pl-coder/LeLovophon/outputs/Lovophone_Corrected_Right_Compositing.md

# Corrected Lovophone - right-view compositing render

The full film covers exactly480 seconds at normal speed: one8-minute ideal mechanical phase cycle, input3 rpm. It is silent. Orthographic RIGHT camera along the native CAD+X axis, matching the supplied screenshot.1008 x900;12 unique motion samples per second. The alpha master stores12 fps and the MP4 stores24 fps with duplicate frames; both run480 seconds at normal speed.

## Choose a file

- Lovophone_Corrected_Right_8min_Alpha.mov: ProRes4444 with alpha,12 fps, approximately2.68 GB. Import directly over your background in a video editor. No colour key is needed. It may look black in players that do not display transparency.
- Lovophone_Corrected_Right_8min_Blue.mp4: H264 copy with pure blue background composited after rendering. Key blue if you need an MP4 workflow. The transparent master will preserve thin strings and edges more reliably than keying compressed colour.
- Lovophone_Corrected_Right_Transparent.blend: self-contained textured scene and corrected animation.
- Preview_10sec files: short samples only; not the full cycle.

No key-colour lighting or spill was added to the instrument: blue is composited afterwards. The rendered alpha is carried separately through mild RGB noise reduction. The full ProRes master was decoded at the midpoint and its alpha checked: range0..65535, fully transparent background corner.

## Timing and design scope

Pitch and cam ratios:1,9/8,5/4,3/2,5/3,2,9/4,5/2,3,10/3,4,9/2. All return after24 input revolutions. Frame1 is nominal time zero. This is the corrected Lab Frame ratio-review animation, retaining its cam/follower and swing-amplifier belt. The separate four-bar physical prototype is not installed in this model.

Motor, obsolete tray, foreground drive plate and selected colliding right-foot hardware are hidden to expose the mechanism. This is a presentation cutaway, not a production clearance or structural solution. Reference pulley envelopes are not approved supplier tooth profiles.

The older Lab Frame MIDI and the separate Unified picking-wheel MIDI do not match this corrected cam/pick animation.120 BPM does not make an old MIDI sequence align. Physical release angles, torque and manufacturing still require prototype tests.
