pl-coder/LeLovophon/outputs/Lovophone_Lab_Frame_Corrected_Readme.md

# Corrected Lab Frame video

The video runs for480 seconds at normal speed and covers one complete ideal mechanical phase cycle. Input speed3 rpm; pitch and cam rotation ratios1,9/8,5/4,3/2,5/3,2,9/4,5/2,3,10/3,4,9/2. All voice phases return after24 input revolutions. No timing correction is achieved by changing video playback speed.

This is the Lab Frame ratio-review model, retaining its cam/follower and swing belt. The separate Prototype A four-bar mechanism has not been fitted to the twelve-voice machine. Reference pulley envelopes were updated. Obsolete tray and colliding right-foot mounting parts are hidden to expose the mechanism; hiding them is not a production mounting solution. The video is an ideal kinematic visualization, not proof of a buildable or tested machine.

1008x720,24 fps encoded,12 unique motion samples per second, silent. Clean CAD studio shading, rather than the older photorealistic material render. Exact480-second endpoint was checked in the animation scene, with maximum matrix coefficient error2.88e-5 from float32 animation sampling.

Do not align this with the older Lab Frame MIDI or the Unified picking-wheel MIDI. A matching MIDI file has not yet been generated from this corrected cam/pick release motion.120 BPM alone cannot correct an old event sequence.
