pl-coder/LeLovophon/outputs/Lovophone_Right_View_Render_Notes.md

# Lovophone: right-view studio film

The camera matches the supplied FreeCAD RIGHT view. The motor, coupling, mounting bracket, controller, switch, power connector and clear motor covers are hidden for presentation. The musical mechanism and supporting frame remain visible.

The full film is eight minutes at normal speed, 24 frames per second, 1008 × 900 pixels. Align the start of the existing eight-minute pentatonic MIDI with video time 0:00; use 120 BPM. The film is silent.

The editable scene retains the actual exported CAD geometry and animation, with procedural wood and metal materials and five studio lights. The supplied still uses Cycles path tracing. The film uses EEVEE with 32 samples and spatial and temporal noise reduction to keep a long render practical. These are presentation materials, not a claim of manufactured finish or a physical performance simulation.

Outputs are created in this order: a 20-second preview, then the complete eight-minute MP4. The final film filename is Lovophone_Right_View_No_Motor_8min.mp4. Until that file appears, the full film has not finished rendering.
