pl-coder/LeLovophon/outputs/Lovophone_Prototype_A/Prototype_A_Drawings.pdf

# Build the mechanism before the instrument

Two independent manual test fixtures: one-string pluck and exact 9:2 drive. No motor purchase required yet.

LE LOVOPHONE | Prototype A | Rev A / 2026-11-05 | mm | QUOTATION & ENGINEERING REVIEW | 1 / 8

Purpose: test the two things the presentation model could not establish - clean mechanical plucking, and a practical high-ratio transmission.

The pluck fixture uses a fully pinned 4-bar: 4 mm crank, 80 mm connecting rod, 14 mm rocker and 80 mm fixed pivot spacing. It forces both directions without a follower spring or 4x swing belt.

The drive fixture uses (60/20) x (30/20) = 9/2 with two nominal 160 mm, 80-tooth, 2 mm pitch, 6 mm wide belts and 5 mm shafts. Supplier profile confirmation is still required.

Lowest voice: C3, 330 mm speaking string, 67.196938 mm arm. Highest voice: D5, 73.333333 mm speaking string, 14.932653 mm arm. Swap arm and string height; do not treat the two as simultaneously assembled voices.

Computed swing: +/-16.662 degrees. Link closure checked at 10,001 phases; minimum transmission angle 68.526 degrees. These are geometric results, not evidence of successful physical plucks.

Procurement gate: DHM lists the belt as GT2 today but S2M in an older catalogue. Its pulley pages also warn of batch dimensional variation. Verify a matched set and hub/flange dimensions before manufacture of spacers or pulley-adjacent parts.

No physical prototype has been built or tested. This packet is for engineering review and quotation; it is not certification that the full Lovophone works.

# R01 / Exact 9:2 drive fixture

2 identical cheeks: aluminium 6061-T6, 180 x 100 x 6. Bearing carriers allow +/-3 mm adjustment.

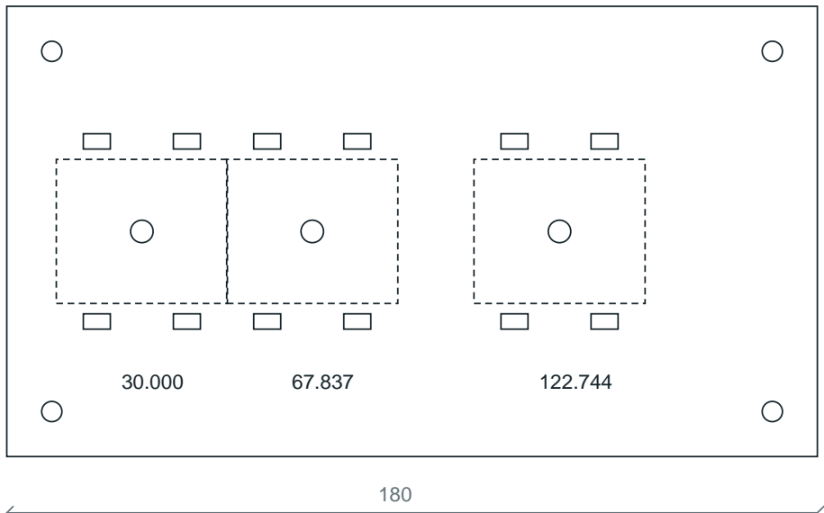
[picture p1: figure]

LE LOVOPHONE | Prototype A | Rev A / 2026-11-05 | mm | QUOTATION & ENGINEERING REVIEW | 2 / 8
37.837 | 54.908

Shafts: (X,Y) = (30,50), (67.836782,50), (122.744491,50). Positions are nominal untensioned pitch geometry.

4 x 4.5 through holes: (10,10), (170,10), (10,90), (170,90).

At each shaft: central relief slot 32 diameter with 6 mm horizontal centre travel (38 x32 overall). Neighbouring reliefs may merge.

Carrier mount slots: 3.4 wide, 6 mm centre travel (9.4 overall), centres at shaft X +/-10;
Y=30 and70. Use STEP for exact rounded slots.

Outside cheek Z=0..6 and56..62; four spacer tubes OD8/ID4.5 x50 between them. M4 threaded tie rods and washers/nuts for bench assembly.

Pulley belt midplanes Z=14 and38. 60/20 first stage, 30/20 second. Intermediate shaft carries 20T and30T clamped together.

Pulley body/hub/flange geometry in assembly CAD is a clearance reservation, not a supplier
drawing. Do not machine reference discs.

# R02 / R03 Bearing carriers and retainers

6 identical carriers; 6 identical retainer disks. Axial load is retained by shoulders and screws.

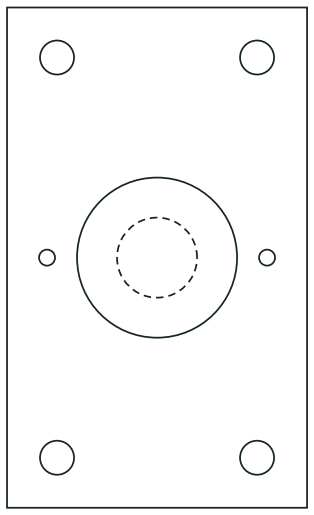
[picture p2: figure]

LE LOVOPHONE | Prototype A | Rev A / 2026-11-05 | mm | QUOTATION & ENGINEERING REVIEW | 3 / 8

R02 - view into bearing pocket

R03 - 1 mm stainless

R02: 30 x50 x6, 6061-T6. Local origin at lower-left. Bearing centre (15,25).

16 H7 pocket (+0/+0.018), depth5 from inner face. 8 through bore leaves a 1 mm outer shoulder. Do not substitute a laser-cut bearing seat.

4 x3.4 through at (5,5),(25,5),(5,45),(25,45).

2 x M2 tapped through, centres (4,25),(26,25). STEP shows 1.6 pilot holes; tap to drawing.

R03: 27 OD /8 ID x1 stainless. 2 x2.2 through at +/-11 along horizontal diameter.

625-ZZ bearings: 5 x16 x5. Retainer screws M2x5; check no screw end protrudes into another part. Front carrier is mirrored in assembly.

Fit 5 mm ground shafts, with separate shaft collars bearing only against inner races. Set axial play without preloading the bearings.

General machined dimensions +/-0.10 unless stated; pocket depths +/-0.03; deburr 0.2 max at bearing shoulder.

# P01 / One-string linkage cheeks

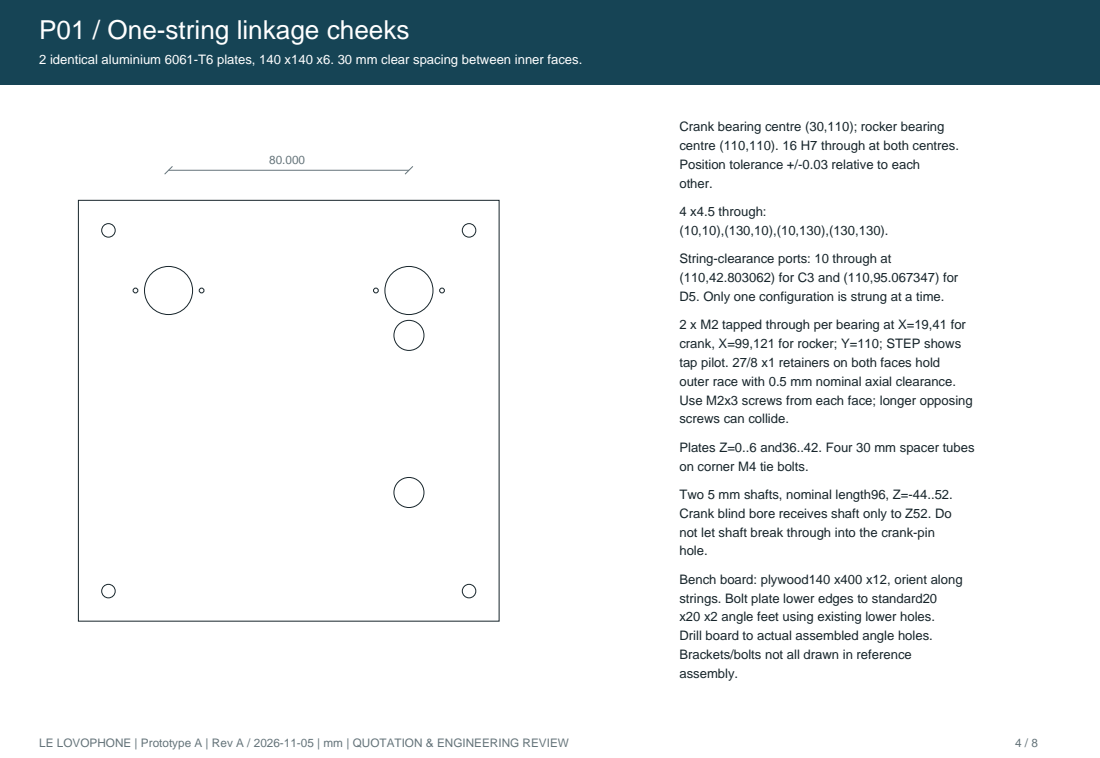
[picture p3: page 4]
LE LOVOPHONE | Prototype A | Rev A / 2026-11-05 | mm | QUOTATION & ENGINEERING REVIEW

2 identical aluminium 6061-T6 plates, 140 x140 x6. 30 mm clear spacing between inner faces.

Crank bearing centre (30,110); rocker bearing
centre (110,110). 16 H7 through at both centres.
Position tolerance +/-0.03 relative to each
other.
4 x4.5 through:
String-clearance ports: 10 through at
(110,42.803062) for C3 and (110,95.067347) for
D5. Only one configuration is strung at a time.
2 x M2 tapped through per bearing at X=19,41 for
crank, X=99,121 for rocker; Y=110; STEP shows
tap pilot. 27/8 x1 retainers on both faces hold
outer race with 0.5 mm nominal axial clearance.
Use M2x3 screws from each face; longer opposing
screws can collide.
Plates Z=0..6 and36..42. Four 30 mm spacer tubes
on corner M4 tie bolts.
Two 5 mm shafts, nominal length96, Z=-44..52.
Crank blind bore receives shaft only to Z52. Do
not let shaft break through into the crank-pin
hole.
Bench board: plywood140 x400 x12, orient along
strings. Bolt plate lower edges to standard20
x20 x2 angle feet using existing lower holes.
Drill board to actual assembled angle holes.
Brackets/bolts not all drawn in reference
assembly.

# P02 / P03 Positive-drive crank and rocker

Split hubs clamp to 5 mm shafts. Small pin hole and large shaft bore are separated axially in the crank.

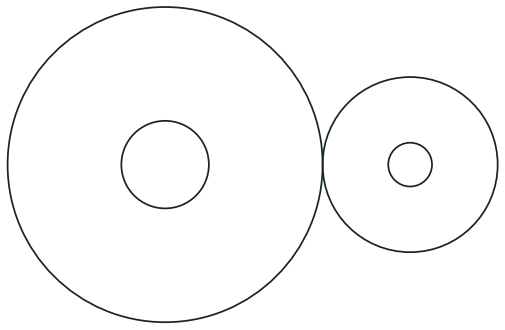
[picture p4: figure]

LE LOVOPHONE | Prototype A | Rev A / 2026-11-05 | mm | QUOTATION & ENGINEERING REVIEW | 5 / 8
P02: 20 OD x12; front view | P03: 14 pin-centre radius

P02: 20 OD x12, 6061-T6. Rear shaft bore5 H7 blind depth6. Front M3 thread blind depth4,
centre at (4,0). Preserve 2 mm web between bore floors.

P03: hub18 OD x12, pin boss10 OD x12, centres14 apart; 10 mm wide x6 connecting web. 5 H7 through hub; M3 blind depth4 from front at pin centre.

Both hubs: rear split0.8 wide from bore towards +Y, depth6. M3 clamping bolt transverse X at localY=6,Z=3. Left half3.4 clearance; right half M3 tapped (STEP pilot2.5). Use M3x16; machine seating flats if required for head and thread engagement.

P02/P03 sit at Z46..58. Both pin flanges sit on
front Z58 so rod journals align.

Do not use an ordinary through-drilled crank: 5
mm shaft and3 mm pin at4 mm spacing would touch. The blind, two-sided construction is deliberate.

Machinist to confirm M3 thread engagement, clamp seating and no split closes fully before
gripping shaft. No adhesive or friction roller substitutes for pin capture.

# P04 / P05 Coupler, arms and replaceable picks

One long arm installed; short arm is a swap part. The two configurations retain inverse musical lengths.

LE LOVOPHONE | Prototype A | Rev A / 2026-11-05 | mm | QUOTATION & ENGINEERING REVIEW | 6 / 8

80 +/-0.05

P04: POM-C, 4 thick, plain bearing link

C3 | D5

P04: POM-C, 4 thick, 10 wide, rounded5-radius ends. Pin centres80 +/-0.05. Two3.02..3.04 through holes for3 h6 journal pins. The rod is a cheap replaceable dry bearing component.

P05 aluminium arms: 18 OD x8 split-clamp hub with5 H7 bore; 6 wide x3 body. Pivot-to-string radius67.196938 (C3) or14.932653 (D5). Rigid tip stops1 mm short.

Pick mount3.4 through at radius R-5 on arm centreline. Hub clamp detail follows P03.

Pick trial strips: PET0.5 thick, 6 wide x7.3 long; 3.4 mounting hole5.3 back from tip. Shim/slot to find minimum reliable string intrusion. CAD shows0.3 mm nominal; this is a test setting, not a proven release geometry.

Arm plane Z=-35..-32; hub toZ=-27. Pick on front faceZ=-32..-31.5. Set arm vertical when rocker is at its measured mid-angle (94.8116 degrees nominal).

Rigid arm must never contact the string. Test both directions; the return stroke may double-pluck or drag. If it does, develop a one-way compliant pick before scaling to twelve voices.

# P07 / P08 Retained pins and string tensioning

Turned journal pins; guided M4 drawbar. Standard threaded fasteners shown as pilot / major cylinders in STEP.

LE LOVOPHONE | Prototype A | Rev A / 2026-11-05 | mm | QUOTATION & ENGINEERING REVIEW | 7 / 8

P07 - TWO IDENTICAL TURNED PINS, STEEL: from rear to front, M3 x4 male root, 5 OD x1 flange, 3 h6 x9 journal, M2 x3 threaded tip. Add standard thread reliefs without reducing the usable journal. Install root into M3 blind crank / rocker
hole; flange seats on front face. Retain with M2 nut and plain washer. Add 3.0 mm and 1.9 mm ID3.1 / OD5 spacers around the4 mm POM link; total stack8.9 leaves nominal0.1 mm axial play. Check free rotation after tightening, and use a locknut
or equivalent positive locking method. Pins are custom turned parts, not plain dowels.

P06 - TWO END POSTS: aluminium6061-T6, 40 x125 x4. Local origin lower-left. Guide holes4.5 through at X20, Y42.803062 and95.067347. At each height add M4-screw clearance4.5 atX30 and guide-rod4 H7 atX10. Bottom mounting holes4.5 at(5,8) and(35,8). Guide holes for nylon need rounded, polished eyelets: no string on a raw aluminium edge.

P08 - TWO GUIDED DRAWBARS: brass or aluminium32 x12 x10. Local origin at centre in XY, rear faceZ0. Through M4 thread at(X10,Y0), guide bore4.2 at(X-10,Y0), nylon cross-hole2.0 alongY at(X0,Z5). Round string hole edgesR0.5 minimum and polish. STEP shows3.3 tap pilot. Use a4 mm smooth guide parallel to the M4 screw to prevent rotation. Start with M4x40
screw at tuning end; capture screw axially with washers/collar or thrust arrangement so turning moves the drawbar rather
than the screw. The exact thrust stack must be checked in assembly before tensioning.

FIXTURE STRING SPAN: first guide atZ-70, second atZ272, total342. Place third bridge atZ260 for C3 (330 mm speaking from Z-70) orZ3.333333 for D5 (73.333333 speaking). Make a smooth removable bridge on a clamped wooden block with adjustable crown height matching the selected guide height. String outside the speaking span can be damped. A portable soundbox is not required for this force/release test.

ANCHORING: use an unwound nylon test string with smooth tie-block loops/knots at the drawbars. Do not trap nylon against a grub-screw point. Bring up tension gradually with eye protection and keep the bench clamped down. This is an adult workshop test fixture, not a classroom article.

# Assembly, measurements and release gates

Hand crank first. A motor cannot fix a mechanism that binds or fails to release the string.

LE LOVOPHONE | Prototype A | Rev A / 2026-11-05 | mm | QUOTATION & ENGINEERING REVIEW | 8 / 8
1. Assemble the two fixtures independently. Verify carrier and shaft alignment, positive bearing retention, free rotation and fastener access. Set belt planes with actual purchased parts; confirm GT2 tooth compatibility with supplier before tightening. Use the slots to tension only enough to prevent tooth jumping.
2. Turn the pluck crank manually through at least two full revolutions before stringing. Verify there is no toggle,
rubbing link, binding POM journal or shaft interference. Set the vertical arm at rocker mid-angle. Fit the long C3 arm and its low string configuration first.
3. Tune C3 with a tuner to130.8128 Hz. For the nominal0.8 mm nylon /1150 kg/m3 model, the ideal tension is about43.1 N (verify actual linear density; this is not a measured safe rating). Sweep pick intrusion from zero upwards in small steps. Record release angle, double-plucks, return drag, string damage and sound.
4. Measure crank torque with a spring scale at a known radius. At50 mm radius, torque[Nm] = force[N] x0.050. Record peak and running torque for string off/on and each pick thickness. Do not size a motor from stall torque. Repeat with the short
D5 arm and73.333 mm speaking length; target588.6575 Hz.
5. Mark the ratio fixture shafts. Two input turns must produce nine output turns in the same direction. Run at3 rpm input /13.5 rpm output. Record belt tracking, backlash, tooth jumping and peak input torque; include the connected pluck module through an aligned5-to5 coupling after standalone tests. The separate fixtures are not coupled in the reference CAD.
6. Endurance: run1000 plucks at the final intended setting as an initial screening test, inspect nylon and picks, retighten/check fasteners and record any missed/double plucks. This is a proposed acceptance screen, not a validated service-life specification. Stop for cracks, pin migration, slipping clamps or fraying string.
7. Only then choose the motor and closed-loop speed control from measured torque and starting margin; preserve mechanical pitch/rotation ratios. Twelve synchronous plucks can add their reflected torque. One voice does not establish twelve-voice peak load, soundbox strength or final portable layout.

FABRICATION GATES: machinist confirms threads/fit tolerances and pin/clamp details; supplier confirms matched belt tooth profile and pulley dimensions; assemble complete base brackets, guide eyelets and tensioner thrust capture; perform physical release/force tests. None of these physical checks is claimed passed. Exact bought-parts candidates and source links are in the BOM/README.
