pl-coder/LeLovophon/outputs/Lovophone_Lab_Frame_Procurement_Inventory.csv

object | label | quantity_in_model | route | supplier_candidate | status | bbox_x_mm | bbox_y_mm | bbox_z_mm
Baseplate_310x170x6 | 3 mm soundboard lid — removable from plywood rim | 1 | CNC-routed timber / plywood | Online wood CNC service to confirm | Material, grain, glue joints and acoustic response pending | 370.0 | 3.0 | 140.0
CommonInputShaft_D6 | Long common drive shaft — input pulleys turn together | 1 | Cut standard tube / rod / precision shaft | Stock supplier; cut service | Smooth bearing journals; rod tolerances and actual joint allowances to specify | 314.25 | 6.0 | 6.0
LowGearboxTray | Drive deck — plain 288 × 78 × 6 mm plywood rectangle | 1 | Custom or catalogue equivalent — review interface | Engineering review | No verified purchased replacement yet | 288.0 | 6.0 | 78.0
C_RaisedArmShaft | C3 — RaisedArmShaft | 1 | Cut standard tube / rod / precision shaft | Stock supplier; cut service | Smooth bearing journals; rod tolerances and actual joint allowances to specify | 27.5 | 6.0 | 6.0
C_ExtendedArm | C3 — ExtendedArm | 1 | Custom flat cut / drilled component | John Steel / Xometry | DXF plus thickness; bearing bores and precision holes need machining drawing | 3.0 | 70.366 | 27.418
C_ExtendedPick | C3 — nominal 0.1 mm string engagement | 1 | Replaceable wear component / printed prototype | Sculpteo PA12 / stock | Functional material and wear test needed; printing is not default for precision fits | 3.3 | 1.007 | 0.741
D_RaisedArmShaft | E3 — RaisedArmShaft | 1 | Cut standard tube / rod / precision shaft | Stock supplier; cut service | Smooth bearing journals; rod tolerances and actual joint allowances to specify | 27.5 | 6.0 | 6.0
D_ExtendedArm | E3 — ExtendedArm | 1 | Custom flat cut / drilled component | John Steel / Xometry | DXF plus thickness; bearing bores and precision holes need machining drawing | 3.0 | 57.943 | 21.791
D_ExtendedPick | E3 — nominal 0.1 mm string engagement | 1 | Replaceable wear component / printed prototype | Sculpteo PA12 / stock | Functional material and wear test needed; printing is not default for precision fits | 3.3 | 0.999 | 0.717
E_RaisedArmShaft | A3 — RaisedArmShaft | 1 | Cut standard tube / rod / precision shaft | Stock supplier; cut service | Smooth bearing journals; rod tolerances and actual joint allowances to specify | 27.5 | 6.0 | 6.0
E_ExtendedArm | A3 — ExtendedArm | 1 | Custom flat cut / drilled component | John Steel / Xometry | DXF plus thickness; bearing bores and precision holes need machining drawing | 3.0 | 45.551 | 14.959
E_ExtendedPick | A3 — nominal 0.1 mm string engagement | 1 | Replaceable wear component / printed prototype | Sculpteo PA12 / stock | Functional material and wear test needed; printing is not default for precision fits | 3.3 | 0.974 | 0.65
F_RaisedArmShaft | C4 — RaisedArmShaft | 1 | Cut standard tube / rod / precision shaft | Stock supplier; cut service | Smooth bearing journals; rod tolerances and actual joint allowances to specify | 27.5 | 6.0 | 6.0
F_ExtendedArm | C4 — ExtendedArm | 1 | Custom flat cut / drilled component | John Steel / Xometry | DXF plus thickness; bearing bores and precision holes need machining drawing | 3.0 | 39.06 | 12.516
F_ExtendedPick | C4 — nominal 0.1 mm string engagement | 1 | Replaceable wear component / printed prototype | Sculpteo PA12 / stock | Functional material and wear test needed; printing is not default for precision fits | 3.3 | 0.96 | 0.619
G_RaisedArmShaft | E4 — RaisedArmShaft | 1 | Cut standard tube / rod / precision shaft | Stock supplier; cut service | Smooth bearing journals; rod tolerances and actual joint allowances to specify | 27.5 | 6.0 | 6.0
G_ExtendedArm | E4 — ExtendedArm | 1 | Custom flat cut / drilled component | John Steel / Xometry | DXF plus thickness; bearing bores and precision holes need machining drawing | 3.0 | 32.454 | 12.0
G_ExtendedPick | E4 — nominal 0.1 mm string engagement | 1 | Replaceable wear component / printed prototype | Sculpteo PA12 / stock | Functional material and wear test needed; printing is not default for precision fits | 3.3 | 0.938 | 0.573
SoundboxShell | Shallow plywood soundbox — 6 mm sides, 4 mm bottom | 1 | CNC-routed timber / plywood | Online wood CNC service to confirm | Material, grain, glue joints and acoustic response pending | 370.0 | 45.0 | 140.0
SoundboxEndBlock0 | SoundboxEndBlock0 | 1 | CNC-routed timber / plywood | Online wood CNC service to confirm | Material, grain, glue joints and acoustic response pending | 14.0 | 41.0 | 128.0
SoundboxEndBlock1 | SoundboxEndBlock1 | 1 | CNC-routed timber / plywood | Online wood CNC service to confirm | Material, grain, glue joints and acoustic response pending | 14.0 | 41.0 | 128.0
SoundboxFoot1 | SoundboxFoot1 | 1 | CNC-routed timber / plywood | Online wood CNC service to confirm | Material, grain, glue joints and acoustic response pending | 20.0 | 6.0 | 20.0
SoundboxFoot3 | SoundboxFoot3 | 1 | CNC-routed timber / plywood | Online wood CNC service to confirm | Material, grain, glue joints and acoustic response pending | 20.0 | 6.0 | 20.0
A_RaisedArmShaft | A4 — RaisedArmShaft | 1 | Cut standard tube / rod / precision shaft | Stock supplier; cut service | Smooth bearing journals; rod tolerances and actual joint allowances to specify | 27.5 | 6.0 | 6.0
A_ExtendedArm | A4 — ExtendedArm | 1 | Custom flat cut / drilled component | John Steel / Xometry | DXF plus thickness; bearing bores and precision holes need machining drawing | 3.0 | 25.238 | 12.0
A_ExtendedPick | A4 — nominal 0.1 mm string engagement | 1 | Replaceable wear component / printed prototype | Sculpteo PA12 / stock | Functional material and wear test needed; printing is not default for precision fits | 3.3 | 1.425 | 0.573
CommonIntermediateAxle | Second long axle — fixed spindle, six independent pulley units | 1 | Cut standard tube / rod / precision shaft | Stock supplier; cut service | Smooth bearing journals; rod tolerances and actual joint allowances to specify | 307.85 | 6.0 | 6.0
C_RatioDrivePulley | C3 — 32 tooth pitch envelope (NOT manufacturing teeth) | 1 | Catalogue timing drive preferred; interface redesign needed | MISUMI / HPC / specialist | Reference envelope only; no approved SKU, width, tooth form, hub or belt length | 5.0 | 20.372 | 20.372
C_RatioDrivenPulley | C3 — 32 tooth pitch envelope (NOT manufacturing teeth)001 | 1 | Catalogue timing drive preferred; interface redesign needed | MISUMI / HPC / specialist | Reference envelope only; no approved SKU, width, tooth form, hub or belt length | 5.0 | 20.372 | 20.372
C_CompoundPulleyHub | C3 — CompoundPulleyHub | 1 | Custom machined fitting; consolidate repeated families | Xometry / Protolabs Network | STEP plus drawing; fits, threads, captive nuts, splits and clamp travel not detailed | 11.25 | 12.0 | 12.0
C_IndependentPulleyBearing | C3 — IndependentPulleyBearing | 1 | Catalogue bearing / bush — match drawing | 123Roulement | Confirm dimensions, clearance and retention; not every bearing has the same size | 10.5 | 10.0 | 10.0
C_RatioBelt | C3 — RatioBelt | 1 | Catalogue timing drive preferred; interface redesign needed | MISUMI / HPC / specialist | Reference envelope only; no approved SKU, width, tooth form, hub or belt length | 5.0 | 45.972 | 36.972
D_RatioDrivePulley | E3 — 40 tooth pitch envelope (NOT manufacturing teeth) | 1 | Catalogue timing drive preferred; interface redesign needed | MISUMI / HPC / specialist | Reference envelope only; no approved SKU, width, tooth form, hub or belt length | 5.0 | 25.465 | 25.465
D_RatioDrivenPulley | E3 — 32 tooth pitch envelope (NOT manufacturing teeth) | 1 | Catalogue timing drive preferred; interface redesign needed | MISUMI / HPC / specialist | Reference envelope only; no approved SKU, width, tooth form, hub or belt length | 5.0 | 20.372 | 20.372
D_CompoundPulleyHub | E3 — CompoundPulleyHub | 1 | Custom machined fitting; consolidate repeated families | Xometry / Protolabs Network | STEP plus drawing; fits, threads, captive nuts, splits and clamp travel not detailed | 11.25 | 12.0 | 12.0
D_IndependentPulleyBearing | E3 — IndependentPulleyBearing | 1 | Catalogue bearing / bush — match drawing | 123Roulement | Confirm dimensions, clearance and retention; not every bearing has the same size | 10.5 | 10.0 | 10.0
D_RatioBelt | E3 — RatioBelt | 1 | Catalogue timing drive preferred; interface redesign needed | MISUMI / HPC / specialist | Reference envelope only; no approved SKU, width, tooth form, hub or belt length | 5.0 | 48.518 | 39.518
E_RatioDrivePulley | A3 — 40 tooth pitch envelope (NOT manufacturing teeth) | 1 | Catalogue timing drive preferred; interface redesign needed | MISUMI / HPC / specialist | Reference envelope only; no approved SKU, width, tooth form, hub or belt length | 5.0 | 25.465 | 25.465
E_RatioDrivenPulley | A3 — 24 tooth pitch envelope (NOT manufacturing teeth) | 1 | Catalogue timing drive preferred; interface redesign needed | MISUMI / HPC / specialist | Reference envelope only; no approved SKU, width, tooth form, hub or belt length | 5.0 | 15.279 | 15.279
E_CompoundPulleyHub | A3 — CompoundPulleyHub | 1 | Custom machined fitting; consolidate repeated families | Xometry / Protolabs Network | STEP plus drawing; fits, threads, captive nuts, splits and clamp travel not detailed | 11.25 | 12.0 | 12.0
E_IndependentPulleyBearing | A3 — IndependentPulleyBearing | 1 | Catalogue bearing / bush — match drawing | 123Roulement | Confirm dimensions, clearance and retention; not every bearing has the same size | 10.5 | 10.0 | 10.0
E_RatioBelt | A3 — RatioBelt | 1 | Catalogue timing drive preferred; interface redesign needed | MISUMI / HPC / specialist | Reference envelope only; no approved SKU, width, tooth form, hub or belt length | 5.0 | 45.972 | 36.972
F_RatioDrivePulley | C4 — 48 tooth pitch envelope (NOT manufacturing teeth) | 1 | Catalogue timing drive preferred; interface redesign needed | MISUMI / HPC / specialist | Reference envelope only; no approved SKU, width, tooth form, hub or belt length | 5.0 | 30.558 | 30.558
F_RatioDrivenPulley | C4 — 24 tooth pitch envelope (NOT manufacturing teeth) | 1 | Catalogue timing drive preferred; interface redesign needed | MISUMI / HPC / specialist | Reference envelope only; no approved SKU, width, tooth form, hub or belt length | 5.0 | 15.279 | 15.279
F_CompoundPulleyHub | C4 — CompoundPulleyHub | 1 | Custom machined fitting; consolidate repeated families | Xometry / Protolabs Network | STEP plus drawing; fits, threads, captive nuts, splits and clamp travel not detailed | 11.25 | 12.0 | 12.0
F_IndependentPulleyBearing | C4 — IndependentPulleyBearing | 1 | Catalogue bearing / bush — match drawing | 123Roulement | Confirm dimensions, clearance and retention; not every bearing has the same size | 10.5 | 10.0 | 10.0
F_RatioBelt | C4 — RatioBelt | 1 | Catalogue timing drive preferred; interface redesign needed | MISUMI / HPC / specialist | Reference envelope only; no approved SKU, width, tooth form, hub or belt length | 5.0 | 48.518 | 39.518
G_RatioDrivePulley | E4 — 60 tooth pitch envelope (NOT manufacturing teeth) | 1 | Catalogue timing drive preferred; interface redesign needed | MISUMI / HPC / specialist | Reference envelope only; no approved SKU, width, tooth form, hub or belt length | 5.0 | 38.197 | 38.197
G_RatioDrivenPulley | E4 — 24 tooth pitch envelope (NOT manufacturing teeth) | 1 | Catalogue timing drive preferred; interface redesign needed | MISUMI / HPC / specialist | Reference envelope only; no approved SKU, width, tooth form, hub or belt length | 5.0 | 15.279 | 15.279
G_CompoundPulleyHub | E4 — CompoundPulleyHub | 1 | Custom machined fitting; consolidate repeated families | Xometry / Protolabs Network | STEP plus drawing; fits, threads, captive nuts, splits and clamp travel not detailed | 11.25 | 12.0 | 12.0
G_IndependentPulleyBearing | E4 — IndependentPulleyBearing | 1 | Catalogue bearing / bush — match drawing | 123Roulement | Confirm dimensions, clearance and retention; not every bearing has the same size | 10.5 | 10.0 | 10.0
G_RatioBelt | E4 — RatioBelt | 1 | Catalogue timing drive preferred; interface redesign needed | MISUMI / HPC / specialist | Reference envelope only; no approved SKU, width, tooth form, hub or belt length | 5.0 | 52.338 | 43.338
A_RatioDrivePulley | A4 — 60 tooth pitch envelope (NOT manufacturing teeth) | 1 | Catalogue timing drive preferred; interface redesign needed | MISUMI / HPC / specialist | Reference envelope only; no approved SKU, width, tooth form, hub or belt length | 5.0 | 38.197 | 38.197
A_RatioDrivenPulley | A4 — 18 tooth pitch envelope (NOT manufacturing teeth) | 1 | Catalogue timing drive preferred; interface redesign needed | MISUMI / HPC / specialist | Reference envelope only; no approved SKU, width, tooth form, hub or belt length | 5.0 | 11.459 | 11.459
A_CompoundPulleyHub | A4 — CompoundPulleyHub | 1 | Custom machined fitting; consolidate repeated families | Xometry / Protolabs Network | STEP plus drawing; fits, threads, captive nuts, splits and clamp travel not detailed | 11.25 | 12.0 | 12.0
A_IndependentPulleyBearing | A4 — IndependentPulleyBearing | 1 | Catalogue bearing / bush — match drawing | 123Roulement | Confirm dimensions, clearance and retention; not every bearing has the same size | 10.5 | 10.0 | 10.0
A_RatioBelt | A4 — RatioBelt | 1 | Catalogue timing drive preferred; interface redesign needed | MISUMI / HPC / specialist | Reference envelope only; no approved SKU, width, tooth form, hub or belt length | 5.0 | 50.428 | 41.428
KotoAnchorBlock | KotoAnchorBlock | 1 | Custom or catalogue equivalent — review interface | Engineering review | No verified purchased replacement yet | 16.0 | 16.4 | 136.0
KotoAnchorSaddleRail | KotoAnchorSaddleRail | 1 | Custom or catalogue equivalent — review interface | Engineering review | No verified purchased replacement yet | 4.0 | 1.2 | 130.0
KotoTunerBlock | KotoTunerBlock | 1 | Custom or catalogue equivalent — review interface | Engineering review | No verified purchased replacement yet | 16.0 | 16.4 | 136.0
KotoTunerSaddleRail | KotoTunerSaddleRail | 1 | Custom or catalogue equivalent — review interface | Engineering review | No verified purchased replacement yet | 4.0 | 1.2 | 130.0
C_KotoSpeakingString | C3 — KotoSpeakingString | 1 | Catalogue unwound nylon string | Music string supplier | Nominal 0.8 mm only; physical tuning, creep and total tension to verify | 330.0 | 0.8 | 0.8
C_KotoBackString | C3 — KotoBackString | 1 | Catalogue unwound nylon string | Music string supplier | Nominal 0.8 mm only; physical tuning, creep and total tension to verify | 12.0 | 0.8 | 0.8
C_KotoThirdBridge | C3 — KotoThirdBridge | 1 | Custom or catalogue equivalent — review interface | Engineering review | No verified purchased replacement yet | 12.0 | 17.4 | 6.0
C_PendulumBearing0 | C3 — PendulumBearing0 | 1 | Catalogue bearing / bush — match drawing | 123Roulement | Confirm dimensions, clearance and retention; not every bearing has the same size | 4.0 | 12.0 | 12.0
C_PendulumBearing1 | C3 — PendulumBearing1 | 1 | Catalogue bearing / bush — match drawing | 123Roulement | Confirm dimensions, clearance and retention; not every bearing has the same size | 4.0 | 12.0 | 12.0
D_KotoSpeakingString | E3 — KotoSpeakingString | 1 | Catalogue unwound nylon string | Music string supplier | Nominal 0.8 mm only; physical tuning, creep and total tension to verify | 264.0 | 0.8 | 0.8
D_KotoBackString | E3 — KotoBackString | 1 | Catalogue unwound nylon string | Music string supplier | Nominal 0.8 mm only; physical tuning, creep and total tension to verify | 78.0 | 0.8 | 0.8
D_KotoThirdBridge | E3 — KotoThirdBridge | 1 | Custom or catalogue equivalent — review interface | Engineering review | No verified purchased replacement yet | 12.0 | 17.4 | 6.0
D_PendulumBearing0 | E3 — PendulumBearing0 | 1 | Catalogue bearing / bush — match drawing | 123Roulement | Confirm dimensions, clearance and retention; not every bearing has the same size | 4.0 | 12.0 | 12.0
D_PendulumBearing1 | E3 — PendulumBearing1 | 1 | Catalogue bearing / bush — match drawing | 123Roulement | Confirm dimensions, clearance and retention; not every bearing has the same size | 4.0 | 12.0 | 12.0
E_KotoSpeakingString | A3 — KotoSpeakingString | 1 | Catalogue unwound nylon string | Music string supplier | Nominal 0.8 mm only; physical tuning, creep and total tension to verify | 198.0 | 0.8 | 0.8
E_KotoBackString | A3 — KotoBackString | 1 | Catalogue unwound nylon string | Music string supplier | Nominal 0.8 mm only; physical tuning, creep and total tension to verify | 144.0 | 0.8 | 0.8
E_KotoThirdBridge | A3 — KotoThirdBridge | 1 | Custom or catalogue equivalent — review interface | Engineering review | No verified purchased replacement yet | 12.0 | 17.4 | 6.0
E_PendulumBearing0 | A3 — PendulumBearing0 | 1 | Catalogue bearing / bush — match drawing | 123Roulement | Confirm dimensions, clearance and retention; not every bearing has the same size | 4.0 | 12.0 | 12.0
E_PendulumBearing1 | A3 — PendulumBearing1 | 1 | Catalogue bearing / bush — match drawing | 123Roulement | Confirm dimensions, clearance and retention; not every bearing has the same size | 4.0 | 12.0 | 12.0
F_KotoSpeakingString | C4 — KotoSpeakingString | 1 | Catalogue unwound nylon string | Music string supplier | Nominal 0.8 mm only; physical tuning, creep and total tension to verify | 165.0 | 0.8 | 0.8
F_KotoBackString | C4 — KotoBackString | 1 | Catalogue unwound nylon string | Music string supplier | Nominal 0.8 mm only; physical tuning, creep and total tension to verify | 177.0 | 0.8 | 0.8
F_KotoThirdBridge | C4 — KotoThirdBridge | 1 | Custom or catalogue equivalent — review interface | Engineering review | No verified purchased replacement yet | 12.0 | 17.4 | 6.0
F_PendulumBearing0 | C4 — PendulumBearing0 | 1 | Catalogue bearing / bush — match drawing | 123Roulement | Confirm dimensions, clearance and retention; not every bearing has the same size | 4.0 | 12.0 | 12.0
F_PendulumBearing1 | C4 — PendulumBearing1 | 1 | Catalogue bearing / bush — match drawing | 123Roulement | Confirm dimensions, clearance and retention; not every bearing has the same size | 4.0 | 12.0 | 12.0
G_KotoSpeakingString | E4 — KotoSpeakingString | 1 | Catalogue unwound nylon string | Music string supplier | Nominal 0.8 mm only; physical tuning, creep and total tension to verify | 132.0 | 0.8 | 0.8
G_KotoBackString | E4 — KotoBackString | 1 | Catalogue unwound nylon string | Music string supplier | Nominal 0.8 mm only; physical tuning, creep and total tension to verify | 210.0 | 0.8 | 0.8
G_KotoThirdBridge | E4 — KotoThirdBridge | 1 | Custom or catalogue equivalent — review interface | Engineering review | No verified purchased replacement yet | 12.0 | 17.4 | 6.0
G_PendulumBearing0 | E4 — PendulumBearing0 | 1 | Catalogue bearing / bush — match drawing | 123Roulement | Confirm dimensions, clearance and retention; not every bearing has the same size | 4.0 | 12.0 | 12.0
G_PendulumBearing1 | E4 — PendulumBearing1 | 1 | Catalogue bearing / bush — match drawing | 123Roulement | Confirm dimensions, clearance and retention; not every bearing has the same size | 4.0 | 12.0 | 12.0
A_KotoSpeakingString | A4 — KotoSpeakingString | 1 | Catalogue unwound nylon string | Music string supplier | Nominal 0.8 mm only; physical tuning, creep and total tension to verify | 99.0 | 0.8 | 0.8
A_KotoBackString | A4 — KotoBackString | 1 | Catalogue unwound nylon string | Music string supplier | Nominal 0.8 mm only; physical tuning, creep and total tension to verify | 243.0 | 0.8 | 0.8
A_KotoThirdBridge | A4 — KotoThirdBridge | 1 | Custom or catalogue equivalent — review interface | Engineering review | No verified purchased replacement yet | 12.0 | 17.4 | 6.0
A_PendulumBearing0 | A4 — PendulumBearing0 | 1 | Catalogue bearing / bush — match drawing | 123Roulement | Confirm dimensions, clearance and retention; not every bearing has the same size | 4.0 | 12.0 | 12.0
A_PendulumBearing1 | A4 — PendulumBearing1 | 1 | Catalogue bearing / bush — match drawing | 123Roulement | Confirm dimensions, clearance and retention; not every bearing has the same size | 4.0 | 12.0 | 12.0
C_EccentricCam | C3 — EccentricCam | 1 | Custom or catalogue equivalent — review interface | Engineering review | No verified purchased replacement yet | 3.0 | 24.0 | 24.0
C_FollowerLever | C3 — FollowerLever | 1 | Custom flat cut / drilled component | John Steel / Xometry | DXF plus thickness; bearing bores and precision holes need machining drawing | 2.5 | 60.826 | 26.811
C_FollowerRoller | C3 — FollowerRoller | 1 | Custom or catalogue equivalent — review interface | Engineering review | No verified purchased replacement yet | 3.0 | 6.0 | 6.0
C_RollerPin | C3 — RollerPin | 1 | Custom or catalogue equivalent — review interface | Engineering review | No verified purchased replacement yet | 6.0 | 2.0 | 2.0
C_ReturnSpringEnvelope | C3 — ReturnSpringEnvelope | 1 | Catalogue spring to size | Spring supplier | Return torque, preload and fatigue not sized | 1.0 | 10.0 | 10.0
D_EccentricCam | E3 — EccentricCam | 1 | Custom or catalogue equivalent — review interface | Engineering review | No verified purchased replacement yet | 3.0 | 24.0 | 24.0
D_FollowerLever | E3 — FollowerLever | 1 | Custom flat cut / drilled component | John Steel / Xometry | DXF plus thickness; bearing bores and precision holes need machining drawing | 2.5 | 48.936 | 45.373
D_FollowerRoller | E3 — FollowerRoller | 1 | Custom or catalogue equivalent — review interface | Engineering review | No verified purchased replacement yet | 3.0 | 6.0 | 6.0
D_RollerPin | E3 — RollerPin | 1 | Custom or catalogue equivalent — review interface | Engineering review | No verified purchased replacement yet | 6.0 | 2.0 | 2.0
D_ReturnSpringEnvelope | E3 — ReturnSpringEnvelope | 1 | Catalogue spring to size | Spring supplier | Return torque, preload and fatigue not sized | 1.0 | 10.0 | 10.0
E_EccentricCam | A3 — EccentricCam | 1 | Custom or catalogue equivalent — review interface | Engineering review | No verified purchased replacement yet | 3.0 | 24.0 | 24.0
E_FollowerLever | A3 — FollowerLever | 1 | Custom flat cut / drilled component | John Steel / Xometry | DXF plus thickness; bearing bores and precision holes need machining drawing | 2.5 | 39.648 | 63.082
E_FollowerRoller | A3 — FollowerRoller | 1 | Custom or catalogue equivalent — review interface | Engineering review | No verified purchased replacement yet | 3.0 | 6.0 | 6.0
E_RollerPin | A3 — RollerPin | 1 | Custom or catalogue equivalent — review interface | Engineering review | No verified purchased replacement yet | 6.0 | 2.0 | 2.0
E_ReturnSpringEnvelope | A3 — ReturnSpringEnvelope | 1 | Catalogue spring to size | Spring supplier | Return torque, preload and fatigue not sized | 1.0 | 10.0 | 10.0
F_EccentricCam | C4 — EccentricCam | 1 | Custom or catalogue equivalent — review interface | Engineering review | No verified purchased replacement yet | 3.0 | 24.0 | 24.0
F_FollowerLever | C4 — FollowerLever | 1 | Custom flat cut / drilled component | John Steel / Xometry | DXF plus thickness; bearing bores and precision holes need machining drawing | 2.5 | 35.117 | 71.886
F_FollowerRoller | C4 — FollowerRoller | 1 | Custom or catalogue equivalent — review interface | Engineering review | No verified purchased replacement yet | 3.0 | 6.0 | 6.0
F_RollerPin | C4 — RollerPin | 1 | Custom or catalogue equivalent — review interface | Engineering review | No verified purchased replacement yet | 6.0 | 2.0 | 2.0
F_ReturnSpringEnvelope | C4 — ReturnSpringEnvelope | 1 | Catalogue spring to size | Spring supplier | Return torque, preload and fatigue not sized | 1.0 | 10.0 | 10.0
G_EccentricCam | E4 — EccentricCam | 1 | Custom or catalogue equivalent — review interface | Engineering review | No verified purchased replacement yet | 3.0 | 24.0 | 24.0
G_FollowerLever | E4 — FollowerLever | 1 | Custom flat cut / drilled component | John Steel / Xometry | DXF plus thickness; bearing bores and precision holes need machining drawing | 2.5 | 28.098 | 89.981
G_FollowerRoller | E4 — FollowerRoller | 1 | Custom or catalogue equivalent — review interface | Engineering review | No verified purchased replacement yet | 3.0 | 6.0 | 6.0
G_RollerPin | E4 — RollerPin | 1 | Custom or catalogue equivalent — review interface | Engineering review | No verified purchased replacement yet | 6.0 | 2.0 | 2.0
G_ReturnSpringEnvelope | E4 — ReturnSpringEnvelope | 1 | Catalogue spring to size | Spring supplier | Return torque, preload and fatigue not sized | 1.0 | 10.0 | 10.0
A_EccentricCam | A4 — EccentricCam | 1 | Custom or catalogue equivalent — review interface | Engineering review | No verified purchased replacement yet | 3.0 | 24.0 | 24.0
A_FollowerLever | A4 — FollowerLever | 1 | Custom flat cut / drilled component | John Steel / Xometry | DXF plus thickness; bearing bores and precision holes need machining drawing | 2.5 | 22.899 | 108.703
A_FollowerRoller | A4 — FollowerRoller | 1 | Custom or catalogue equivalent — review interface | Engineering review | No verified purchased replacement yet | 3.0 | 6.0 | 6.0
A_RollerPin | A4 — RollerPin | 1 | Custom or catalogue equivalent — review interface | Engineering review | No verified purchased replacement yet | 6.0 | 2.0 | 2.0
A_ReturnSpringEnvelope | A4 — ReturnSpringEnvelope | 1 | Catalogue spring to size | Spring supplier | Return torque, preload and fatigue not sized | 1.0 | 10.0 | 10.0
C_FollowerSwingShaft | C3 — FollowerSwingShaft | 1 | Cut standard tube / rod / precision shaft | Stock supplier; cut service | Smooth bearing journals; rod tolerances and actual joint allowances to specify | 17.75 | 6.0 | 6.0
C_SwingDrivePulley | C3 — SwingDrivePulley | 1 | Catalogue timing drive preferred; interface redesign needed | MISUMI / HPC / specialist | Reference envelope only; no approved SKU, width, tooth form, hub or belt length | 3.0 | 40.744 | 40.744
C_SwingDrivenPulley | C3 — SwingDrivenPulley | 1 | Catalogue timing drive preferred; interface redesign needed | MISUMI / HPC / specialist | Reference envelope only; no approved SKU, width, tooth form, hub or belt length | 3.0 | 10.186 | 10.186
C_SwingStepUpBelt | C3 — SwingStepUpBelt | 1 | Catalogue timing drive preferred; interface redesign needed | MISUMI / HPC / specialist | Reference envelope only; no approved SKU, width, tooth form, hub or belt length | 3.0 | 45.065 | 57.065
C_FollowerPivotBearing0 | C3 — FollowerPivotBearing0 | 1 | Catalogue bearing / bush — match drawing | 123Roulement | Confirm dimensions, clearance and retention; not every bearing has the same size | 4.0 | 12.0 | 12.0
C_FollowerPivotBearing1 | C3 — FollowerPivotBearing1 | 1 | Catalogue bearing / bush — match drawing | 123Roulement | Confirm dimensions, clearance and retention; not every bearing has the same size | 4.0 | 12.0 | 12.0
D_FollowerSwingShaft | E3 — FollowerSwingShaft | 1 | Cut standard tube / rod / precision shaft | Stock supplier; cut service | Smooth bearing journals; rod tolerances and actual joint allowances to specify | 17.75 | 6.0 | 6.0
D_SwingDrivePulley | E3 — SwingDrivePulley | 1 | Catalogue timing drive preferred; interface redesign needed | MISUMI / HPC / specialist | Reference envelope only; no approved SKU, width, tooth form, hub or belt length | 3.0 | 40.744 | 40.744
D_SwingDrivenPulley | E3 — SwingDrivenPulley | 1 | Catalogue timing drive preferred; interface redesign needed | MISUMI / HPC / specialist | Reference envelope only; no approved SKU, width, tooth form, hub or belt length | 3.0 | 10.186 | 10.186
D_SwingStepUpBelt | E3 — SwingStepUpBelt | 1 | Catalogue timing drive preferred; interface redesign needed | MISUMI / HPC / specialist | Reference envelope only; no approved SKU, width, tooth form, hub or belt length | 3.0 | 51.038 | 57.065
D_FollowerPivotBearing0 | E3 — FollowerPivotBearing0 | 1 | Catalogue bearing / bush — match drawing | 123Roulement | Confirm dimensions, clearance and retention; not every bearing has the same size | 4.0 | 12.0 | 12.0
D_FollowerPivotBearing1 | E3 — FollowerPivotBearing1 | 1 | Catalogue bearing / bush — match drawing | 123Roulement | Confirm dimensions, clearance and retention; not every bearing has the same size | 4.0 | 12.0 | 12.0
E_FollowerSwingShaft | A3 — FollowerSwingShaft | 1 | Cut standard tube / rod / precision shaft | Stock supplier; cut service | Smooth bearing journals; rod tolerances and actual joint allowances to specify | 17.75 | 6.0 | 6.0
E_SwingDrivePulley | A3 — SwingDrivePulley | 1 | Catalogue timing drive preferred; interface redesign needed | MISUMI / HPC / specialist | Reference envelope only; no approved SKU, width, tooth form, hub or belt length | 3.0 | 40.744 | 40.744
E_SwingDrivenPulley | A3 — SwingDrivenPulley | 1 | Catalogue timing drive preferred; interface redesign needed | MISUMI / HPC / specialist | Reference envelope only; no approved SKU, width, tooth form, hub or belt length | 3.0 | 10.186 | 10.186
E_SwingStepUpBelt | A3 — SwingStepUpBelt | 1 | Catalogue timing drive preferred; interface redesign needed | MISUMI / HPC / specialist | Reference envelope only; no approved SKU, width, tooth form, hub or belt length | 3.0 | 58.504 | 57.065
E_FollowerPivotBearing0 | A3 — FollowerPivotBearing0 | 1 | Catalogue bearing / bush — match drawing | 123Roulement | Confirm dimensions, clearance and retention; not every bearing has the same size | 4.0 | 12.0 | 12.0
E_FollowerPivotBearing1 | A3 — FollowerPivotBearing1 | 1 | Catalogue bearing / bush — match drawing | 123Roulement | Confirm dimensions, clearance and retention; not every bearing has the same size | 4.0 | 12.0 | 12.0
F_FollowerSwingShaft | C4 — FollowerSwingShaft | 1 | Cut standard tube / rod / precision shaft | Stock supplier; cut service | Smooth bearing journals; rod tolerances and actual joint allowances to specify | 17.75 | 6.0 | 6.0
F_SwingDrivePulley | C4 — SwingDrivePulley | 1 | Catalogue timing drive preferred; interface redesign needed | MISUMI / HPC / specialist | Reference envelope only; no approved SKU, width, tooth form, hub or belt length | 3.0 | 40.744 | 40.744
F_SwingDrivenPulley | C4 — SwingDrivenPulley | 1 | Catalogue timing drive preferred; interface redesign needed | MISUMI / HPC / specialist | Reference envelope only; no approved SKU, width, tooth form, hub or belt length | 3.0 | 10.186 | 10.186
F_SwingStepUpBelt | C4 — SwingStepUpBelt | 1 | Catalogue timing drive preferred; interface redesign needed | MISUMI / HPC / specialist | Reference envelope only; no approved SKU, width, tooth form, hub or belt length | 3.0 | 61.864 | 57.065
F_FollowerPivotBearing0 | C4 — FollowerPivotBearing0 | 1 | Catalogue bearing / bush — match drawing | 123Roulement | Confirm dimensions, clearance and retention; not every bearing has the same size | 4.0 | 12.0 | 12.0
F_FollowerPivotBearing1 | C4 — FollowerPivotBearing1 | 1 | Catalogue bearing / bush — match drawing | 123Roulement | Confirm dimensions, clearance and retention; not every bearing has the same size | 4.0 | 12.0 | 12.0
G_FollowerSwingShaft | E4 — FollowerSwingShaft | 1 | Cut standard tube / rod / precision shaft | Stock supplier; cut service | Smooth bearing journals; rod tolerances and actual joint allowances to specify | 17.75 | 6.0 | 6.0
G_SwingDrivePulley | E4 — SwingDrivePulley | 1 | Catalogue timing drive preferred; interface redesign needed | MISUMI / HPC / specialist | Reference envelope only; no approved SKU, width, tooth form, hub or belt length | 3.0 | 40.744 | 40.744
G_SwingDrivenPulley | E4 — SwingDrivenPulley | 1 | Catalogue timing drive preferred; interface redesign needed | MISUMI / HPC / specialist | Reference envelope only; no approved SKU, width, tooth form, hub or belt length | 3.0 | 10.186 | 10.186
G_SwingStepUpBelt | E4 — SwingStepUpBelt | 1 | Catalogue timing drive preferred; interface redesign needed | MISUMI / HPC / specialist | Reference envelope only; no approved SKU, width, tooth form, hub or belt length | 3.0 | 62.984 | 57.065
G_FollowerPivotBearing0 | E4 — FollowerPivotBearing0 | 1 | Catalogue bearing / bush — match drawing | 123Roulement | Confirm dimensions, clearance and retention; not every bearing has the same size | 4.0 | 12.0 | 12.0
G_FollowerPivotBearing1 | E4 — FollowerPivotBearing1 | 1 | Catalogue bearing / bush — match drawing | 123Roulement | Confirm dimensions, clearance and retention; not every bearing has the same size | 4.0 | 12.0 | 12.0
A_FollowerSwingShaft | A4 — FollowerSwingShaft | 1 | Cut standard tube / rod / precision shaft | Stock supplier; cut service | Smooth bearing journals; rod tolerances and actual joint allowances to specify | 17.75 | 6.0 | 6.0
A_SwingDrivePulley | A4 — SwingDrivePulley | 1 | Catalogue timing drive preferred; interface redesign needed | MISUMI / HPC / specialist | Reference envelope only; no approved SKU, width, tooth form, hub or belt length | 3.0 | 40.744 | 40.744
A_SwingDrivenPulley | A4 — SwingDrivenPulley | 1 | Catalogue timing drive preferred; interface redesign needed | MISUMI / HPC / specialist | Reference envelope only; no approved SKU, width, tooth form, hub or belt length | 3.0 | 10.186 | 10.186
A_SwingStepUpBelt | A4 — SwingStepUpBelt | 1 | Catalogue timing drive preferred; interface redesign needed | MISUMI / HPC / specialist | Reference envelope only; no approved SKU, width, tooth form, hub or belt length | 3.0 | 65.224 | 57.065
A_FollowerPivotBearing0 | A4 — FollowerPivotBearing0 | 1 | Catalogue bearing / bush — match drawing | 123Roulement | Confirm dimensions, clearance and retention; not every bearing has the same size | 4.0 | 12.0 | 12.0
A_FollowerPivotBearing1 | A4 — FollowerPivotBearing1 | 1 | Catalogue bearing / bush — match drawing | 123Roulement | Confirm dimensions, clearance and retention; not every bearing has the same size | 4.0 | 12.0 | 12.0
SoundboxMountRib0 | Plywood mounting rib — lightened frame | 1 | CNC-routed timber / plywood | Online wood CNC service to confirm | Material, grain, glue joints and acoustic response pending | 6.0 | 41.0 | 128.0
SoundboxMountRib1 | Plywood mounting rib — lightened frame001 | 1 | CNC-routed timber / plywood | Online wood CNC service to confirm | Material, grain, glue joints and acoustic response pending | 6.0 | 41.0 | 128.0
C_NylonBridgeCrown | C3 — NylonBridgeCrown | 1 | Replaceable wear component / printed prototype | Sculpteo PA12 / stock | Functional material and wear test needed; printing is not default for precision fits | 1.3 | 1.3 | 6.0
C_LeftNylonGuide | C3 — nominal 6 mm path radius | 1 | Replaceable wear component / printed prototype | Sculpteo PA12 / stock | Functional material and wear test needed; printing is not default for precision fits | 11.2 | 11.2 | 7.0
C_LeftNylonOverEdge | C3 — LeftNylonOverEdge | 1 | Catalogue unwound nylon string | Music string supplier | Nominal 0.8 mm only; physical tuning, creep and total tension to verify | 14.927 | 38.927 | 0.8
C_RightNylonGuide | C3 — nominal 6 mm path radius001 | 1 | Replaceable wear component / printed prototype | Sculpteo PA12 / stock | Functional material and wear test needed; printing is not default for precision fits | 11.2 | 11.2 | 7.0
C_RightNylonOverEdge | C3 — RightNylonOverEdge | 1 | Catalogue unwound nylon string | Music string supplier | Nominal 0.8 mm only; physical tuning, creep and total tension to verify | 26.927 | 38.927 | 0.8
C_NylonTieShuttle | C3 — coarse hand pull, 20 mm screw adjustment | 1 | Custom or catalogue equivalent — review interface | Engineering review | No verified purchased replacement yet | 12.0 | 6.0 | 6.0
C_NylonTensionScrew | C3 — thread envelope | 1 | Catalogue fastener | Metric fastener supplier | Confirm thread, length, strength and tool access; target M3 / 2.5 mm Allen | 8.4 | 35.0 | 8.4
C_NylonTieKnotEnvelope | C3 — illustrative | 1 | Custom or catalogue equivalent — review interface | Engineering review | No verified purchased replacement yet | 2.2 | 2.4 | 2.4
D_NylonBridgeCrown | E3 — NylonBridgeCrown | 1 | Replaceable wear component / printed prototype | Sculpteo PA12 / stock | Functional material and wear test needed; printing is not default for precision fits | 1.3 | 1.3 | 6.0
D_LeftNylonGuide | E3 — nominal 6 mm path radius | 1 | Replaceable wear component / printed prototype | Sculpteo PA12 / stock | Functional material and wear test needed; printing is not default for precision fits | 11.2 | 11.2 | 7.0
D_LeftNylonOverEdge | E3 — LeftNylonOverEdge | 1 | Catalogue unwound nylon string | Music string supplier | Nominal 0.8 mm only; physical tuning, creep and total tension to verify | 14.927 | 38.927 | 0.8
D_RightNylonGuide | E3 — nominal 6 mm path radius001 | 1 | Replaceable wear component / printed prototype | Sculpteo PA12 / stock | Functional material and wear test needed; printing is not default for precision fits | 11.2 | 11.2 | 7.0
D_RightNylonOverEdge | E3 — RightNylonOverEdge | 1 | Catalogue unwound nylon string | Music string supplier | Nominal 0.8 mm only; physical tuning, creep and total tension to verify | 26.927 | 38.927 | 0.8
D_NylonTieShuttle | E3 — coarse hand pull, 20 mm screw adjustment | 1 | Custom or catalogue equivalent — review interface | Engineering review | No verified purchased replacement yet | 12.0 | 6.0 | 6.0
D_NylonTensionScrew | E3 — thread envelope | 1 | Catalogue fastener | Metric fastener supplier | Confirm thread, length, strength and tool access; target M3 / 2.5 mm Allen | 8.4 | 35.0 | 8.4
D_NylonTieKnotEnvelope | E3 — illustrative | 1 | Custom or catalogue equivalent — review interface | Engineering review | No verified purchased replacement yet | 2.2 | 2.4 | 2.4
E_NylonBridgeCrown | A3 — NylonBridgeCrown | 1 | Replaceable wear component / printed prototype | Sculpteo PA12 / stock | Functional material and wear test needed; printing is not default for precision fits | 1.3 | 1.3 | 6.0
E_LeftNylonGuide | A3 — nominal 6 mm path radius | 1 | Replaceable wear component / printed prototype | Sculpteo PA12 / stock | Functional material and wear test needed; printing is not default for precision fits | 11.2 | 11.2 | 7.0
E_LeftNylonOverEdge | A3 — LeftNylonOverEdge | 1 | Catalogue unwound nylon string | Music string supplier | Nominal 0.8 mm only; physical tuning, creep and total tension to verify | 14.927 | 38.927 | 0.8
E_RightNylonGuide | A3 — nominal 6 mm path radius001 | 1 | Replaceable wear component / printed prototype | Sculpteo PA12 / stock | Functional material and wear test needed; printing is not default for precision fits | 11.2 | 11.2 | 7.0
E_RightNylonOverEdge | A3 — RightNylonOverEdge | 1 | Catalogue unwound nylon string | Music string supplier | Nominal 0.8 mm only; physical tuning, creep and total tension to verify | 26.927 | 38.927 | 0.8
E_NylonTieShuttle | A3 — coarse hand pull, 20 mm screw adjustment | 1 | Custom or catalogue equivalent — review interface | Engineering review | No verified purchased replacement yet | 12.0 | 6.0 | 6.0
E_NylonTensionScrew | A3 — thread envelope | 1 | Catalogue fastener | Metric fastener supplier | Confirm thread, length, strength and tool access; target M3 / 2.5 mm Allen | 8.4 | 35.0 | 8.4
E_NylonTieKnotEnvelope | A3 — illustrative | 1 | Custom or catalogue equivalent — review interface | Engineering review | No verified purchased replacement yet | 2.2 | 2.4 | 2.4
F_NylonBridgeCrown | C4 — NylonBridgeCrown | 1 | Replaceable wear component / printed prototype | Sculpteo PA12 / stock | Functional material and wear test needed; printing is not default for precision fits | 1.3 | 1.3 | 6.0
F_LeftNylonGuide | C4 — nominal 6 mm path radius | 1 | Replaceable wear component / printed prototype | Sculpteo PA12 / stock | Functional material and wear test needed; printing is not default for precision fits | 11.2 | 11.2 | 7.0
F_LeftNylonOverEdge | C4 — LeftNylonOverEdge | 1 | Catalogue unwound nylon string | Music string supplier | Nominal 0.8 mm only; physical tuning, creep and total tension to verify | 14.927 | 38.927 | 0.8
F_RightNylonGuide | C4 — nominal 6 mm path radius001 | 1 | Replaceable wear component / printed prototype | Sculpteo PA12 / stock | Functional material and wear test needed; printing is not default for precision fits | 11.2 | 11.2 | 7.0
F_RightNylonOverEdge | C4 — RightNylonOverEdge | 1 | Catalogue unwound nylon string | Music string supplier | Nominal 0.8 mm only; physical tuning, creep and total tension to verify | 26.927 | 38.927 | 0.8
F_NylonTieShuttle | C4 — coarse hand pull, 20 mm screw adjustment | 1 | Custom or catalogue equivalent — review interface | Engineering review | No verified purchased replacement yet | 12.0 | 6.0 | 6.0
F_NylonTensionScrew | C4 — thread envelope | 1 | Catalogue fastener | Metric fastener supplier | Confirm thread, length, strength and tool access; target M3 / 2.5 mm Allen | 8.4 | 35.0 | 8.4
F_NylonTieKnotEnvelope | C4 — illustrative | 1 | Custom or catalogue equivalent — review interface | Engineering review | No verified purchased replacement yet | 2.2 | 2.4 | 2.4
G_NylonBridgeCrown | E4 — NylonBridgeCrown | 1 | Replaceable wear component / printed prototype | Sculpteo PA12 / stock | Functional material and wear test needed; printing is not default for precision fits | 1.3 | 1.3 | 6.0
G_LeftNylonGuide | E4 — nominal 6 mm path radius | 1 | Replaceable wear component / printed prototype | Sculpteo PA12 / stock | Functional material and wear test needed; printing is not default for precision fits | 11.2 | 11.2 | 7.0
G_LeftNylonOverEdge | E4 — LeftNylonOverEdge | 1 | Catalogue unwound nylon string | Music string supplier | Nominal 0.8 mm only; physical tuning, creep and total tension to verify | 14.927 | 38.927 | 0.8
G_RightNylonGuide | E4 — nominal 6 mm path radius001 | 1 | Replaceable wear component / printed prototype | Sculpteo PA12 / stock | Functional material and wear test needed; printing is not default for precision fits | 11.2 | 11.2 | 7.0
G_RightNylonOverEdge | E4 — RightNylonOverEdge | 1 | Catalogue unwound nylon string | Music string supplier | Nominal 0.8 mm only; physical tuning, creep and total tension to verify | 26.927 | 38.927 | 0.8
G_NylonTieShuttle | E4 — coarse hand pull, 20 mm screw adjustment | 1 | Custom or catalogue equivalent — review interface | Engineering review | No verified purchased replacement yet | 12.0 | 6.0 | 6.0
G_NylonTensionScrew | E4 — thread envelope | 1 | Catalogue fastener | Metric fastener supplier | Confirm thread, length, strength and tool access; target M3 / 2.5 mm Allen | 8.4 | 35.0 | 8.4
G_NylonTieKnotEnvelope | E4 — illustrative | 1 | Custom or catalogue equivalent — review interface | Engineering review | No verified purchased replacement yet | 2.2 | 2.4 | 2.4
A_NylonBridgeCrown | A4 — NylonBridgeCrown | 1 | Replaceable wear component / printed prototype | Sculpteo PA12 / stock | Functional material and wear test needed; printing is not default for precision fits | 1.3 | 1.3 | 6.0
A_LeftNylonGuide | A4 — nominal 6 mm path radius | 1 | Replaceable wear component / printed prototype | Sculpteo PA12 / stock | Functional material and wear test needed; printing is not default for precision fits | 11.2 | 11.2 | 7.0
A_LeftNylonOverEdge | A4 — LeftNylonOverEdge | 1 | Catalogue unwound nylon string | Music string supplier | Nominal 0.8 mm only; physical tuning, creep and total tension to verify | 14.927 | 38.927 | 0.8
A_RightNylonGuide | A4 — nominal 6 mm path radius001 | 1 | Replaceable wear component / printed prototype | Sculpteo PA12 / stock | Functional material and wear test needed; printing is not default for precision fits | 11.2 | 11.2 | 7.0
A_RightNylonOverEdge | A4 — RightNylonOverEdge | 1 | Catalogue unwound nylon string | Music string supplier | Nominal 0.8 mm only; physical tuning, creep and total tension to verify | 26.927 | 38.927 | 0.8
A_NylonTieShuttle | A4 — coarse hand pull, 20 mm screw adjustment | 1 | Custom or catalogue equivalent — review interface | Engineering review | No verified purchased replacement yet | 12.0 | 6.0 | 6.0
A_NylonTensionScrew | A4 — thread envelope | 1 | Catalogue fastener | Metric fastener supplier | Confirm thread, length, strength and tool access; target M3 / 2.5 mm Allen | 8.4 | 35.0 | 8.4
A_NylonTieKnotEnvelope | A4 — illustrative | 1 | Custom or catalogue equivalent — review interface | Engineering review | No verified purchased replacement yet | 2.2 | 2.4 | 2.4
C_AnchorNylonSaddle | C3 — AnchorNylonSaddle | 1 | Custom or catalogue equivalent — review interface | Engineering review | No verified purchased replacement yet | 0.8 | 0.8 | 6.0
D_AnchorNylonSaddle | E3 — AnchorNylonSaddle | 1 | Custom or catalogue equivalent — review interface | Engineering review | No verified purchased replacement yet | 0.8 | 0.8 | 6.0
E_AnchorNylonSaddle | A3 — AnchorNylonSaddle | 1 | Custom or catalogue equivalent — review interface | Engineering review | No verified purchased replacement yet | 0.8 | 0.8 | 6.0
F_AnchorNylonSaddle | C4 — AnchorNylonSaddle | 1 | Custom or catalogue equivalent — review interface | Engineering review | No verified purchased replacement yet | 0.8 | 0.8 | 6.0
G_AnchorNylonSaddle | E4 — AnchorNylonSaddle | 1 | Custom or catalogue equivalent — review interface | Engineering review | No verified purchased replacement yet | 0.8 | 0.8 | 6.0
A_AnchorNylonSaddle | A4 — AnchorNylonSaddle | 1 | Custom or catalogue equivalent — review interface | Engineering review | No verified purchased replacement yet | 0.8 | 0.8 | 6.0
C_TunerNylonSaddle | C3 — TunerNylonSaddle | 1 | Custom or catalogue equivalent — review interface | Engineering review | No verified purchased replacement yet | 0.8 | 0.8 | 6.0
D_TunerNylonSaddle | E3 — TunerNylonSaddle | 1 | Custom or catalogue equivalent — review interface | Engineering review | No verified purchased replacement yet | 0.8 | 0.8 | 6.0
E_TunerNylonSaddle | A3 — TunerNylonSaddle | 1 | Custom or catalogue equivalent — review interface | Engineering review | No verified purchased replacement yet | 0.8 | 0.8 | 6.0
F_TunerNylonSaddle | C4 — TunerNylonSaddle | 1 | Custom or catalogue equivalent — review interface | Engineering review | No verified purchased replacement yet | 0.8 | 0.8 | 6.0
G_TunerNylonSaddle | E4 — TunerNylonSaddle | 1 | Custom or catalogue equivalent — review interface | Engineering review | No verified purchased replacement yet | 0.8 | 0.8 | 6.0
A_TunerNylonSaddle | A4 — TunerNylonSaddle | 1 | Custom or catalogue equivalent — review interface | Engineering review | No verified purchased replacement yet | 0.8 | 0.8 | 6.0
NylonTensionerEndPlate | Removable aluminium end plate and screw thrust shelf | 1 | Custom flat cut / drilled component | John Steel / Xometry | DXF plus thickness; bearing bores and precision holes need machining drawing | 16.0 | 41.0 | 132.0
NylonAnchorEndPlate | Removable tied-string anchor plate | 1 | Custom flat cut / drilled component | John Steel / Xometry | DXF plus thickness; bearing bores and precision holes need machining drawing | 8.0 | 31.0 | 132.0
NylonRightGuidePedestal | NylonRightGuidePedestal | 1 | Replaceable wear component / printed prototype | Sculpteo PA12 / stock | Functional material and wear test needed; printing is not default for precision fits | 10.0 | 12.0 | 130.0
NylonLeftGuidePedestal | NylonLeftGuidePedestal | 1 | Replaceable wear component / printed prototype | Sculpteo PA12 / stock | Functional material and wear test needed; printing is not default for precision fits | 8.0 | 12.0 | 130.0
Cs_RatioDrivePulley | D3 — 36 tooth pitch envelope (NOT manufacturing teeth) | 1 | Catalogue timing drive preferred; interface redesign needed | MISUMI / HPC / specialist | Reference envelope only; no approved SKU, width, tooth form, hub or belt length | 5.0 | 22.918 | 22.918
Cs_RatioDrivenPulley | D3 — 32 tooth pitch envelope (NOT manufacturing teeth) | 1 | Catalogue timing drive preferred; interface redesign needed | MISUMI / HPC / specialist | Reference envelope only; no approved SKU, width, tooth form, hub or belt length | 5.0 | 20.372 | 20.372
Cs_CompoundPulleyHub | D3 — CompoundPulleyHub | 1 | Custom machined fitting; consolidate repeated families | Xometry / Protolabs Network | STEP plus drawing; fits, threads, captive nuts, splits and clamp travel not detailed | 11.25 | 12.0 | 12.0
Cs_IndependentPulleyBearing | D3 — IndependentPulleyBearing | 1 | Catalogue bearing / bush — match drawing | 123Roulement | Confirm dimensions, clearance and retention; not every bearing has the same size | 10.5 | 10.0 | 10.0
Cs_EccentricCam | D3 — EccentricCam | 1 | Custom or catalogue equivalent — review interface | Engineering review | No verified purchased replacement yet | 3.0 | 24.0 | 24.0
Cs_RaisedArmShaft | D3 — RaisedArmShaft | 1 | Cut standard tube / rod / precision shaft | Stock supplier; cut service | Smooth bearing journals; rod tolerances and actual joint allowances to specify | 27.5 | 6.0 | 6.0
Cs_ExtendedArm | D3 — ExtendedArm | 1 | Custom flat cut / drilled component | John Steel / Xometry | DXF plus thickness; bearing bores and precision holes need machining drawing | 3.0 | 63.282 | 25.031
Cs_ExtendedPick | D3 — ExtendedPick | 1 | Replaceable wear component / printed prototype | Sculpteo PA12 / stock | Functional material and wear test needed; printing is not default for precision fits | 3.3 | 1.006 | 0.739
Cs_SwingDrivenPulley | D3 — SwingDrivenPulley | 1 | Catalogue timing drive preferred; interface redesign needed | MISUMI / HPC / specialist | Reference envelope only; no approved SKU, width, tooth form, hub or belt length | 3.0 | 10.186 | 10.186
Cs_FollowerLever | D3 — FollowerLever | 1 | Custom flat cut / drilled component | John Steel / Xometry | DXF plus thickness; bearing bores and precision holes need machining drawing | 2.5 | 54.351 | 36.262
Cs_FollowerRoller | D3 — FollowerRoller | 1 | Custom or catalogue equivalent — review interface | Engineering review | No verified purchased replacement yet | 3.0 | 6.0 | 6.0
Cs_RollerPin | D3 — RollerPin | 1 | Custom or catalogue equivalent — review interface | Engineering review | No verified purchased replacement yet | 6.0 | 2.0 | 2.0
Cs_ReturnSpringEnvelope | D3 — ReturnSpringEnvelope | 1 | Catalogue spring to size | Spring supplier | Return torque, preload and fatigue not sized | 1.0 | 10.0 | 10.0
Cs_FollowerSwingShaft | D3 — FollowerSwingShaft | 1 | Cut standard tube / rod / precision shaft | Stock supplier; cut service | Smooth bearing journals; rod tolerances and actual joint allowances to specify | 17.75 | 6.0 | 6.0
Cs_SwingDrivePulley | D3 — SwingDrivePulley | 1 | Catalogue timing drive preferred; interface redesign needed | MISUMI / HPC / specialist | Reference envelope only; no approved SKU, width, tooth form, hub or belt length | 3.0 | 40.744 | 40.744
Cs_KotoSpeakingString | D3 — KotoSpeakingString | 1 | Catalogue unwound nylon string | Music string supplier | Nominal 0.8 mm only; physical tuning, creep and total tension to verify | 293.333 | 0.8 | 0.8
Cs_KotoBackString | D3 — KotoBackString | 1 | Catalogue unwound nylon string | Music string supplier | Nominal 0.8 mm only; physical tuning, creep and total tension to verify | 48.667 | 0.8 | 0.8
Cs_KotoThirdBridge | D3 — KotoThirdBridge | 1 | Custom or catalogue equivalent — review interface | Engineering review | No verified purchased replacement yet | 12.0 | 17.4 | 6.0
Cs_NylonBridgeCrown | D3 — NylonBridgeCrown | 1 | Replaceable wear component / printed prototype | Sculpteo PA12 / stock | Functional material and wear test needed; printing is not default for precision fits | 1.3 | 1.3 | 6.0
Cs_PendulumBearing0 | D3 — PendulumBearing0 | 1 | Catalogue bearing / bush — match drawing | 123Roulement | Confirm dimensions, clearance and retention; not every bearing has the same size | 4.0 | 12.0 | 12.0
Cs_PendulumBearing1 | D3 — PendulumBearing1 | 1 | Catalogue bearing / bush — match drawing | 123Roulement | Confirm dimensions, clearance and retention; not every bearing has the same size | 4.0 | 12.0 | 12.0
Cs_FollowerPivotBearing0 | D3 — FollowerPivotBearing0 | 1 | Catalogue bearing / bush — match drawing | 123Roulement | Confirm dimensions, clearance and retention; not every bearing has the same size | 4.0 | 12.0 | 12.0
Cs_FollowerPivotBearing1 | D3 — FollowerPivotBearing1 | 1 | Catalogue bearing / bush — match drawing | 123Roulement | Confirm dimensions, clearance and retention; not every bearing has the same size | 4.0 | 12.0 | 12.0
Cs_LeftNylonGuide | D3 — LeftNylonGuide | 1 | Replaceable wear component / printed prototype | Sculpteo PA12 / stock | Functional material and wear test needed; printing is not default for precision fits | 11.2 | 11.2 | 7.0
Cs_LeftNylonOverEdge | D3 — LeftNylonOverEdge | 1 | Catalogue unwound nylon string | Music string supplier | Nominal 0.8 mm only; physical tuning, creep and total tension to verify | 14.927 | 38.927 | 0.8
Cs_RightNylonGuide | D3 — RightNylonGuide | 1 | Replaceable wear component / printed prototype | Sculpteo PA12 / stock | Functional material and wear test needed; printing is not default for precision fits | 11.2 | 11.2 | 7.0
Cs_RightNylonOverEdge | D3 — RightNylonOverEdge | 1 | Catalogue unwound nylon string | Music string supplier | Nominal 0.8 mm only; physical tuning, creep and total tension to verify | 26.927 | 38.927 | 0.8
Cs_NylonTieShuttle | D3 — NylonTieShuttle | 1 | Custom or catalogue equivalent — review interface | Engineering review | No verified purchased replacement yet | 12.0 | 6.0 | 6.0
Cs_NylonTensionScrew | D3 — NylonTensionScrew | 1 | Catalogue fastener | Metric fastener supplier | Confirm thread, length, strength and tool access; target M3 / 2.5 mm Allen | 8.4 | 35.0 | 8.4
Cs_NylonTieKnotEnvelope | D3 — NylonTieKnotEnvelope | 1 | Custom or catalogue equivalent — review interface | Engineering review | No verified purchased replacement yet | 2.2 | 2.4 | 2.4
Cs_AnchorNylonSaddle | D3 — AnchorNylonSaddle | 1 | Custom or catalogue equivalent — review interface | Engineering review | No verified purchased replacement yet | 0.8 | 0.8 | 6.0
Cs_TunerNylonSaddle | D3 — TunerNylonSaddle | 1 | Custom or catalogue equivalent — review interface | Engineering review | No verified purchased replacement yet | 0.8 | 0.8 | 6.0
Eb_RatioDrivePulley | G3 — 48 tooth pitch envelope (NOT manufacturing teeth) | 1 | Catalogue timing drive preferred; interface redesign needed | MISUMI / HPC / specialist | Reference envelope only; no approved SKU, width, tooth form, hub or belt length | 5.0 | 30.558 | 30.558
Eb_RatioDrivenPulley | G3 — 32 tooth pitch envelope (NOT manufacturing teeth) | 1 | Catalogue timing drive preferred; interface redesign needed | MISUMI / HPC / specialist | Reference envelope only; no approved SKU, width, tooth form, hub or belt length | 5.0 | 20.372 | 20.372
Eb_CompoundPulleyHub | G3 — CompoundPulleyHub | 1 | Custom machined fitting; consolidate repeated families | Xometry / Protolabs Network | STEP plus drawing; fits, threads, captive nuts, splits and clamp travel not detailed | 11.25 | 12.0 | 12.0
Eb_IndependentPulleyBearing | G3 — IndependentPulleyBearing | 1 | Catalogue bearing / bush — match drawing | 123Roulement | Confirm dimensions, clearance and retention; not every bearing has the same size | 10.5 | 10.0 | 10.0
Eb_EccentricCam | G3 — EccentricCam | 1 | Custom or catalogue equivalent — review interface | Engineering review | No verified purchased replacement yet | 3.0 | 24.0 | 24.0
Eb_RaisedArmShaft | G3 — RaisedArmShaft | 1 | Cut standard tube / rod / precision shaft | Stock supplier; cut service | Smooth bearing journals; rod tolerances and actual joint allowances to specify | 27.5 | 6.0 | 6.0
Eb_ExtendedArm | G3 — ExtendedArm | 1 | Custom flat cut / drilled component | John Steel / Xometry | DXF plus thickness; bearing bores and precision holes need machining drawing | 3.0 | 49.659 | 17.663
Eb_ExtendedPick | G3 — ExtendedPick | 1 | Replaceable wear component / printed prototype | Sculpteo PA12 / stock | Functional material and wear test needed; printing is not default for precision fits | 3.3 | 0.988 | 0.685
Eb_SwingDrivenPulley | G3 — SwingDrivenPulley | 1 | Catalogue timing drive preferred; interface redesign needed | MISUMI / HPC / specialist | Reference envelope only; no approved SKU, width, tooth form, hub or belt length | 3.0 | 10.186 | 10.186
Eb_FollowerLever | G3 — FollowerLever | 1 | Custom flat cut / drilled component | John Steel / Xometry | DXF plus thickness; bearing bores and precision holes need machining drawing | 2.5 | 43.264 | 54.196
Eb_FollowerRoller | G3 — FollowerRoller | 1 | Custom or catalogue equivalent — review interface | Engineering review | No verified purchased replacement yet | 3.0 | 6.0 | 6.0
Eb_RollerPin | G3 — RollerPin | 1 | Custom or catalogue equivalent — review interface | Engineering review | No verified purchased replacement yet | 6.0 | 2.0 | 2.0
Eb_ReturnSpringEnvelope | G3 — ReturnSpringEnvelope | 1 | Catalogue spring to size | Spring supplier | Return torque, preload and fatigue not sized | 1.0 | 10.0 | 10.0
Eb_FollowerSwingShaft | G3 — FollowerSwingShaft | 1 | Cut standard tube / rod / precision shaft | Stock supplier; cut service | Smooth bearing journals; rod tolerances and actual joint allowances to specify | 17.75 | 6.0 | 6.0
Eb_SwingDrivePulley | G3 — SwingDrivePulley | 1 | Catalogue timing drive preferred; interface redesign needed | MISUMI / HPC / specialist | Reference envelope only; no approved SKU, width, tooth form, hub or belt length | 3.0 | 40.744 | 40.744
Eb_KotoSpeakingString | G3 — KotoSpeakingString | 1 | Catalogue unwound nylon string | Music string supplier | Nominal 0.8 mm only; physical tuning, creep and total tension to verify | 220.0 | 0.8 | 0.8
Eb_KotoBackString | G3 — KotoBackString | 1 | Catalogue unwound nylon string | Music string supplier | Nominal 0.8 mm only; physical tuning, creep and total tension to verify | 122.0 | 0.8 | 0.8
Eb_KotoThirdBridge | G3 — KotoThirdBridge | 1 | Custom or catalogue equivalent — review interface | Engineering review | No verified purchased replacement yet | 12.0 | 17.4 | 6.0
Eb_NylonBridgeCrown | G3 — NylonBridgeCrown | 1 | Replaceable wear component / printed prototype | Sculpteo PA12 / stock | Functional material and wear test needed; printing is not default for precision fits | 1.3 | 1.3 | 6.0
Eb_PendulumBearing0 | G3 — PendulumBearing0 | 1 | Catalogue bearing / bush — match drawing | 123Roulement | Confirm dimensions, clearance and retention; not every bearing has the same size | 4.0 | 12.0 | 12.0
Eb_PendulumBearing1 | G3 — PendulumBearing1 | 1 | Catalogue bearing / bush — match drawing | 123Roulement | Confirm dimensions, clearance and retention; not every bearing has the same size | 4.0 | 12.0 | 12.0
Eb_FollowerPivotBearing0 | G3 — FollowerPivotBearing0 | 1 | Catalogue bearing / bush — match drawing | 123Roulement | Confirm dimensions, clearance and retention; not every bearing has the same size | 4.0 | 12.0 | 12.0
Eb_FollowerPivotBearing1 | G3 — FollowerPivotBearing1 | 1 | Catalogue bearing / bush — match drawing | 123Roulement | Confirm dimensions, clearance and retention; not every bearing has the same size | 4.0 | 12.0 | 12.0
Eb_LeftNylonGuide | G3 — LeftNylonGuide | 1 | Replaceable wear component / printed prototype | Sculpteo PA12 / stock | Functional material and wear test needed; printing is not default for precision fits | 11.2 | 11.2 | 7.0
Eb_LeftNylonOverEdge | G3 — LeftNylonOverEdge | 1 | Catalogue unwound nylon string | Music string supplier | Nominal 0.8 mm only; physical tuning, creep and total tension to verify | 14.927 | 38.927 | 0.8
Eb_RightNylonGuide | G3 — RightNylonGuide | 1 | Replaceable wear component / printed prototype | Sculpteo PA12 / stock | Functional material and wear test needed; printing is not default for precision fits | 11.2 | 11.2 | 7.0
Eb_RightNylonOverEdge | G3 — RightNylonOverEdge | 1 | Catalogue unwound nylon string | Music string supplier | Nominal 0.8 mm only; physical tuning, creep and total tension to verify | 26.927 | 38.927 | 0.8
Eb_NylonTieShuttle | G3 — NylonTieShuttle | 1 | Custom or catalogue equivalent — review interface | Engineering review | No verified purchased replacement yet | 12.0 | 6.0 | 6.0
Eb_NylonTensionScrew | G3 — NylonTensionScrew | 1 | Catalogue fastener | Metric fastener supplier | Confirm thread, length, strength and tool access; target M3 / 2.5 mm Allen | 8.4 | 35.0 | 8.4
Eb_NylonTieKnotEnvelope | G3 — NylonTieKnotEnvelope | 1 | Custom or catalogue equivalent — review interface | Engineering review | No verified purchased replacement yet | 2.2 | 2.4 | 2.4
Eb_AnchorNylonSaddle | G3 — AnchorNylonSaddle | 1 | Custom or catalogue equivalent — review interface | Engineering review | No verified purchased replacement yet | 0.8 | 0.8 | 6.0
Eb_TunerNylonSaddle | G3 — TunerNylonSaddle | 1 | Custom or catalogue equivalent — review interface | Engineering review | No verified purchased replacement yet | 0.8 | 0.8 | 6.0
Fs_RatioDrivePulley | D4 — 54 tooth pitch envelope (NOT manufacturing teeth) | 1 | Catalogue timing drive preferred; interface redesign needed | MISUMI / HPC / specialist | Reference envelope only; no approved SKU, width, tooth form, hub or belt length | 5.0 | 34.377 | 34.377
Fs_RatioDrivenPulley | D4 — 24 tooth pitch envelope (NOT manufacturing teeth) | 1 | Catalogue timing drive preferred; interface redesign needed | MISUMI / HPC / specialist | Reference envelope only; no approved SKU, width, tooth form, hub or belt length | 5.0 | 15.279 | 15.279
Fs_CompoundPulleyHub | D4 — CompoundPulleyHub | 1 | Custom machined fitting; consolidate repeated families | Xometry / Protolabs Network | STEP plus drawing; fits, threads, captive nuts, splits and clamp travel not detailed | 11.25 | 12.0 | 12.0
Fs_IndependentPulleyBearing | D4 — IndependentPulleyBearing | 1 | Catalogue bearing / bush — match drawing | 123Roulement | Confirm dimensions, clearance and retention; not every bearing has the same size | 10.5 | 10.0 | 10.0
Fs_EccentricCam | D4 — EccentricCam | 1 | Custom or catalogue equivalent — review interface | Engineering review | No verified purchased replacement yet | 3.0 | 24.0 | 24.0
Fs_RaisedArmShaft | D4 — RaisedArmShaft | 1 | Cut standard tube / rod / precision shaft | Stock supplier; cut service | Smooth bearing journals; rod tolerances and actual joint allowances to specify | 27.5 | 6.0 | 6.0
Fs_ExtendedArm | D4 — ExtendedArm | 1 | Custom flat cut / drilled component | John Steel / Xometry | DXF plus thickness; bearing bores and precision holes need machining drawing | 3.0 | 35.411 | 12.0
Fs_ExtendedPick | D4 — ExtendedPick | 1 | Replaceable wear component / printed prototype | Sculpteo PA12 / stock | Functional material and wear test needed; printing is not default for precision fits | 3.3 | 0.948 | 0.593
Fs_SwingDrivenPulley | D4 — SwingDrivenPulley | 1 | Catalogue timing drive preferred; interface redesign needed | MISUMI / HPC / specialist | Reference envelope only; no approved SKU, width, tooth form, hub or belt length | 3.0 | 10.186 | 10.186
Fs_FollowerLever | D4 — FollowerLever | 1 | Custom flat cut / drilled component | John Steel / Xometry | DXF plus thickness; bearing bores and precision holes need machining drawing | 2.5 | 31.707 | 80.896
Fs_FollowerRoller | D4 — FollowerRoller | 1 | Custom or catalogue equivalent — review interface | Engineering review | No verified purchased replacement yet | 3.0 | 6.0 | 6.0
Fs_RollerPin | D4 — RollerPin | 1 | Custom or catalogue equivalent — review interface | Engineering review | No verified purchased replacement yet | 6.0 | 2.0 | 2.0
Fs_ReturnSpringEnvelope | D4 — ReturnSpringEnvelope | 1 | Catalogue spring to size | Spring supplier | Return torque, preload and fatigue not sized | 1.0 | 10.0 | 10.0
Fs_FollowerSwingShaft | D4 — FollowerSwingShaft | 1 | Cut standard tube / rod / precision shaft | Stock supplier; cut service | Smooth bearing journals; rod tolerances and actual joint allowances to specify | 17.75 | 6.0 | 6.0
Fs_SwingDrivePulley | D4 — SwingDrivePulley | 1 | Catalogue timing drive preferred; interface redesign needed | MISUMI / HPC / specialist | Reference envelope only; no approved SKU, width, tooth form, hub or belt length | 3.0 | 40.744 | 40.744
Fs_KotoSpeakingString | D4 — KotoSpeakingString | 1 | Catalogue unwound nylon string | Music string supplier | Nominal 0.8 mm only; physical tuning, creep and total tension to verify | 146.667 | 0.8 | 0.8
Fs_KotoBackString | D4 — KotoBackString | 1 | Catalogue unwound nylon string | Music string supplier | Nominal 0.8 mm only; physical tuning, creep and total tension to verify | 195.333 | 0.8 | 0.8
Fs_KotoThirdBridge | D4 — KotoThirdBridge | 1 | Custom or catalogue equivalent — review interface | Engineering review | No verified purchased replacement yet | 12.0 | 17.4 | 6.0
Fs_NylonBridgeCrown | D4 — NylonBridgeCrown | 1 | Replaceable wear component / printed prototype | Sculpteo PA12 / stock | Functional material and wear test needed; printing is not default for precision fits | 1.3 | 1.3 | 6.0
Fs_PendulumBearing0 | D4 — PendulumBearing0 | 1 | Catalogue bearing / bush — match drawing | 123Roulement | Confirm dimensions, clearance and retention; not every bearing has the same size | 4.0 | 12.0 | 12.0
Fs_PendulumBearing1 | D4 — PendulumBearing1 | 1 | Catalogue bearing / bush — match drawing | 123Roulement | Confirm dimensions, clearance and retention; not every bearing has the same size | 4.0 | 12.0 | 12.0
Fs_FollowerPivotBearing0 | D4 — FollowerPivotBearing0 | 1 | Catalogue bearing / bush — match drawing | 123Roulement | Confirm dimensions, clearance and retention; not every bearing has the same size | 4.0 | 12.0 | 12.0
Fs_FollowerPivotBearing1 | D4 — FollowerPivotBearing1 | 1 | Catalogue bearing / bush — match drawing | 123Roulement | Confirm dimensions, clearance and retention; not every bearing has the same size | 4.0 | 12.0 | 12.0
Fs_LeftNylonGuide | D4 — LeftNylonGuide | 1 | Replaceable wear component / printed prototype | Sculpteo PA12 / stock | Functional material and wear test needed; printing is not default for precision fits | 11.2 | 11.2 | 7.0
Fs_LeftNylonOverEdge | D4 — LeftNylonOverEdge | 1 | Catalogue unwound nylon string | Music string supplier | Nominal 0.8 mm only; physical tuning, creep and total tension to verify | 14.927 | 38.927 | 0.8
Fs_RightNylonGuide | D4 — RightNylonGuide | 1 | Replaceable wear component / printed prototype | Sculpteo PA12 / stock | Functional material and wear test needed; printing is not default for precision fits | 11.2 | 11.2 | 7.0
Fs_RightNylonOverEdge | D4 — RightNylonOverEdge | 1 | Catalogue unwound nylon string | Music string supplier | Nominal 0.8 mm only; physical tuning, creep and total tension to verify | 26.927 | 38.927 | 0.8
Fs_NylonTieShuttle | D4 — NylonTieShuttle | 1 | Custom or catalogue equivalent — review interface | Engineering review | No verified purchased replacement yet | 12.0 | 6.0 | 6.0
Fs_NylonTensionScrew | D4 — NylonTensionScrew | 1 | Catalogue fastener | Metric fastener supplier | Confirm thread, length, strength and tool access; target M3 / 2.5 mm Allen | 8.4 | 35.0 | 8.4
Fs_NylonTieKnotEnvelope | D4 — NylonTieKnotEnvelope | 1 | Custom or catalogue equivalent — review interface | Engineering review | No verified purchased replacement yet | 2.2 | 2.4 | 2.4
Fs_AnchorNylonSaddle | D4 — AnchorNylonSaddle | 1 | Custom or catalogue equivalent — review interface | Engineering review | No verified purchased replacement yet | 0.8 | 0.8 | 6.0
Fs_TunerNylonSaddle | D4 — TunerNylonSaddle | 1 | Custom or catalogue equivalent — review interface | Engineering review | No verified purchased replacement yet | 0.8 | 0.8 | 6.0
Ab_RatioDrivePulley | G4 — 60 tooth pitch envelope (NOT manufacturing teeth) | 1 | Catalogue timing drive preferred; interface redesign needed | MISUMI / HPC / specialist | Reference envelope only; no approved SKU, width, tooth form, hub or belt length | 5.0 | 38.197 | 38.197
Ab_RatioDrivenPulley | G4 — 20 tooth pitch envelope (NOT manufacturing teeth) | 1 | Catalogue timing drive preferred; interface redesign needed | MISUMI / HPC / specialist | Reference envelope only; no approved SKU, width, tooth form, hub or belt length | 5.0 | 12.732 | 12.732
Ab_CompoundPulleyHub | G4 — CompoundPulleyHub | 1 | Custom machined fitting; consolidate repeated families | Xometry / Protolabs Network | STEP plus drawing; fits, threads, captive nuts, splits and clamp travel not detailed | 11.25 | 12.0 | 12.0
Ab_IndependentPulleyBearing | G4 — IndependentPulleyBearing | 1 | Catalogue bearing / bush — match drawing | 123Roulement | Confirm dimensions, clearance and retention; not every bearing has the same size | 10.5 | 10.0 | 10.0
Ab_EccentricCam | G4 — EccentricCam | 1 | Custom or catalogue equivalent — review interface | Engineering review | No verified purchased replacement yet | 3.0 | 24.0 | 24.0
Ab_RaisedArmShaft | G4 — RaisedArmShaft | 1 | Cut standard tube / rod / precision shaft | Stock supplier; cut service | Smooth bearing journals; rod tolerances and actual joint allowances to specify | 27.5 | 6.0 | 6.0
Ab_ExtendedArm | G4 — ExtendedArm | 1 | Custom flat cut / drilled component | John Steel / Xometry | DXF plus thickness; bearing bores and precision holes need machining drawing | 3.0 | 27.983 | 12.0
Ab_ExtendedPick | G4 — ExtendedPick | 1 | Replaceable wear component / printed prototype | Sculpteo PA12 / stock | Functional material and wear test needed; printing is not default for precision fits | 3.3 | 0.931 | 0.557
Ab_SwingDrivenPulley | G4 — SwingDrivenPulley | 1 | Catalogue timing drive preferred; interface redesign needed | MISUMI / HPC / specialist | Reference envelope only; no approved SKU, width, tooth form, hub or belt length | 3.0 | 10.186 | 10.186
Ab_FollowerLever | G4 — FollowerLever | 1 | Custom flat cut / drilled component | John Steel / Xometry | DXF plus thickness; bearing bores and precision holes need machining drawing | 2.5 | 24.848 | 99.216
Ab_FollowerRoller | G4 — FollowerRoller | 1 | Custom or catalogue equivalent — review interface | Engineering review | No verified purchased replacement yet | 3.0 | 6.0 | 6.0
Ab_RollerPin | G4 — RollerPin | 1 | Custom or catalogue equivalent — review interface | Engineering review | No verified purchased replacement yet | 6.0 | 2.0 | 2.0
Ab_ReturnSpringEnvelope | G4 — ReturnSpringEnvelope | 1 | Catalogue spring to size | Spring supplier | Return torque, preload and fatigue not sized | 1.0 | 10.0 | 10.0
Ab_FollowerSwingShaft | G4 — FollowerSwingShaft | 1 | Cut standard tube / rod / precision shaft | Stock supplier; cut service | Smooth bearing journals; rod tolerances and actual joint allowances to specify | 17.75 | 6.0 | 6.0
Ab_SwingDrivePulley | G4 — SwingDrivePulley | 1 | Catalogue timing drive preferred; interface redesign needed | MISUMI / HPC / specialist | Reference envelope only; no approved SKU, width, tooth form, hub or belt length | 3.0 | 40.744 | 40.744
Ab_KotoSpeakingString | G4 — KotoSpeakingString | 1 | Catalogue unwound nylon string | Music string supplier | Nominal 0.8 mm only; physical tuning, creep and total tension to verify | 110.0 | 0.8 | 0.8
Ab_KotoBackString | G4 — KotoBackString | 1 | Catalogue unwound nylon string | Music string supplier | Nominal 0.8 mm only; physical tuning, creep and total tension to verify | 232.0 | 0.8 | 0.8
Ab_KotoThirdBridge | G4 — KotoThirdBridge | 1 | Custom or catalogue equivalent — review interface | Engineering review | No verified purchased replacement yet | 12.0 | 17.4 | 6.0
Ab_NylonBridgeCrown | G4 — NylonBridgeCrown | 1 | Replaceable wear component / printed prototype | Sculpteo PA12 / stock | Functional material and wear test needed; printing is not default for precision fits | 1.3 | 1.3 | 6.0
Ab_PendulumBearing0 | G4 — PendulumBearing0 | 1 | Catalogue bearing / bush — match drawing | 123Roulement | Confirm dimensions, clearance and retention; not every bearing has the same size | 4.0 | 12.0 | 12.0
Ab_PendulumBearing1 | G4 — PendulumBearing1 | 1 | Catalogue bearing / bush — match drawing | 123Roulement | Confirm dimensions, clearance and retention; not every bearing has the same size | 4.0 | 12.0 | 12.0
Ab_FollowerPivotBearing0 | G4 — FollowerPivotBearing0 | 1 | Catalogue bearing / bush — match drawing | 123Roulement | Confirm dimensions, clearance and retention; not every bearing has the same size | 4.0 | 12.0 | 12.0
Ab_FollowerPivotBearing1 | G4 — FollowerPivotBearing1 | 1 | Catalogue bearing / bush — match drawing | 123Roulement | Confirm dimensions, clearance and retention; not every bearing has the same size | 4.0 | 12.0 | 12.0
Ab_LeftNylonGuide | G4 — LeftNylonGuide | 1 | Replaceable wear component / printed prototype | Sculpteo PA12 / stock | Functional material and wear test needed; printing is not default for precision fits | 11.2 | 11.2 | 7.0
Ab_LeftNylonOverEdge | G4 — LeftNylonOverEdge | 1 | Catalogue unwound nylon string | Music string supplier | Nominal 0.8 mm only; physical tuning, creep and total tension to verify | 14.927 | 38.927 | 0.8
Ab_RightNylonGuide | G4 — RightNylonGuide | 1 | Replaceable wear component / printed prototype | Sculpteo PA12 / stock | Functional material and wear test needed; printing is not default for precision fits | 11.2 | 11.2 | 7.0
Ab_RightNylonOverEdge | G4 — RightNylonOverEdge | 1 | Catalogue unwound nylon string | Music string supplier | Nominal 0.8 mm only; physical tuning, creep and total tension to verify | 26.927 | 38.927 | 0.8
Ab_NylonTieShuttle | G4 — NylonTieShuttle | 1 | Custom or catalogue equivalent — review interface | Engineering review | No verified purchased replacement yet | 12.0 | 6.0 | 6.0
Ab_NylonTensionScrew | G4 — NylonTensionScrew | 1 | Catalogue fastener | Metric fastener supplier | Confirm thread, length, strength and tool access; target M3 / 2.5 mm Allen | 8.4 | 35.0 | 8.4
Ab_NylonTieKnotEnvelope | G4 — NylonTieKnotEnvelope | 1 | Custom or catalogue equivalent — review interface | Engineering review | No verified purchased replacement yet | 2.2 | 2.4 | 2.4
Ab_AnchorNylonSaddle | G4 — AnchorNylonSaddle | 1 | Custom or catalogue equivalent — review interface | Engineering review | No verified purchased replacement yet | 0.8 | 0.8 | 6.0
Ab_TunerNylonSaddle | G4 — TunerNylonSaddle | 1 | Custom or catalogue equivalent — review interface | Engineering review | No verified purchased replacement yet | 0.8 | 0.8 | 6.0
Bb_RatioDrivePulley | C5 — 64 tooth pitch envelope (NOT manufacturing teeth) | 1 | Catalogue timing drive preferred; interface redesign needed | MISUMI / HPC / specialist | Reference envelope only; no approved SKU, width, tooth form, hub or belt length | 5.0 | 40.744 | 40.744
Bb_RatioDrivenPulley | C5 — 16 tooth pitch envelope (NOT manufacturing teeth) | 1 | Catalogue timing drive preferred; interface redesign needed | MISUMI / HPC / specialist | Reference envelope only; no approved SKU, width, tooth form, hub or belt length | 5.0 | 10.186 | 10.186
Bb_CompoundPulleyHub | C5 — CompoundPulleyHub | 1 | Custom machined fitting; consolidate repeated families | Xometry / Protolabs Network | STEP plus drawing; fits, threads, captive nuts, splits and clamp travel not detailed | 11.25 | 12.0 | 12.0
Bb_IndependentPulleyBearing | C5 — IndependentPulleyBearing | 1 | Catalogue bearing / bush — match drawing | 123Roulement | Confirm dimensions, clearance and retention; not every bearing has the same size | 10.5 | 10.0 | 10.0
Bb_EccentricCam | C5 — EccentricCam | 1 | Custom or catalogue equivalent — review interface | Engineering review | No verified purchased replacement yet | 3.0 | 24.0 | 24.0
Bb_RaisedArmShaft | C5 — RaisedArmShaft | 1 | Cut standard tube / rod / precision shaft | Stock supplier; cut service | Smooth bearing journals; rod tolerances and actual joint allowances to specify | 27.5 | 6.0 | 6.0
Bb_ExtendedArm | C5 — ExtendedArm | 1 | Custom flat cut / drilled component | John Steel / Xometry | DXF plus thickness; bearing bores and precision holes need machining drawing | 3.0 | 21.869 | 12.0
Bb_ExtendedPick | C5 — ExtendedPick | 1 | Replaceable wear component / printed prototype | Sculpteo PA12 / stock | Functional material and wear test needed; printing is not default for precision fits | 3.3 | 1.42 | 0.559
Bb_SwingDrivenPulley | C5 — SwingDrivenPulley | 1 | Catalogue timing drive preferred; interface redesign needed | MISUMI / HPC / specialist | Reference envelope only; no approved SKU, width, tooth form, hub or belt length | 3.0 | 10.186 | 10.186
Bb_FollowerLever | C5 — FollowerLever | 1 | Custom flat cut / drilled component | John Steel / Xometry | DXF plus thickness; bearing bores and precision holes need machining drawing | 2.5 | 19.632 | 118.109
Bb_FollowerRoller | C5 — FollowerRoller | 1 | Custom or catalogue equivalent — review interface | Engineering review | No verified purchased replacement yet | 3.0 | 6.0 | 6.0
Bb_RollerPin | C5 — RollerPin | 1 | Custom or catalogue equivalent — review interface | Engineering review | No verified purchased replacement yet | 6.0 | 2.0 | 2.0
Bb_ReturnSpringEnvelope | C5 — ReturnSpringEnvelope | 1 | Catalogue spring to size | Spring supplier | Return torque, preload and fatigue not sized | 1.0 | 10.0 | 10.0
Bb_FollowerSwingShaft | C5 — FollowerSwingShaft | 1 | Cut standard tube / rod / precision shaft | Stock supplier; cut service | Smooth bearing journals; rod tolerances and actual joint allowances to specify | 17.75 | 6.0 | 6.0
Bb_SwingDrivePulley | C5 — SwingDrivePulley | 1 | Catalogue timing drive preferred; interface redesign needed | MISUMI / HPC / specialist | Reference envelope only; no approved SKU, width, tooth form, hub or belt length | 3.0 | 40.744 | 40.744
Bb_KotoSpeakingString | C5 — KotoSpeakingString | 1 | Catalogue unwound nylon string | Music string supplier | Nominal 0.8 mm only; physical tuning, creep and total tension to verify | 82.5 | 0.8 | 0.8
Bb_KotoBackString | C5 — KotoBackString | 1 | Catalogue unwound nylon string | Music string supplier | Nominal 0.8 mm only; physical tuning, creep and total tension to verify | 259.5 | 0.8 | 0.8
Bb_KotoThirdBridge | C5 — KotoThirdBridge | 1 | Custom or catalogue equivalent — review interface | Engineering review | No verified purchased replacement yet | 12.0 | 17.4 | 6.0
Bb_NylonBridgeCrown | C5 — NylonBridgeCrown | 1 | Replaceable wear component / printed prototype | Sculpteo PA12 / stock | Functional material and wear test needed; printing is not default for precision fits | 1.3 | 1.3 | 6.0
Bb_PendulumBearing0 | C5 — PendulumBearing0 | 1 | Catalogue bearing / bush — match drawing | 123Roulement | Confirm dimensions, clearance and retention; not every bearing has the same size | 4.0 | 12.0 | 12.0
Bb_PendulumBearing1 | C5 — PendulumBearing1 | 1 | Catalogue bearing / bush — match drawing | 123Roulement | Confirm dimensions, clearance and retention; not every bearing has the same size | 4.0 | 12.0 | 12.0
Bb_FollowerPivotBearing0 | C5 — FollowerPivotBearing0 | 1 | Catalogue bearing / bush — match drawing | 123Roulement | Confirm dimensions, clearance and retention; not every bearing has the same size | 4.0 | 12.0 | 12.0
Bb_FollowerPivotBearing1 | C5 — FollowerPivotBearing1 | 1 | Catalogue bearing / bush — match drawing | 123Roulement | Confirm dimensions, clearance and retention; not every bearing has the same size | 4.0 | 12.0 | 12.0
Bb_LeftNylonGuide | C5 — LeftNylonGuide | 1 | Replaceable wear component / printed prototype | Sculpteo PA12 / stock | Functional material and wear test needed; printing is not default for precision fits | 11.2 | 11.2 | 7.0
Bb_LeftNylonOverEdge | C5 — LeftNylonOverEdge | 1 | Catalogue unwound nylon string | Music string supplier | Nominal 0.8 mm only; physical tuning, creep and total tension to verify | 14.927 | 38.927 | 0.8
Bb_RightNylonGuide | C5 — RightNylonGuide | 1 | Replaceable wear component / printed prototype | Sculpteo PA12 / stock | Functional material and wear test needed; printing is not default for precision fits | 11.2 | 11.2 | 7.0
Bb_RightNylonOverEdge | C5 — RightNylonOverEdge | 1 | Catalogue unwound nylon string | Music string supplier | Nominal 0.8 mm only; physical tuning, creep and total tension to verify | 26.927 | 38.927 | 0.8
Bb_NylonTieShuttle | C5 — NylonTieShuttle | 1 | Custom or catalogue equivalent — review interface | Engineering review | No verified purchased replacement yet | 12.0 | 6.0 | 6.0
Bb_NylonTensionScrew | C5 — NylonTensionScrew | 1 | Catalogue fastener | Metric fastener supplier | Confirm thread, length, strength and tool access; target M3 / 2.5 mm Allen | 8.4 | 35.0 | 8.4
Bb_NylonTieKnotEnvelope | C5 — NylonTieKnotEnvelope | 1 | Custom or catalogue equivalent — review interface | Engineering review | No verified purchased replacement yet | 2.2 | 2.4 | 2.4
Bb_AnchorNylonSaddle | C5 — AnchorNylonSaddle | 1 | Custom or catalogue equivalent — review interface | Engineering review | No verified purchased replacement yet | 0.8 | 0.8 | 6.0
Bb_TunerNylonSaddle | C5 — TunerNylonSaddle | 1 | Custom or catalogue equivalent — review interface | Engineering review | No verified purchased replacement yet | 0.8 | 0.8 | 6.0
B_RatioDrivePulley | D5 — 72 tooth pitch envelope (NOT manufacturing teeth) | 1 | Catalogue timing drive preferred; interface redesign needed | MISUMI / HPC / specialist | Reference envelope only; no approved SKU, width, tooth form, hub or belt length | 5.0 | 45.837 | 45.837
B_RatioDrivenPulley | D5 — 16 tooth pitch envelope (NOT manufacturing teeth) | 1 | Catalogue timing drive preferred; interface redesign needed | MISUMI / HPC / specialist | Reference envelope only; no approved SKU, width, tooth form, hub or belt length | 5.0 | 10.186 | 10.186
B_CompoundPulleyHub | D5 — CompoundPulleyHub | 1 | Custom machined fitting; consolidate repeated families | Xometry / Protolabs Network | STEP plus drawing; fits, threads, captive nuts, splits and clamp travel not detailed | 11.25 | 12.0 | 12.0
B_IndependentPulleyBearing | D5 — IndependentPulleyBearing | 1 | Catalogue bearing / bush — match drawing | 123Roulement | Confirm dimensions, clearance and retention; not every bearing has the same size | 10.5 | 10.0 | 10.0
B_EccentricCam | D5 — EccentricCam | 1 | Custom or catalogue equivalent — review interface | Engineering review | No verified purchased replacement yet | 3.0 | 24.0 | 24.0
B_RaisedArmShaft | D5 — RaisedArmShaft | 1 | Cut standard tube / rod / precision shaft | Stock supplier; cut service | Smooth bearing journals; rod tolerances and actual joint allowances to specify | 27.5 | 6.0 | 6.0
B_ExtendedArm | D5 — ExtendedArm | 1 | Custom flat cut / drilled component | John Steel / Xometry | DXF plus thickness; bearing bores and precision holes need machining drawing | 3.0 | 19.995 | 12.0
B_ExtendedPick | D5 — ExtendedPick | 1 | Replaceable wear component / printed prototype | Sculpteo PA12 / stock | Functional material and wear test needed; printing is not default for precision fits | 3.3 | 1.417 | 0.549
B_SwingDrivenPulley | D5 — SwingDrivenPulley | 1 | Catalogue timing drive preferred; interface redesign needed | MISUMI / HPC / specialist | Reference envelope only; no approved SKU, width, tooth form, hub or belt length | 3.0 | 10.186 | 10.186
B_FollowerLever | D5 — FollowerLever | 1 | Custom flat cut / drilled component | John Steel / Xometry | DXF plus thickness; bearing bores and precision holes need machining drawing | 2.5 | 17.991 | 127.767
B_FollowerRoller | D5 — FollowerRoller | 1 | Custom or catalogue equivalent — review interface | Engineering review | No verified purchased replacement yet | 3.0 | 6.0 | 6.0
B_RollerPin | D5 — RollerPin | 1 | Custom or catalogue equivalent — review interface | Engineering review | No verified purchased replacement yet | 6.0 | 2.0 | 2.0
B_ReturnSpringEnvelope | D5 — ReturnSpringEnvelope | 1 | Catalogue spring to size | Spring supplier | Return torque, preload and fatigue not sized | 1.0 | 10.0 | 10.0
B_FollowerSwingShaft | D5 — FollowerSwingShaft | 1 | Cut standard tube / rod / precision shaft | Stock supplier; cut service | Smooth bearing journals; rod tolerances and actual joint allowances to specify | 17.75 | 6.0 | 6.0
B_SwingDrivePulley | D5 — SwingDrivePulley | 1 | Catalogue timing drive preferred; interface redesign needed | MISUMI / HPC / specialist | Reference envelope only; no approved SKU, width, tooth form, hub or belt length | 3.0 | 40.744 | 40.744
B_KotoSpeakingString | D5 — KotoSpeakingString | 1 | Catalogue unwound nylon string | Music string supplier | Nominal 0.8 mm only; physical tuning, creep and total tension to verify | 73.333 | 0.8 | 0.8
B_KotoBackString | D5 — KotoBackString | 1 | Catalogue unwound nylon string | Music string supplier | Nominal 0.8 mm only; physical tuning, creep and total tension to verify | 268.667 | 0.8 | 0.8
B_KotoThirdBridge | D5 — KotoThirdBridge | 1 | Custom or catalogue equivalent — review interface | Engineering review | No verified purchased replacement yet | 12.0 | 17.4 | 6.0
B_NylonBridgeCrown | D5 — NylonBridgeCrown | 1 | Replaceable wear component / printed prototype | Sculpteo PA12 / stock | Functional material and wear test needed; printing is not default for precision fits | 1.3 | 1.3 | 6.0
B_PendulumBearing0 | D5 — PendulumBearing0 | 1 | Catalogue bearing / bush — match drawing | 123Roulement | Confirm dimensions, clearance and retention; not every bearing has the same size | 4.0 | 12.0 | 12.0
B_PendulumBearing1 | D5 — PendulumBearing1 | 1 | Catalogue bearing / bush — match drawing | 123Roulement | Confirm dimensions, clearance and retention; not every bearing has the same size | 4.0 | 12.0 | 12.0
B_FollowerPivotBearing0 | D5 — FollowerPivotBearing0 | 1 | Catalogue bearing / bush — match drawing | 123Roulement | Confirm dimensions, clearance and retention; not every bearing has the same size | 4.0 | 12.0 | 12.0
B_FollowerPivotBearing1 | D5 — FollowerPivotBearing1 | 1 | Catalogue bearing / bush — match drawing | 123Roulement | Confirm dimensions, clearance and retention; not every bearing has the same size | 4.0 | 12.0 | 12.0
B_LeftNylonGuide | D5 — LeftNylonGuide | 1 | Replaceable wear component / printed prototype | Sculpteo PA12 / stock | Functional material and wear test needed; printing is not default for precision fits | 11.2 | 11.2 | 7.0
B_LeftNylonOverEdge | D5 — LeftNylonOverEdge | 1 | Catalogue unwound nylon string | Music string supplier | Nominal 0.8 mm only; physical tuning, creep and total tension to verify | 14.927 | 38.927 | 0.8
B_RightNylonGuide | D5 — RightNylonGuide | 1 | Replaceable wear component / printed prototype | Sculpteo PA12 / stock | Functional material and wear test needed; printing is not default for precision fits | 11.2 | 11.2 | 7.0
B_RightNylonOverEdge | D5 — RightNylonOverEdge | 1 | Catalogue unwound nylon string | Music string supplier | Nominal 0.8 mm only; physical tuning, creep and total tension to verify | 26.927 | 38.927 | 0.8
B_NylonTieShuttle | D5 — NylonTieShuttle | 1 | Custom or catalogue equivalent — review interface | Engineering review | No verified purchased replacement yet | 12.0 | 6.0 | 6.0
B_NylonTensionScrew | D5 — NylonTensionScrew | 1 | Catalogue fastener | Metric fastener supplier | Confirm thread, length, strength and tool access; target M3 / 2.5 mm Allen | 8.4 | 35.0 | 8.4
B_NylonTieKnotEnvelope | D5 — NylonTieKnotEnvelope | 1 | Custom or catalogue equivalent — review interface | Engineering review | No verified purchased replacement yet | 2.2 | 2.4 | 2.4
B_AnchorNylonSaddle | D5 — AnchorNylonSaddle | 1 | Custom or catalogue equivalent — review interface | Engineering review | No verified purchased replacement yet | 0.8 | 0.8 | 6.0
B_TunerNylonSaddle | D5 — TunerNylonSaddle | 1 | Custom or catalogue equivalent — review interface | Engineering review | No verified purchased replacement yet | 0.8 | 0.8 | 6.0
Cs_RatioBelt | D3 — RatioBelt | 1 | Catalogue timing drive preferred; interface redesign needed | MISUMI / HPC / specialist | Reference envelope only; no approved SKU, width, tooth form, hub or belt length | 5.0 | 47.245 | 38.245
Cs_SwingStepUpBelt | D3 — SwingStepUpBelt | 1 | Catalogue timing drive preferred; interface redesign needed | MISUMI / HPC / specialist | Reference envelope only; no approved SKU, width, tooth form, hub or belt length | 3.0 | 48.331 | 57.065
Eb_RatioBelt | G3 — RatioBelt | 1 | Catalogue timing drive preferred; interface redesign needed | MISUMI / HPC / specialist | Reference envelope only; no approved SKU, width, tooth form, hub or belt length | 5.0 | 51.065 | 42.065
Eb_SwingStepUpBelt | G3 — SwingStepUpBelt | 1 | Catalogue timing drive preferred; interface redesign needed | MISUMI / HPC / specialist | Reference envelope only; no approved SKU, width, tooth form, hub or belt length | 3.0 | 56.264 | 57.065
Fs_RatioBelt | D4 — RatioBelt | 1 | Catalogue timing drive preferred; interface redesign needed | MISUMI / HPC / specialist | Reference envelope only; no approved SKU, width, tooth form, hub or belt length | 5.0 | 50.428 | 41.428
Fs_SwingStepUpBelt | D4 — SwingStepUpBelt | 1 | Catalogue timing drive preferred; interface redesign needed | MISUMI / HPC / specialist | Reference envelope only; no approved SKU, width, tooth form, hub or belt length | 3.0 | 62.984 | 57.065
Ab_RatioBelt | G4 — RatioBelt | 1 | Catalogue timing drive preferred; interface redesign needed | MISUMI / HPC / specialist | Reference envelope only; no approved SKU, width, tooth form, hub or belt length | 5.0 | 51.065 | 42.065
Ab_SwingStepUpBelt | G4 — SwingStepUpBelt | 1 | Catalogue timing drive preferred; interface redesign needed | MISUMI / HPC / specialist | Reference envelope only; no approved SKU, width, tooth form, hub or belt length | 3.0 | 64.664 | 57.065
Bb_RatioBelt | C5 — RatioBelt | 1 | Catalogue timing drive preferred; interface redesign needed | MISUMI / HPC / specialist | Reference envelope only; no approved SKU, width, tooth form, hub or belt length | 5.0 | 51.065 | 42.344
Bb_SwingStepUpBelt | C5 — SwingStepUpBelt | 1 | Catalogue timing drive preferred; interface redesign needed | MISUMI / HPC / specialist | Reference envelope only; no approved SKU, width, tooth form, hub or belt length | 3.0 | 65.597 | 57.065
B_RatioBelt | D5 — RatioBelt | 1 | Catalogue timing drive preferred; interface redesign needed | MISUMI / HPC / specialist | Reference envelope only; no approved SKU, width, tooth form, hub or belt length | 5.0 | 53.611 | 47.437
B_SwingStepUpBelt | D5 — SwingStepUpBelt | 1 | Catalogue timing drive preferred; interface redesign needed | MISUMI / HPC / specialist | Reference envelope only; no approved SKU, width, tooth form, hub or belt length | 3.0 | 65.971 | 57.065
N20MotorCan | N20-size 6 V motor can — dimensional envelope | 1 | Catalogue electrical component / mount reservation | Select after one-voice torque test | No production motor or control selected; 3 rpm input under load required | 16.6 | 10.0 | 12.0
N20Gearbox | Low-speed metal gearbox — 10–15 rpm class | 1 | Catalogue electrical component / mount reservation | Select after one-voice torque test | No production motor or control selected; 3 rpm input under load required | 12.5 | 10.0 | 12.0
N20OutputShaft | 3 mm D-shaft envelope | 1 | Cut standard tube / rod / precision shaft | Stock supplier; cut service | Smooth bearing journals; rod tolerances and actual joint allowances to specify | 10.0 | 3.0 | 3.0
ElectricShaftCoupling | Removable stepped coupling, 6 mm harp axle / 3 mm motor shaft | 1 | Cut standard tube / rod / precision shaft | Stock supplier; cut service | Smooth bearing journals; rod tolerances and actual joint allowances to specify | 17.2 | 10.0 | 10.0
ElectricMotorBracket | Removable motor bracket — supplier hole pattern and alignment pending | 1 | Custom machined fitting; consolidate repeated families | Xometry / Protolabs Network | STEP plus drawing; fits, threads, captive nuts, splits and clamp travel not detailed | 18.0 | 34.0 | 26.0
PWMSpeedBoard | PWM controller space reservation — 5–6 V compatible board to select | 1 | Catalogue electrical component / mount reservation | Select after one-voice torque test | No production motor or control selected; 3 rpm input under load required | 28.0 | 1.6 | 18.0
SpeedPotBody | Speed potentiometer envelope | 1 | Catalogue electrical component / mount reservation | Select after one-voice torque test | No production motor or control selected; 3 rpm input under load required | 9.0 | 9.0 | 7.0
SpeedPotShaft | Speed-control spindle | 1 | Cut standard tube / rod / precision shaft | Stock supplier; cut service | Smooth bearing journals; rod tolerances and actual joint allowances to specify | 4.0 | 4.0 | 8.0
SpeedControlKnob | Turn to adjust tempo | 1 | Catalogue electrical component / mount reservation | Select after one-voice torque test | No production motor or control selected; 3 rpm input under load required | 12.0 | 12.0 | 6.0
ElectricRunSwitch | Run / stop switch — electrical rating pending | 1 | Catalogue electrical component / mount reservation | Select after one-voice torque test | No production motor or control selected; 3 rpm input under load required | 7.0 | 4.0 | 8.0
ElectricSupplyConnector | Low-voltage external supply connector envelope | 1 | Catalogue electrical component / mount reservation | Select after one-voice torque test | No production motor or control selected; 3 rpm input under load required | 7.0 | 5.0 | 8.0
ElectricClearTop | Clear motor / coupling cover | 1 | Catalogue electrical component / mount reservation | Select after one-voice torque test | No production motor or control selected; 3 rpm input under load required | 30.4 | 2.0 | 40.0
ElectricClearRear | Clear motor / coupling cover001 | 1 | Catalogue electrical component / mount reservation | Select after one-voice torque test | No production motor or control selected; 3 rpm input under load required | 30.4 | 35.0 | 2.0
ElectricClearFront | Clear motor / coupling cover002 | 1 | Catalogue electrical component / mount reservation | Select after one-voice torque test | No production motor or control selected; 3 rpm input under load required | 30.4 | 35.0 | 2.0
GantryFrontRail | Shared 10 × 1 mm aluminium tube — arm rail | 1 | Cut standard tube / rod / precision shaft | Stock supplier; cut service | Smooth bearing journals; rod tolerances and actual joint allowances to specify | 316.976 | 47.119 | 139.657
GantryRearRail | Shared 10 × 1 mm aluminium tube — follower rail | 1 | Cut standard tube / rod / precision shaft | Stock supplier; cut service | Smooth bearing journals; rod tolerances and actual joint allowances to specify | 316.976 | 47.119 | 139.657
C_ArmClampBoltL | C3 — thread envelope001 | 1 | Catalogue fastener | Metric fastener supplier | Confirm thread, length, strength and tool access; target M3 / 2.5 mm Allen | 5.0 | 18.0 | 5.0
C_ArmClampBoltR | C3 — thread envelope002 | 1 | Catalogue fastener | Metric fastener supplier | Confirm thread, length, strength and tool access; target M3 / 2.5 mm Allen | 5.0 | 18.0 | 5.0
C_ArmHangingFork | C3 — paired bearing cheeks | 1 | Custom machined fitting; consolidate repeated families | Xometry / Protolabs Network | STEP plus drawing; fits, threads, captive nuts, splits and clamp travel not detailed | 19.953 | 57.702 | 22.0
C_ArmClampCap | C3 — ArmClampCap | 1 | Custom machined fitting; consolidate repeated families | Xometry / Protolabs Network | STEP plus drawing; fits, threads, captive nuts, splits and clamp travel not detailed | 19.972 | 9.665 | 22.0
C_FollowerClampBoltL | C3 — thread envelope003 | 1 | Catalogue fastener | Metric fastener supplier | Confirm thread, length, strength and tool access; target M3 / 2.5 mm Allen | 5.0 | 18.0 | 5.0
C_FollowerClampBoltR | C3 — thread envelope004 | 1 | Catalogue fastener | Metric fastener supplier | Confirm thread, length, strength and tool access; target M3 / 2.5 mm Allen | 5.0 | 18.0 | 5.0
C_FollowerHangingFork | C3 — paired bearing cheeks001 | 1 | Custom machined fitting; consolidate repeated families | Xometry / Protolabs Network | STEP plus drawing; fits, threads, captive nuts, splits and clamp travel not detailed | 19.953 | 39.702 | 22.0
C_FollowerClampCap | C3 — FollowerClampCap | 1 | Custom machined fitting; consolidate repeated families | Xometry / Protolabs Network | STEP plus drawing; fits, threads, captive nuts, splits and clamp travel not detailed | 19.972 | 9.665 | 22.0
Cs_ArmClampBoltL | D3 — thread envelope | 1 | Catalogue fastener | Metric fastener supplier | Confirm thread, length, strength and tool access; target M3 / 2.5 mm Allen | 5.0 | 18.0 | 5.0
Cs_ArmClampBoltR | D3 — thread envelope001 | 1 | Catalogue fastener | Metric fastener supplier | Confirm thread, length, strength and tool access; target M3 / 2.5 mm Allen | 5.0 | 18.0 | 5.0
Cs_ArmHangingFork | D3 — paired bearing cheeks | 1 | Custom machined fitting; consolidate repeated families | Xometry / Protolabs Network | STEP plus drawing; fits, threads, captive nuts, splits and clamp travel not detailed | 19.953 | 62.318 | 22.0
Cs_ArmClampCap | D3 — ArmClampCap | 1 | Custom machined fitting; consolidate repeated families | Xometry / Protolabs Network | STEP plus drawing; fits, threads, captive nuts, splits and clamp travel not detailed | 19.972 | 9.665 | 22.0
Cs_FollowerClampBoltL | D3 — thread envelope002 | 1 | Catalogue fastener | Metric fastener supplier | Confirm thread, length, strength and tool access; target M3 / 2.5 mm Allen | 5.0 | 18.0 | 5.0
Cs_FollowerClampBoltR | D3 — thread envelope003 | 1 | Catalogue fastener | Metric fastener supplier | Confirm thread, length, strength and tool access; target M3 / 2.5 mm Allen | 5.0 | 18.0 | 5.0
Cs_FollowerHangingFork | D3 — paired bearing cheeks001 | 1 | Custom machined fitting; consolidate repeated families | Xometry / Protolabs Network | STEP plus drawing; fits, threads, captive nuts, splits and clamp travel not detailed | 19.953 | 41.051 | 22.0
Cs_FollowerClampCap | D3 — FollowerClampCap | 1 | Custom machined fitting; consolidate repeated families | Xometry / Protolabs Network | STEP plus drawing; fits, threads, captive nuts, splits and clamp travel not detailed | 19.972 | 9.665 | 22.0
D_ArmClampBoltL | E3 — thread envelope001 | 1 | Catalogue fastener | Metric fastener supplier | Confirm thread, length, strength and tool access; target M3 / 2.5 mm Allen | 5.0 | 18.0 | 5.0
D_ArmClampBoltR | E3 — thread envelope002 | 1 | Catalogue fastener | Metric fastener supplier | Confirm thread, length, strength and tool access; target M3 / 2.5 mm Allen | 5.0 | 18.0 | 5.0
D_ArmHangingFork | E3 — paired bearing cheeks | 1 | Custom machined fitting; consolidate repeated families | Xometry / Protolabs Network | STEP plus drawing; fits, threads, captive nuts, splits and clamp travel not detailed | 19.953 | 65.44 | 22.0
D_ArmClampCap | E3 — ArmClampCap | 1 | Custom machined fitting; consolidate repeated families | Xometry / Protolabs Network | STEP plus drawing; fits, threads, captive nuts, splits and clamp travel not detailed | 19.972 | 9.665 | 22.0
D_FollowerClampBoltL | E3 — thread envelope003 | 1 | Catalogue fastener | Metric fastener supplier | Confirm thread, length, strength and tool access; target M3 / 2.5 mm Allen | 5.0 | 18.0 | 5.0
D_FollowerClampBoltR | E3 — thread envelope004 | 1 | Catalogue fastener | Metric fastener supplier | Confirm thread, length, strength and tool access; target M3 / 2.5 mm Allen | 5.0 | 18.0 | 5.0
D_FollowerHangingFork | E3 — paired bearing cheeks001 | 1 | Custom machined fitting; consolidate repeated families | Xometry / Protolabs Network | STEP plus drawing; fits, threads, captive nuts, splits and clamp travel not detailed | 19.953 | 41.467 | 22.0
D_FollowerClampCap | E3 — FollowerClampCap | 1 | Custom machined fitting; consolidate repeated families | Xometry / Protolabs Network | STEP plus drawing; fits, threads, captive nuts, splits and clamp travel not detailed | 19.972 | 9.665 | 22.0
Eb_ArmClampBoltL | G3 — thread envelope | 1 | Catalogue fastener | Metric fastener supplier | Confirm thread, length, strength and tool access; target M3 / 2.5 mm Allen | 5.0 | 18.0 | 5.0
Eb_ArmClampBoltR | G3 — thread envelope001 | 1 | Catalogue fastener | Metric fastener supplier | Confirm thread, length, strength and tool access; target M3 / 2.5 mm Allen | 5.0 | 18.0 | 5.0
Eb_ArmHangingFork | G3 — paired bearing cheeks | 1 | Custom machined fitting; consolidate repeated families | Xometry / Protolabs Network | STEP plus drawing; fits, threads, captive nuts, splits and clamp travel not detailed | 19.953 | 71.549 | 22.0
Eb_ArmClampCap | G3 — ArmClampCap | 1 | Custom machined fitting; consolidate repeated families | Xometry / Protolabs Network | STEP plus drawing; fits, threads, captive nuts, splits and clamp travel not detailed | 19.972 | 9.665 | 22.0
Eb_FollowerClampBoltL | G3 — thread envelope002 | 1 | Catalogue fastener | Metric fastener supplier | Confirm thread, length, strength and tool access; target M3 / 2.5 mm Allen | 5.0 | 18.0 | 5.0
Eb_FollowerClampBoltR | G3 — thread envelope003 | 1 | Catalogue fastener | Metric fastener supplier | Confirm thread, length, strength and tool access; target M3 / 2.5 mm Allen | 5.0 | 18.0 | 5.0
Eb_FollowerHangingFork | G3 — paired bearing cheeks001 | 1 | Custom machined fitting; consolidate repeated families | Xometry / Protolabs Network | STEP plus drawing; fits, threads, captive nuts, splits and clamp travel not detailed | 19.953 | 42.349 | 22.0
Eb_FollowerClampCap | G3 — FollowerClampCap | 1 | Custom machined fitting; consolidate repeated families | Xometry / Protolabs Network | STEP plus drawing; fits, threads, captive nuts, splits and clamp travel not detailed | 19.972 | 9.665 | 22.0
E_ArmClampBoltL | A3 — thread envelope001 | 1 | Catalogue fastener | Metric fastener supplier | Confirm thread, length, strength and tool access; target M3 / 2.5 mm Allen | 5.0 | 18.0 | 5.0
E_ArmClampBoltR | A3 — thread envelope002 | 1 | Catalogue fastener | Metric fastener supplier | Confirm thread, length, strength and tool access; target M3 / 2.5 mm Allen | 5.0 | 18.0 | 5.0
E_ArmHangingFork | A3 — paired bearing cheeks | 1 | Custom machined fitting; consolidate repeated families | Xometry / Protolabs Network | STEP plus drawing; fits, threads, captive nuts, splits and clamp travel not detailed | 19.953 | 73.178 | 22.0
E_ArmClampCap | A3 — ArmClampCap | 1 | Custom machined fitting; consolidate repeated families | Xometry / Protolabs Network | STEP plus drawing; fits, threads, captive nuts, splits and clamp travel not detailed | 19.972 | 9.665 | 22.0
E_FollowerClampBoltL | A3 — thread envelope003 | 1 | Catalogue fastener | Metric fastener supplier | Confirm thread, length, strength and tool access; target M3 / 2.5 mm Allen | 5.0 | 18.0 | 5.0
E_FollowerClampBoltR | A3 — thread envelope004 | 1 | Catalogue fastener | Metric fastener supplier | Confirm thread, length, strength and tool access; target M3 / 2.5 mm Allen | 5.0 | 18.0 | 5.0
E_FollowerHangingFork | A3 — paired bearing cheeks001 | 1 | Custom machined fitting; consolidate repeated families | Xometry / Protolabs Network | STEP plus drawing; fits, threads, captive nuts, splits and clamp travel not detailed | 19.953 | 41.739 | 22.0
E_FollowerClampCap | A3 — FollowerClampCap | 1 | Custom machined fitting; consolidate repeated families | Xometry / Protolabs Network | STEP plus drawing; fits, threads, captive nuts, splits and clamp travel not detailed | 19.972 | 9.665 | 22.0
F_ArmClampBoltL | C4 — thread envelope001 | 1 | Catalogue fastener | Metric fastener supplier | Confirm thread, length, strength and tool access; target M3 / 2.5 mm Allen | 5.0 | 18.0 | 5.0
F_ArmClampBoltR | C4 — thread envelope002 | 1 | Catalogue fastener | Metric fastener supplier | Confirm thread, length, strength and tool access; target M3 / 2.5 mm Allen | 5.0 | 18.0 | 5.0
F_ArmHangingFork | C4 — paired bearing cheeks | 1 | Custom machined fitting; consolidate repeated families | Xometry / Protolabs Network | STEP plus drawing; fits, threads, captive nuts, splits and clamp travel not detailed | 19.953 | 77.047 | 22.0
F_ArmClampCap | C4 — ArmClampCap | 1 | Custom machined fitting; consolidate repeated families | Xometry / Protolabs Network | STEP plus drawing; fits, threads, captive nuts, splits and clamp travel not detailed | 19.972 | 9.665 | 22.0
F_FollowerClampBoltL | C4 — thread envelope003 | 1 | Catalogue fastener | Metric fastener supplier | Confirm thread, length, strength and tool access; target M3 / 2.5 mm Allen | 5.0 | 18.0 | 5.0
F_FollowerClampBoltR | C4 — thread envelope004 | 1 | Catalogue fastener | Metric fastener supplier | Confirm thread, length, strength and tool access; target M3 / 2.5 mm Allen | 5.0 | 18.0 | 5.0
F_FollowerHangingFork | C4 — paired bearing cheeks001 | 1 | Custom machined fitting; consolidate repeated families | Xometry / Protolabs Network | STEP plus drawing; fits, threads, captive nuts, splits and clamp travel not detailed | 19.953 | 42.248 | 22.0
F_FollowerClampCap | C4 — FollowerClampCap | 1 | Custom machined fitting; consolidate repeated families | Xometry / Protolabs Network | STEP plus drawing; fits, threads, captive nuts, splits and clamp travel not detailed | 19.972 | 9.665 | 22.0
Fs_ArmClampBoltL | D4 — thread envelope | 1 | Catalogue fastener | Metric fastener supplier | Confirm thread, length, strength and tool access; target M3 / 2.5 mm Allen | 5.0 | 18.0 | 5.0
Fs_ArmClampBoltR | D4 — thread envelope001 | 1 | Catalogue fastener | Metric fastener supplier | Confirm thread, length, strength and tool access; target M3 / 2.5 mm Allen | 5.0 | 18.0 | 5.0
Fs_ArmHangingFork | D4 — paired bearing cheeks | 1 | Custom machined fitting; consolidate repeated families | Xometry / Protolabs Network | STEP plus drawing; fits, threads, captive nuts, splits and clamp travel not detailed | 19.953 | 77.929 | 22.0
Fs_ArmClampCap | D4 — ArmClampCap | 1 | Custom machined fitting; consolidate repeated families | Xometry / Protolabs Network | STEP plus drawing; fits, threads, captive nuts, splits and clamp travel not detailed | 19.972 | 9.665 | 22.0
Fs_FollowerClampBoltL | D4 — thread envelope002 | 1 | Catalogue fastener | Metric fastener supplier | Confirm thread, length, strength and tool access; target M3 / 2.5 mm Allen | 5.0 | 18.0 | 5.0
Fs_FollowerClampBoltR | D4 — thread envelope003 | 1 | Catalogue fastener | Metric fastener supplier | Confirm thread, length, strength and tool access; target M3 / 2.5 mm Allen | 5.0 | 18.0 | 5.0
Fs_FollowerHangingFork | D4 — paired bearing cheeks001 | 1 | Custom machined fitting; consolidate repeated families | Xometry / Protolabs Network | STEP plus drawing; fits, threads, captive nuts, splits and clamp travel not detailed | 19.953 | 42.01 | 22.0
Fs_FollowerClampCap | D4 — FollowerClampCap | 1 | Custom machined fitting; consolidate repeated families | Xometry / Protolabs Network | STEP plus drawing; fits, threads, captive nuts, splits and clamp travel not detailed | 19.972 | 9.665 | 22.0
G_ArmClampBoltL | E4 — thread envelope001 | 1 | Catalogue fastener | Metric fastener supplier | Confirm thread, length, strength and tool access; target M3 / 2.5 mm Allen | 5.0 | 18.0 | 5.0
G_ArmClampBoltR | E4 — thread envelope002 | 1 | Catalogue fastener | Metric fastener supplier | Confirm thread, length, strength and tool access; target M3 / 2.5 mm Allen | 5.0 | 18.0 | 5.0
G_ArmHangingFork | E4 — paired bearing cheeks | 1 | Custom machined fitting; consolidate repeated families | Xometry / Protolabs Network | STEP plus drawing; fits, threads, captive nuts, splits and clamp travel not detailed | 19.953 | 78.065 | 22.0
G_ArmClampCap | E4 — ArmClampCap | 1 | Custom machined fitting; consolidate repeated families | Xometry / Protolabs Network | STEP plus drawing; fits, threads, captive nuts, splits and clamp travel not detailed | 19.972 | 9.665 | 22.0
G_FollowerClampBoltL | E4 — thread envelope003 | 1 | Catalogue fastener | Metric fastener supplier | Confirm thread, length, strength and tool access; target M3 / 2.5 mm Allen | 5.0 | 18.0 | 5.0
G_FollowerClampBoltR | E4 — thread envelope004 | 1 | Catalogue fastener | Metric fastener supplier | Confirm thread, length, strength and tool access; target M3 / 2.5 mm Allen | 5.0 | 18.0 | 5.0
G_FollowerHangingFork | E4 — paired bearing cheeks001 | 1 | Custom machined fitting; consolidate repeated families | Xometry / Protolabs Network | STEP plus drawing; fits, threads, captive nuts, splits and clamp travel not detailed | 19.953 | 42.146 | 22.0
G_FollowerClampCap | E4 — FollowerClampCap | 1 | Custom machined fitting; consolidate repeated families | Xometry / Protolabs Network | STEP plus drawing; fits, threads, captive nuts, splits and clamp travel not detailed | 19.972 | 9.665 | 22.0
Ab_ArmClampBoltL | G4 — thread envelope | 1 | Catalogue fastener | Metric fastener supplier | Confirm thread, length, strength and tool access; target M3 / 2.5 mm Allen | 5.0 | 18.0 | 5.0
Ab_ArmClampBoltR | G4 — thread envelope001 | 1 | Catalogue fastener | Metric fastener supplier | Confirm thread, length, strength and tool access; target M3 / 2.5 mm Allen | 5.0 | 18.0 | 5.0
Ab_ArmHangingFork | G4 — paired bearing cheeks | 1 | Custom machined fitting; consolidate repeated families | Xometry / Protolabs Network | STEP plus drawing; fits, threads, captive nuts, splits and clamp travel not detailed | 19.953 | 79.694 | 22.0
Ab_ArmClampCap | G4 — ArmClampCap | 1 | Custom machined fitting; consolidate repeated families | Xometry / Protolabs Network | STEP plus drawing; fits, threads, captive nuts, splits and clamp travel not detailed | 19.972 | 9.665 | 22.0
Ab_FollowerClampBoltL | G4 — thread envelope002 | 1 | Catalogue fastener | Metric fastener supplier | Confirm thread, length, strength and tool access; target M3 / 2.5 mm Allen | 5.0 | 18.0 | 5.0
Ab_FollowerClampBoltR | G4 — thread envelope003 | 1 | Catalogue fastener | Metric fastener supplier | Confirm thread, length, strength and tool access; target M3 / 2.5 mm Allen | 5.0 | 18.0 | 5.0
Ab_FollowerHangingFork | G4 — paired bearing cheeks001 | 1 | Custom machined fitting; consolidate repeated families | Xometry / Protolabs Network | STEP plus drawing; fits, threads, captive nuts, splits and clamp travel not detailed | 19.953 | 42.095 | 22.0
Ab_FollowerClampCap | G4 — FollowerClampCap | 1 | Custom machined fitting; consolidate repeated families | Xometry / Protolabs Network | STEP plus drawing; fits, threads, captive nuts, splits and clamp travel not detailed | 19.972 | 9.665 | 22.0
A_ArmClampBoltL | A4 — thread envelope001 | 1 | Catalogue fastener | Metric fastener supplier | Confirm thread, length, strength and tool access; target M3 / 2.5 mm Allen | 5.0 | 18.0 | 5.0
A_ArmClampBoltR | A4 — thread envelope002 | 1 | Catalogue fastener | Metric fastener supplier | Confirm thread, length, strength and tool access; target M3 / 2.5 mm Allen | 5.0 | 18.0 | 5.0
A_ArmHangingFork | A4 — paired bearing cheeks | 1 | Custom machined fitting; consolidate repeated families | Xometry / Protolabs Network | STEP plus drawing; fits, threads, captive nuts, splits and clamp travel not detailed | 19.953 | 79.083 | 22.0
A_ArmClampCap | A4 — ArmClampCap | 1 | Custom machined fitting; consolidate repeated families | Xometry / Protolabs Network | STEP plus drawing; fits, threads, captive nuts, splits and clamp travel not detailed | 19.972 | 9.665 | 22.0
A_FollowerClampBoltL | A4 — thread envelope003 | 1 | Catalogue fastener | Metric fastener supplier | Confirm thread, length, strength and tool access; target M3 / 2.5 mm Allen | 5.0 | 18.0 | 5.0
A_FollowerClampBoltR | A4 — thread envelope004 | 1 | Catalogue fastener | Metric fastener supplier | Confirm thread, length, strength and tool access; target M3 / 2.5 mm Allen | 5.0 | 18.0 | 5.0
A_FollowerHangingFork | A4 — paired bearing cheeks001 | 1 | Custom machined fitting; consolidate repeated families | Xometry / Protolabs Network | STEP plus drawing; fits, threads, captive nuts, splits and clamp travel not detailed | 19.953 | 40.924 | 22.0
A_FollowerClampCap | A4 — FollowerClampCap | 1 | Custom machined fitting; consolidate repeated families | Xometry / Protolabs Network | STEP plus drawing; fits, threads, captive nuts, splits and clamp travel not detailed | 19.972 | 9.665 | 22.0
Bb_ArmClampBoltL | C5 — thread envelope | 1 | Catalogue fastener | Metric fastener supplier | Confirm thread, length, strength and tool access; target M3 / 2.5 mm Allen | 5.0 | 18.0 | 5.0
Bb_ArmClampBoltR | C5 — thread envelope001 | 1 | Catalogue fastener | Metric fastener supplier | Confirm thread, length, strength and tool access; target M3 / 2.5 mm Allen | 5.0 | 18.0 | 5.0
Bb_ArmHangingFork | C5 — paired bearing cheeks | 1 | Custom machined fitting; consolidate repeated families | Xometry / Protolabs Network | STEP plus drawing; fits, threads, captive nuts, splits and clamp travel not detailed | 19.953 | 79.592 | 22.0
Bb_ArmClampCap | C5 — ArmClampCap | 1 | Custom machined fitting; consolidate repeated families | Xometry / Protolabs Network | STEP plus drawing; fits, threads, captive nuts, splits and clamp travel not detailed | 19.972 | 9.665 | 22.0
Bb_FollowerClampBoltL | C5 — thread envelope002 | 1 | Catalogue fastener | Metric fastener supplier | Confirm thread, length, strength and tool access; target M3 / 2.5 mm Allen | 5.0 | 18.0 | 5.0
Bb_FollowerClampBoltR | C5 — thread envelope003 | 1 | Catalogue fastener | Metric fastener supplier | Confirm thread, length, strength and tool access; target M3 / 2.5 mm Allen | 5.0 | 18.0 | 5.0
Bb_FollowerHangingFork | C5 — paired bearing cheeks001 | 1 | Custom machined fitting; consolidate repeated families | Xometry / Protolabs Network | STEP plus drawing; fits, threads, captive nuts, splits and clamp travel not detailed | 19.953 | 41.06 | 22.0
Bb_FollowerClampCap | C5 — FollowerClampCap | 1 | Custom machined fitting; consolidate repeated families | Xometry / Protolabs Network | STEP plus drawing; fits, threads, captive nuts, splits and clamp travel not detailed | 19.972 | 9.665 | 22.0
B_ArmClampBoltL | D5 — thread envelope | 1 | Catalogue fastener | Metric fastener supplier | Confirm thread, length, strength and tool access; target M3 / 2.5 mm Allen | 5.0 | 18.0 | 5.0
B_ArmClampBoltR | D5 — thread envelope001 | 1 | Catalogue fastener | Metric fastener supplier | Confirm thread, length, strength and tool access; target M3 / 2.5 mm Allen | 5.0 | 18.0 | 5.0
B_ArmHangingFork | D5 — paired bearing cheeks | 1 | Custom machined fitting; consolidate repeated families | Xometry / Protolabs Network | STEP plus drawing; fits, threads, captive nuts, splits and clamp travel not detailed | 19.953 | 78.608 | 22.0
B_ArmClampCap | D5 — ArmClampCap | 1 | Custom machined fitting; consolidate repeated families | Xometry / Protolabs Network | STEP plus drawing; fits, threads, captive nuts, splits and clamp travel not detailed | 19.972 | 9.665 | 22.0
B_FollowerClampBoltL | D5 — thread envelope002 | 1 | Catalogue fastener | Metric fastener supplier | Confirm thread, length, strength and tool access; target M3 / 2.5 mm Allen | 5.0 | 18.0 | 5.0
B_FollowerClampBoltR | D5 — thread envelope003 | 1 | Catalogue fastener | Metric fastener supplier | Confirm thread, length, strength and tool access; target M3 / 2.5 mm Allen | 5.0 | 18.0 | 5.0
B_FollowerHangingFork | D5 — paired bearing cheeks001 | 1 | Custom machined fitting; consolidate repeated families | Xometry / Protolabs Network | STEP plus drawing; fits, threads, captive nuts, splits and clamp travel not detailed | 19.953 | 39.702 | 22.0
B_FollowerClampCap | D5 — FollowerClampCap | 1 | Custom machined fitting; consolidate repeated families | Xometry / Protolabs Network | STEP plus drawing; fits, threads, captive nuts, splits and clamp travel not detailed | 19.972 | 9.665 | 22.0
ElectricCouplingShield | Clear sleeve around the removable shaft coupling | 1 | Catalogue electrical component / mount reservation | Select after one-voice torque test | No production motor or control selected; 3 rpm input under load required | 14.1 | 14.0 | 14.0
DriveFrameLeftInputBearing | Left input bearing — MR126-2RS, 6 × 12 × 4 mm | 1 | Catalogue bearing / bush — match drawing | 123Roulement | Confirm dimensions, clearance and retention; not every bearing has the same size | 4.0 | 12.0 | 12.0
DriveFrameLeftInputRetainer0FrontWasher | DriveFrameLeftInputRetainer0FrontWasher | 1 | Catalogue fastener | Metric fastener supplier | Confirm thread, length, strength and tool access; target M3 / 2.5 mm Allen | 0.5 | 7.0 | 7.0
DriveFrameLeftInputRetainer0RearWasher | DriveFrameLeftInputRetainer0RearWasher | 1 | Catalogue fastener | Metric fastener supplier | Confirm thread, length, strength and tool access; target M3 / 2.5 mm Allen | 0.5 | 7.0 | 7.0
DriveFrameLeftInputRetainer0Bolt | M3 × 10 bolt — bearing retaining washers | 1 | Catalogue fastener | Metric fastener supplier | Confirm thread, length, strength and tool access; target M3 / 2.5 mm Allen | 12.0 | 6.35 | 5.499
DriveFrameLeftInputRetainer0Nut | M3 nut — bearing retainer | 1 | Catalogue fastener | Metric fastener supplier | Confirm thread, length, strength and tool access; target M3 / 2.5 mm Allen | 2.4 | 6.35 | 5.499
DriveFrameLeftInputRetainer1FrontWasher | DriveFrameLeftInputRetainer1FrontWasher | 1 | Catalogue fastener | Metric fastener supplier | Confirm thread, length, strength and tool access; target M3 / 2.5 mm Allen | 0.5 | 7.0 | 7.0
DriveFrameLeftInputRetainer1RearWasher | DriveFrameLeftInputRetainer1RearWasher | 1 | Catalogue fastener | Metric fastener supplier | Confirm thread, length, strength and tool access; target M3 / 2.5 mm Allen | 0.5 | 7.0 | 7.0
DriveFrameLeftInputRetainer1Bolt | M3 × 10 bolt — bearing retaining washers001 | 1 | Catalogue fastener | Metric fastener supplier | Confirm thread, length, strength and tool access; target M3 / 2.5 mm Allen | 12.0 | 6.35 | 5.499
DriveFrameLeftInputRetainer1Nut | M3 nut — bearing retainer001 | 1 | Catalogue fastener | Metric fastener supplier | Confirm thread, length, strength and tool access; target M3 / 2.5 mm Allen | 2.4 | 6.35 | 5.499
DriveFrameLeftAngle0 | Left standard angle foot 1 — 20 × 20 × 2, cut 15 mm | 1 | Custom or catalogue equivalent — review interface | Engineering review | No verified purchased replacement yet | 20.0 | 20.0 | 15.0
DriveFrameLeftCheekBolt0 | M4 × 12 bolt — end plate to angle | 1 | Catalogue fastener | Metric fastener supplier | Confirm thread, length, strength and tool access; target M3 / 2.5 mm Allen | 14.8 | 8.08 | 6.997
DriveFrameLeftCheekWasherA0 | DriveFrameLeftCheekWasherA0 | 1 | Catalogue fastener | Metric fastener supplier | Confirm thread, length, strength and tool access; target M3 / 2.5 mm Allen | 0.8 | 9.0 | 9.0
DriveFrameLeftCheekWasherB0 | DriveFrameLeftCheekWasherB0 | 1 | Catalogue fastener | Metric fastener supplier | Confirm thread, length, strength and tool access; target M3 / 2.5 mm Allen | 0.8 | 9.0 | 9.0
DriveFrameLeftCheekNut0 | M4 nut — end plate to angle | 1 | Catalogue fastener | Metric fastener supplier | Confirm thread, length, strength and tool access; target M3 / 2.5 mm Allen | 3.2 | 8.08 | 6.997
DriveFrameLeftDeckBolt0 | M4 × 20 bolt — removable drive deck | 1 | Catalogue fastener | Metric fastener supplier | Confirm thread, length, strength and tool access; target M3 / 2.5 mm Allen | 8.08 | 22.8 | 6.997
DriveFrameLeftDeckWasher0 | DriveFrameLeftDeckWasher0 | 1 | Catalogue fastener | Metric fastener supplier | Confirm thread, length, strength and tool access; target M3 / 2.5 mm Allen | 9.0 | 0.8 | 9.0
DriveFrameLeftDeckRearWasher0 | DriveFrameLeftDeckRearWasher0 | 1 | Catalogue fastener | Metric fastener supplier | Confirm thread, length, strength and tool access; target M3 / 2.5 mm Allen | 9.0 | 0.8 | 9.0
DriveFrameLeftDeckNut0 | M4 nut — accessible inside soundbox | 1 | Catalogue fastener | Metric fastener supplier | Confirm thread, length, strength and tool access; target M3 / 2.5 mm Allen | 8.08 | 3.2 | 6.997
DriveFrameLeftAngle1 | Left standard angle foot 2 — 20 × 20 × 2, cut 15 mm | 1 | Custom or catalogue equivalent — review interface | Engineering review | No verified purchased replacement yet | 20.0 | 20.0 | 15.0
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
