pl-coder/LeLovophon/outputs/LeLovophon_Direct_Gear_Prototype/Axle_Clearance_Revision/Assembly_REFERENCE_NOT_FOR_MACHINING.step

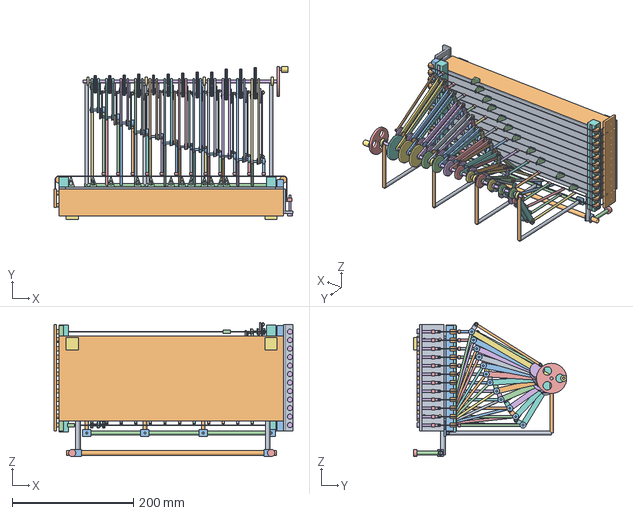
[picture p5: CAD file, 2026-11-09]
outputs/LeLovophon_Direct_Gear_Prototype/Axle_Clearance_Revision/Assembly_REFERENCE_NOT_FOR_MACHINING.step
394.0 x 253.0 x 221.3 mm
