pl-coder/LeLovophon/outputs/Lovophone_Prototype_A/Prototype_A_Assembly_REFERENCE.step

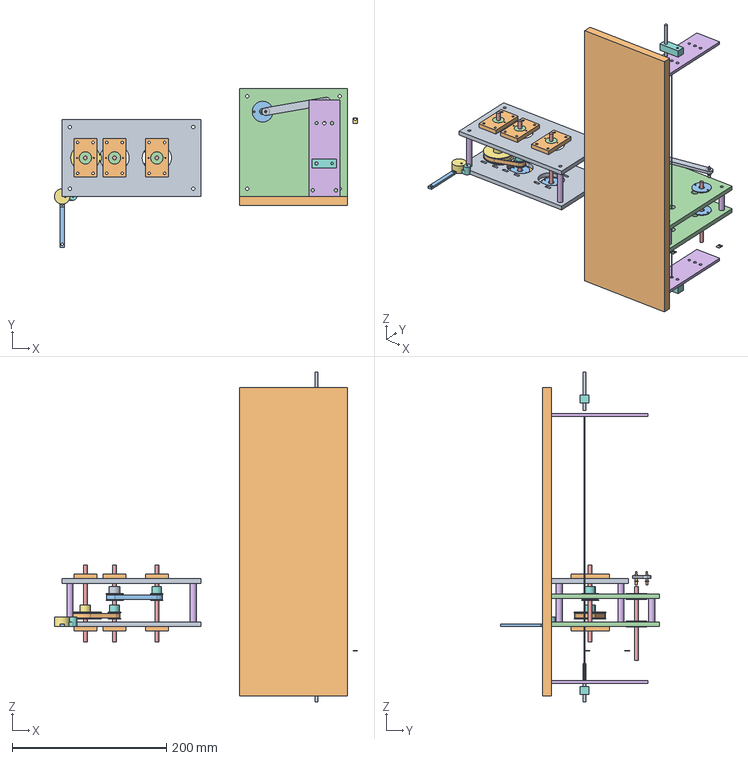
[picture p6: CAD file, 2026-11-06]
outputs/Lovophone_Prototype_A/Prototype_A_Assembly_REFERENCE.step
393.0 x 206.2 x 428.0 mm
