pl-coder/LeLovophon/outputs/Harpe_d_Amour_Clockwork.step

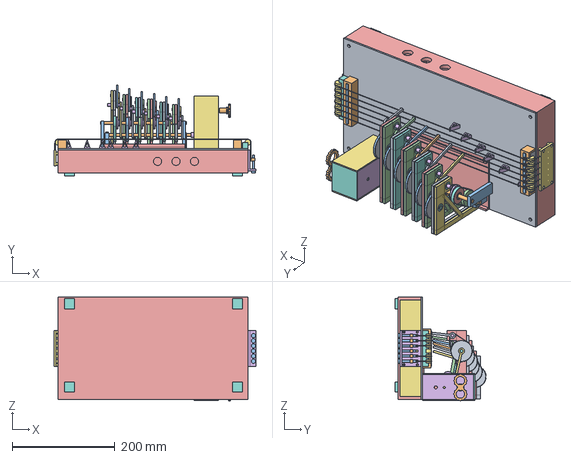
[picture p7: CAD file, 2026-11-06]
outputs/Harpe_d_Amour_Clockwork.step
394.0 x 178.4 x 202.2 mm
