pl-coder/LeLovophon/outputs/LeLovophon_Slender_Bank/LeLovophon_Slender_Bank.step

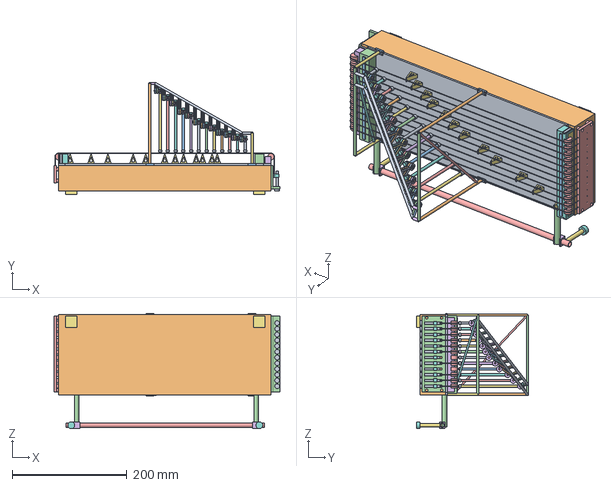
[picture p8: CAD file, 2026-11-06]
outputs/LeLovophon_Slender_Bank/LeLovophon_Slender_Bank.step
394.0 x 195.6 x 201.0 mm
