pl-coder/LeLovophon/outputs/Lovophone_Prototype_A/P04_POMCoupler.step

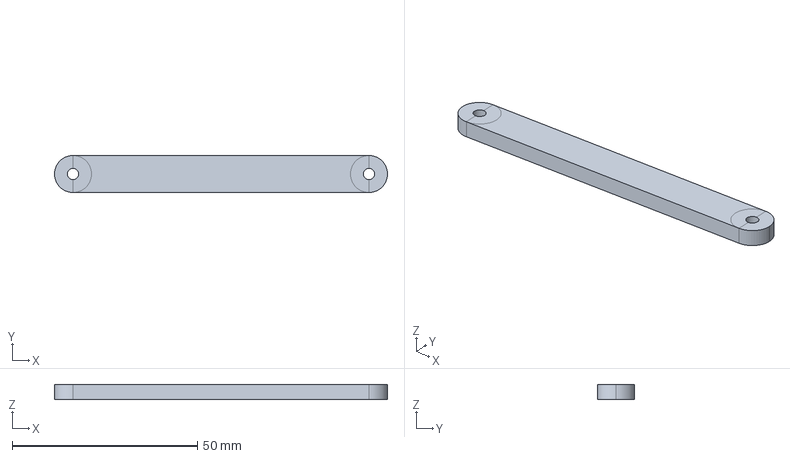
[picture p9: CAD file, 2026-11-06]
outputs/Lovophone_Prototype_A/P04_POMCoupler.step
90.0 x 10.0 x 4.00 mm
