pl-coder/LeLovophon/work/Harpe_d_Amour_Shared_Gantry.FCStd

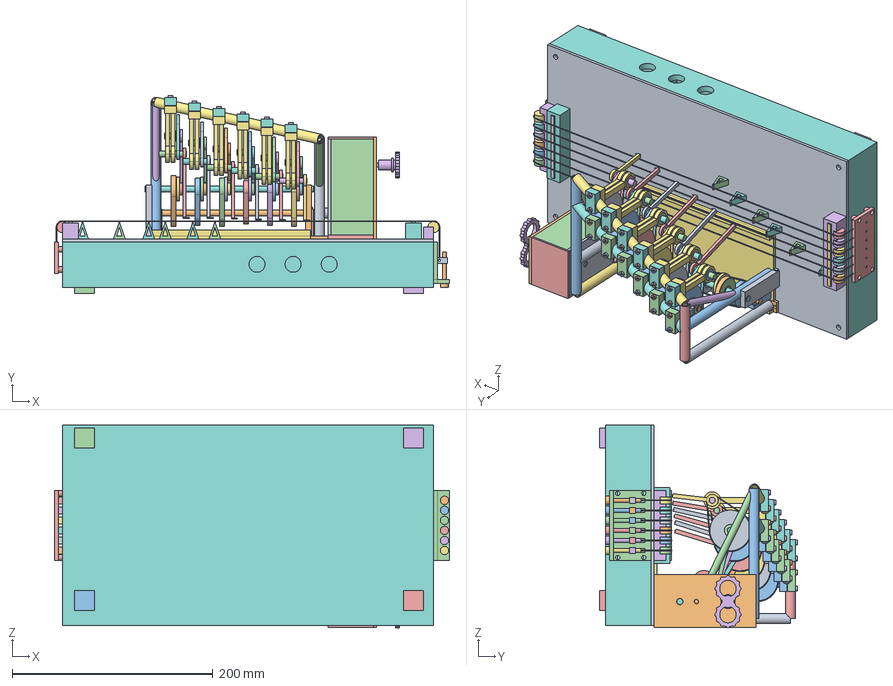
[picture p10: CAD file, 2026-11-06]
work/Harpe_d_Amour_Shared_Gantry.FCStd
394.0 x 197.2 x 202.2 mm
3 mm soundboard lid — removable from plywood rim
Long common drive shaft — input pulleys turn together
LowInputStand0
LowInputBearing0
LowInputStand1
LowInputBearing1
Low belt drive bed
Second long axle — fixed spindle, six independent pulley units
IntermediateAxleStand0
IntermediateAxleStand1
C_PendulumBearing0
C_PendulumBearing1
D_PendulumBearing0
D_PendulumBearing1
E_PendulumBearing0
E_PendulumBearing1
F_PendulumBearing0
F_PendulumBearing1
G_PendulumBearing0
G_PendulumBearing1
A_PendulumBearing0
A_PendulumBearing1
C_FollowerPivotBearing0
C_FollowerPivotBearing1
D_FollowerPivotBearing0
D_FollowerPivotBearing1
E_FollowerPivotBearing0
E_FollowerPivotBearing1
F_FollowerPivotBearing0
F_FollowerPivotBearing1
G_FollowerPivotBearing0
G_FollowerPivotBearing1
A_FollowerPivotBearing0
A_FollowerPivotBearing1
C 2 mm pitch reference pulley — 40 teeth
C 2 mm pitch reference pulley — 40 teeth001
C_CompoundPulleyHub
C_IndependentPulleyBearing
C_EccentricCam
D 2 mm pitch reference pulley — 36 teeth
D 2 mm pitch reference pulley — 32 teeth
D_CompoundPulleyHub
D_IndependentPulleyBearing
D_EccentricCam
E 2 mm pitch reference pulley — 40 teeth
E 2 mm pitch reference pulley — 32 teeth
E_CompoundPulleyHub
E_IndependentPulleyBearing
E_EccentricCam
F 2 mm pitch reference pulley — 32 teeth
F 2 mm pitch reference pulley — 24 teeth
F_CompoundPulleyHub
F_IndependentPulleyBearing
F_EccentricCam
G 2 mm pitch reference pulley — 36 teeth
G 2 mm pitch reference pulley — 24 teeth
G_CompoundPulleyHub
G_IndependentPulleyBearing
G_EccentricCam
C_RaisedArmShaft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
