pl-coder/LeLovophon/outputs/Harpe_d_Amour_Koto_Pendulums.FCStd

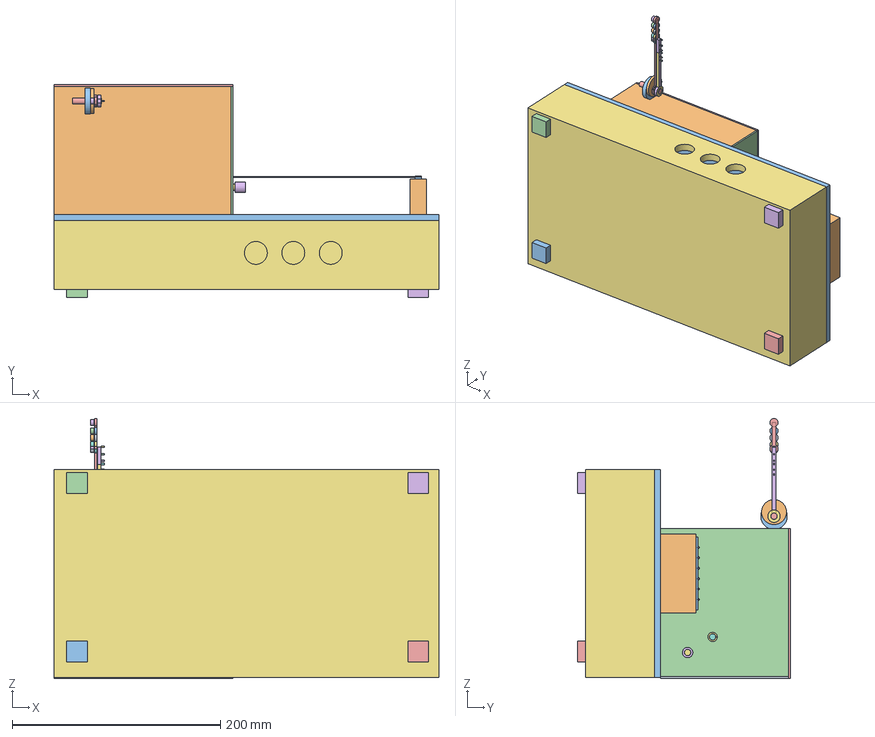
[picture p11: CAD file, 2026-11-06]
outputs/Harpe_d_Amour_Koto_Pendulums.FCStd
370.0 x 205.0 x 249.9 mm
A_CompoundPulleyHub
A_EccentricCam
A_ExtendedArm
A_ExtendedPick
A_FollowerLever
A_FollowerRoller
A_IndependentPulleyBearing
A_KotoAnchorPin
A_KotoAnchorSaddle
A_KotoAnchorTail
A_KotoBackString
A_KotoSpeakingString
A_KotoThirdBridge
A_KotoTunerPin
A_KotoTunerSaddle
A_KotoTunerTail
A_PendulumBearing0
A_PendulumBearing1
A_PendulumBracket0
A_PendulumBracket1
A_RaisedArmShaft
A_RatioBelt
A 2 mm pitch reference pulley — 40 teeth
A 2 mm pitch reference pulley — 24 teeth
A_ReturnSpringEnvelope
A_RollerPin
Soundbox top — 370 x 200 x 6 mm
C_CompoundPulleyHub
C_EccentricCam
C_ExtendedArm
C_ExtendedPick
C_FollowerLever
C_FollowerRoller
C_IndependentPulleyBearing
C_KotoAnchorPin
C_KotoAnchorSaddle
C_KotoAnchorTail
C_KotoBackString
C_KotoSpeakingString
C_KotoThirdBridge
C_KotoTunerPin
C_KotoTunerSaddle
C_KotoTunerTail
C_PendulumBearing0
C_PendulumBearing1
C_PendulumBracket0
C_PendulumBracket1
C_RaisedArmShaft
C_RatioBelt
C 2 mm pitch reference pulley — 40 teeth
C 2 mm pitch reference pulley — 40 teeth001
C_ReturnSpringEnvelope
C_RollerPin
ClockworkInputCoupling
Long common drive shaft — input pulleys turn together
Second long axle — fixed spindle, six independent pulley units
D_CompoundPulleyHub
D_EccentricCam
D_ExtendedArm
D_ExtendedPick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
