pl-coder/LeLovophon/outputs/Harpe_Koto_Geometry_Rescue.step

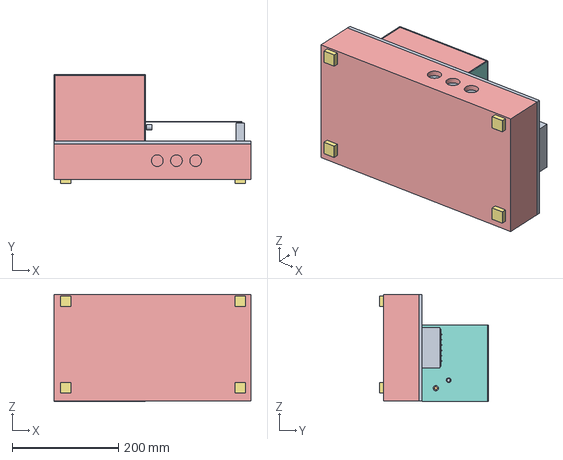
[picture p13: CAD file, 2026-11-06]
outputs/Harpe_Koto_Geometry_Rescue.step
370.0 x 205.0 x 201.0 mm
