pl-coder/LeLovophon/outputs/Lovophone_Prototype_A/P05_Arm_0.step

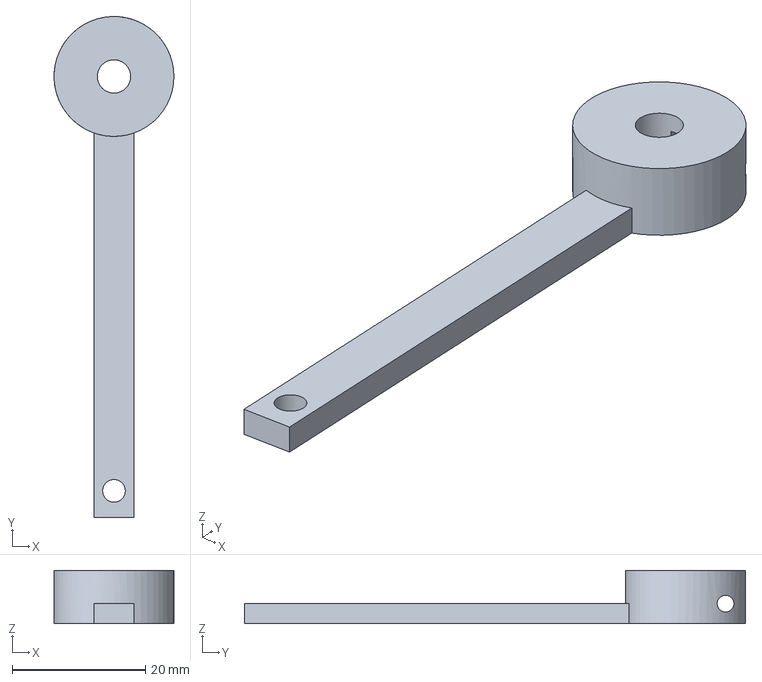
[picture p14: CAD file, 2026-11-06]
outputs/Lovophone_Prototype_A/P05_Arm_0.step
18.0 x 75.2 x 8.00 mm
