pl-coder/LeLovophon/work/Lovophone_Unified_Base.FCStd

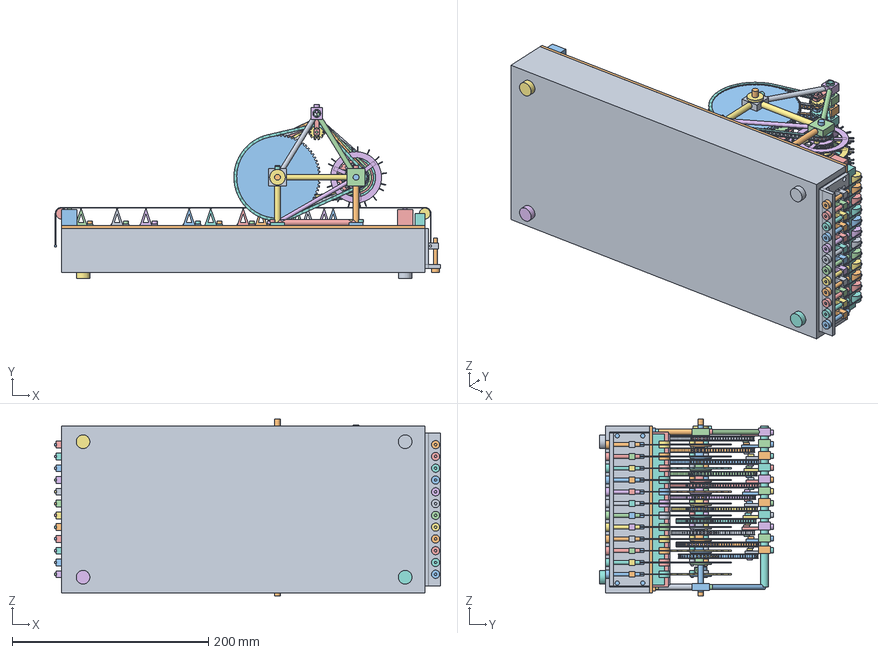
[picture p15: CAD file, 2026-11-06]
work/Lovophone_Unified_Base.FCStd
393.1 x 177.0 x 180.0 mm
170 mm soundbox centred beneath string bank
Common string-load end block
Common string-load end block001
Soundboard mounting rib
Soundboard mounting rib001
Replaceable rubber foot
Replaceable rubber foot001
Replaceable rubber foot002
Replaceable rubber foot003
Spruce soundboard — short bridge-adjustment slots
Common load-bearing anchor block
Rounded common saddle support
Common load-bearing tuner block
Rounded common saddle support001
Common over-edge guide pedestal
Common over-edge guide pedestal001
Common tuner end plate
C3 — KotoSpeakingString
C3 — KotoBackString
C3 — KotoThirdBridge
C3 — NylonBridgeCrown
C3 — LeftNylonGuide
C3 — LeftNylonOverEdge
C3 — RightNylonGuide
C3 — RightNylonOverEdge
C3 — NylonTieShuttle
C3 — M4 pull screw with 2.5 mm hex socket
C3 — NylonTieKnotEnvelope
C3 — AnchorNylonSaddle
C3 — TunerNylonSaddle
D3 — KotoSpeakingString
D3 — KotoBackString
D3 — KotoThirdBridge
D3 — NylonBridgeCrown
D3 — LeftNylonGuide
D3 — LeftNylonOverEdge
D3 — RightNylonGuide
D3 — RightNylonOverEdge
D3 — NylonTieShuttle
D3 — M4 pull screw with 2.5 mm hex socket
D3 — NylonTieKnotEnvelope
D3 — AnchorNylonSaddle
D3 — TunerNylonSaddle
E3 — KotoSpeakingString
E3 — KotoBackString
E3 — KotoThirdBridge
E3 — NylonBridgeCrown
E3 — LeftNylonGuide
E3 — LeftNylonOverEdge
E3 — RightNylonGuide
E3 — RightNylonOverEdge
E3 — NylonTieShuttle
E3 — M4 pull screw with 2.5 mm hex socket
E3 — NylonTieKnotEnvelope
E3 — AnchorNylonSaddle
E3 — TunerNylonSaddle
G3 — KotoSpeakingString
G3 — KotoBackString
G3 — KotoThirdBridge
G3 — NylonBridgeCrown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
