pl-coder/LeLovophon/outputs/Harpe_d_Amour_Wide_Swing.FCStd

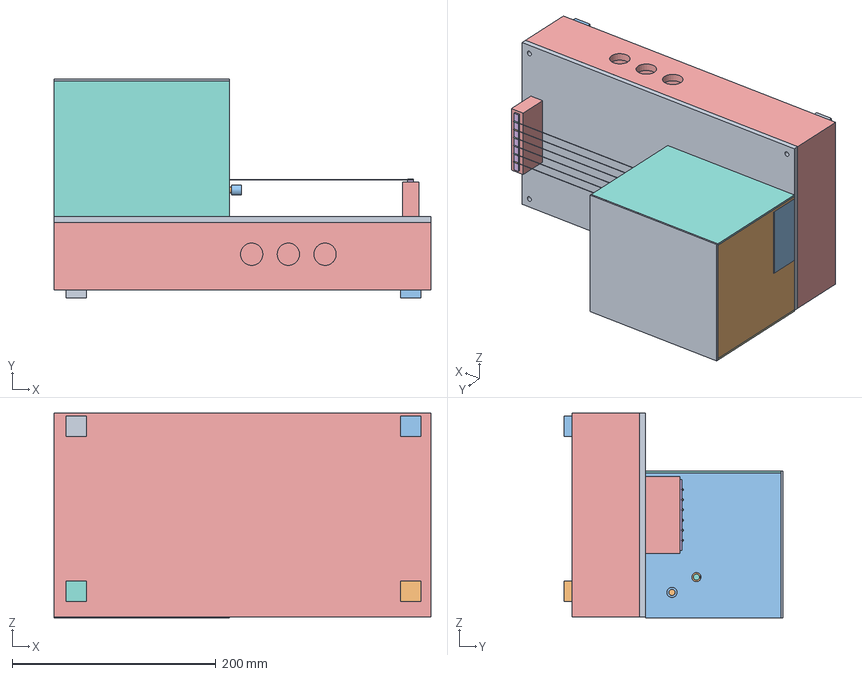
[picture p16: CAD file, 2026-11-06]
outputs/Harpe_d_Amour_Wide_Swing.FCStd
370.0 x 215.0 x 201.0 mm
Soundbox top — 370 x 200 x 6 mm
Long common drive shaft — input pulleys turn together
LowInputStand0
LowInputBearing0
LowInputStand1
LowInputBearing1
Low belt drive bed
Second long axle — fixed spindle, six independent pulley units
IntermediateAxleStand0
IntermediateAxleStand1
C_PendulumBracket0
C_PendulumBearing0
C_PendulumBracket1
C_PendulumBearing1
D_PendulumBracket0
D_PendulumBearing0
D_PendulumBracket1
D_PendulumBearing1
E_PendulumBracket0
E_PendulumBearing0
E_PendulumBracket1
E_PendulumBearing1
F_PendulumBracket0
F_PendulumBearing0
F_PendulumBracket1
F_PendulumBearing1
G_PendulumBracket0
G_PendulumBearing0
G_PendulumBracket1
G_PendulumBearing1
A_PendulumBracket0
A_PendulumBearing0
A_PendulumBracket1
A_PendulumBearing1
ClockworkInputCoupling
C_FollowerPivotBearing0
C_FollowerPivotBearing1
D_FollowerPivotBearing0
D_FollowerPivotBearing1
E_FollowerPivotBearing0
E_FollowerPivotBearing1
F_FollowerPivotBearing0
F_FollowerPivotBearing1
G_FollowerPivotBearing0
G_FollowerPivotBearing1
A_FollowerPivotBearing0
A_FollowerPivotBearing1
C 2 mm pitch reference pulley — 40 teeth
C 2 mm pitch reference pulley — 40 teeth001
C_CompoundPulleyHub
C_IndependentPulleyBearing
C_EccentricCam
D 2 mm pitch reference pulley — 36 teeth
D 2 mm pitch reference pulley — 32 teeth
D_CompoundPulleyHub
D_IndependentPulleyBearing
D_EccentricCam
E 2 mm pitch reference pulley — 40 teeth
E 2 mm pitch reference pulley — 32 teeth
E_CompoundPulleyHub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
