pl-coder/LeLovophon/outputs/Lovophone_Prototype_A/R02_Carrier_0_0.step

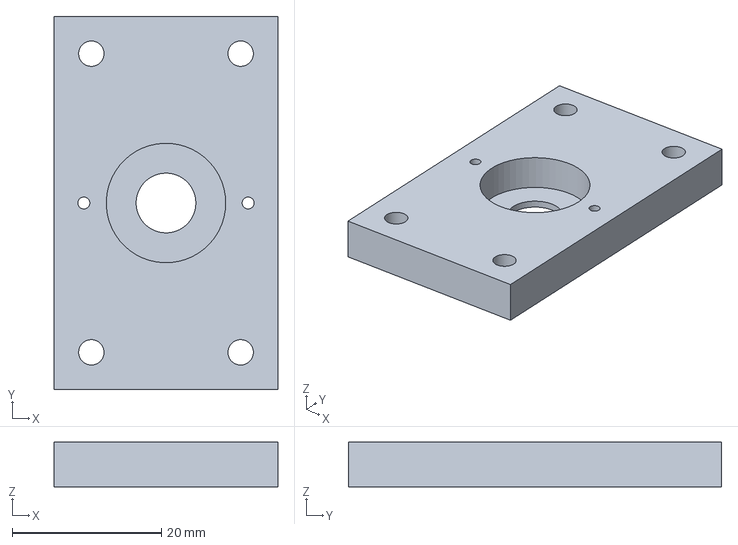
[picture p17: CAD file, 2026-11-06]
outputs/Lovophone_Prototype_A/R02_Carrier_0_0.step
30.0 x 50.0 x 6.00 mm
