pl-coder/LeLovophon/outputs/Lovophone_Prototype_A/P03_Rocker.step

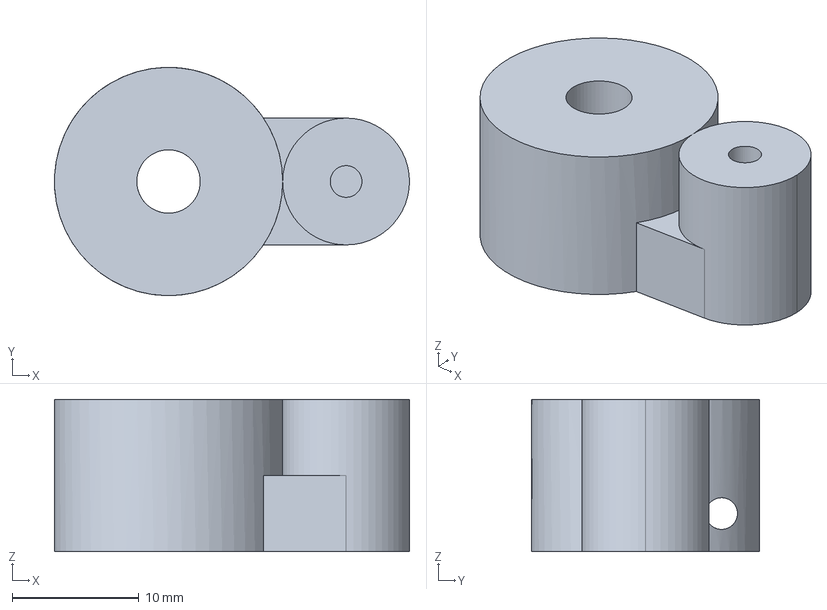
[picture p18: CAD file, 2026-11-06]
outputs/Lovophone_Prototype_A/P03_Rocker.step
28.0 x 18.0 x 12.0 mm
