pl-coder/LeLovophon/outputs/Harpe_recovered_checkpoint.FCStd

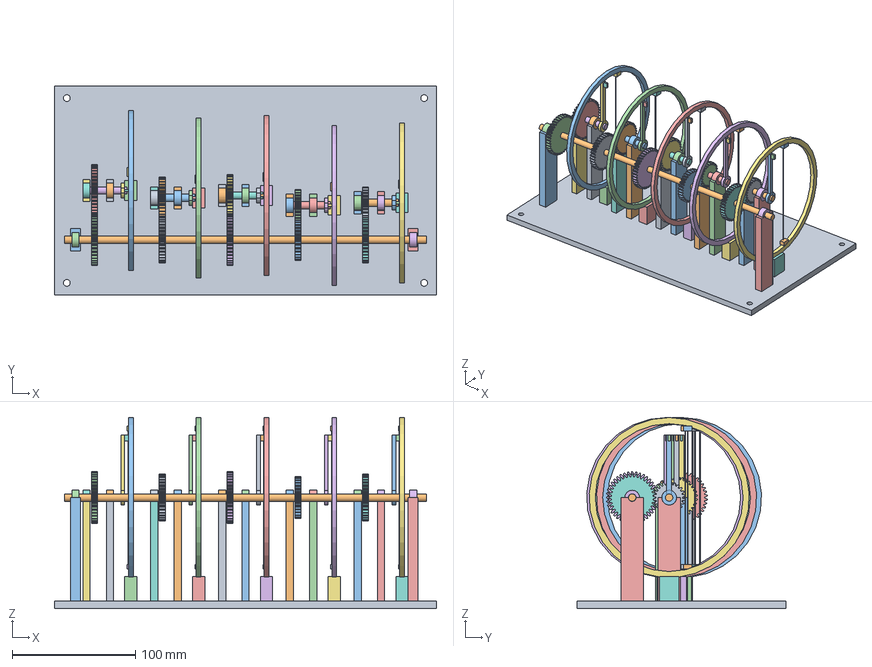
[picture p19: CAD file, 2026-11-06]
outputs/Harpe_recovered_checkpoint.FCStd
310.0 x 170.0 x 155.0 mm
Baseplate_310x170x6
CommonInputShaft_D6
InputPedestal
InputBearingReference
InputPedestal001
InputBearingReference001
C_OutputPedestal
C_BearingReference
C_OutputPedestal001
C_BearingReference001
C_CircularFrame_D130
C_FrameFoot
C_StringReference
C_BridgeReference
C_BridgeReference001
D_OutputPedestal
D_BearingReference
D_OutputPedestal001
D_BearingReference001
D_CircularFrame_D130
D_FrameFoot
D_StringReference
D_BridgeReference
D_BridgeReference001
E_OutputPedestal
E_BearingReference
E_OutputPedestal001
E_BearingReference001
E_CircularFrame_D130
E_FrameFoot
E_StringReference
E_BridgeReference
E_BridgeReference001
F_OutputPedestal
F_BearingReference
F_OutputPedestal001
F_BearingReference001
F_CircularFrame_D130
F_FrameFoot
F_StringReference
F_BridgeReference
F_BridgeReference001
G_OutputPedestal
G_BearingReference
G_OutputPedestal001
G_BearingReference001
G_CircularFrame_D130
G_FrameFoot
G_StringReference
G_BridgeReference
G_BridgeReference001
C_DrivingGear
C_DrivenGear
C_OutputShaft
C_RotatingArm
C_PlectrumReference
D_DrivingGear
D_DrivenGear
D_OutputShaft
D_RotatingArm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
