pl-coder/LeLovophon/outputs/Lovophone_Prototype_A/P07_JournalPin.step

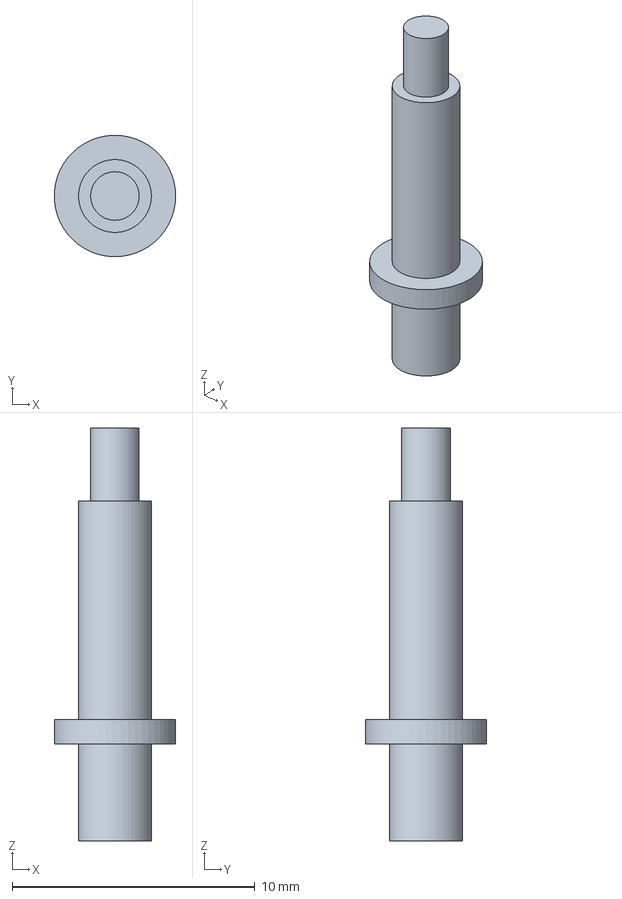
[picture p20: CAD file, 2026-11-06]
outputs/Lovophone_Prototype_A/P07_JournalPin.step
5.00 x 5.00 x 17.0 mm
