pl-coder/LeLovophon/outputs/Harpe_d_Amour_Strings_v2.FCStd

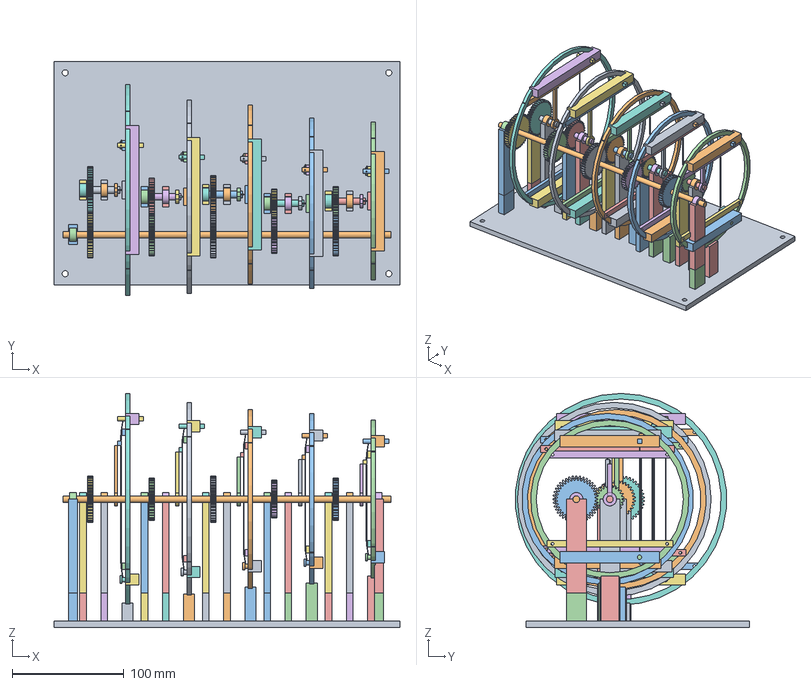
[picture p21: CAD file, 2026-11-06]
outputs/Harpe_d_Amour_Strings_v2.FCStd
310.0 x 209.4 x 209.8 mm
Baseplate — 310 x 200 x 6 mm
CommonInputShaft_D6
InputPedestal
InputBearingReference
InputPedestal001
InputBearingReference001
C_OutputPedestal
C_BearingReference
C_OutputPedestal001
C_BearingReference001
D_OutputPedestal
D_BearingReference
D_OutputPedestal001
D_BearingReference001
E_OutputPedestal
E_BearingReference
E_OutputPedestal001
E_BearingReference001
F_OutputPedestal
F_BearingReference
F_OutputPedestal001
F_BearingReference001
G_OutputPedestal
G_BearingReference
G_OutputPedestal001
G_BearingReference001
InputPedestal_Riser
InputPedestal001_Riser
C_OutputPedestal_Riser
C_OutputPedestal001_Riser
D_OutputPedestal_Riser
D_OutputPedestal001_Riser
E_OutputPedestal_Riser
E_OutputPedestal001_Riser
F_OutputPedestal_Riser
F_OutputPedestal001_Riser
G_OutputPedestal_Riser
G_OutputPedestal001_Riser
C_DrivingGear
C_DrivenGear
C_OutputShaft
C_RotatingArm
C_FlexiblePlectrum
D_DrivingGear
D_DrivenGear
D_OutputShaft
D_RotatingArm
D_FlexiblePlectrum
E_DrivingGear
E_DrivenGear
E_OutputShaft
E_RotatingArm
E_FlexiblePlectrum
F_DrivingGear
F_DrivenGear
F_OutputShaft
F_RotatingArm
F_FlexiblePlectrum
G_DrivingGear
G_DrivenGear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
