pl-coder/LeLovophon/outputs/Lovophone_Prototype_A/P02_BlindCrank.step

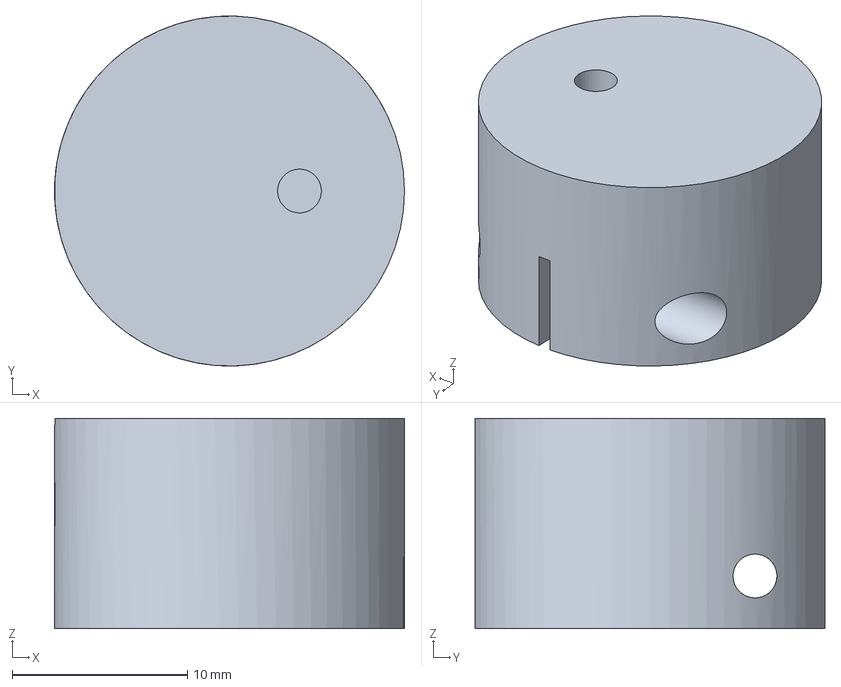
[picture p22: CAD file, 2026-11-06]
outputs/Lovophone_Prototype_A/P02_BlindCrank.step
20.0 x 20.0 x 12.0 mm
