pl-coder/LeLovophon/work/offline_probe.FCStd

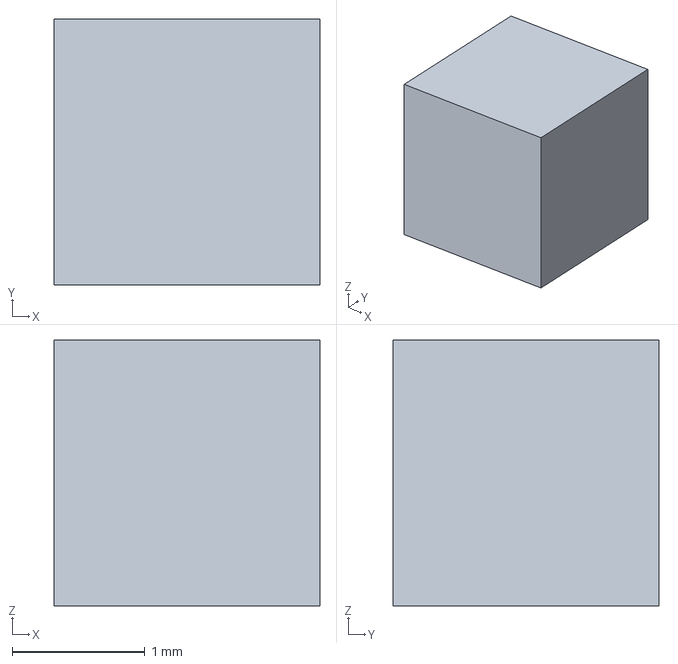
[picture p23: CAD file, 2026-11-06]
work/offline_probe.FCStd
2.00 x 2.00 x 2.00 mm
