pl-coder/LeLovophon/outputs/Harpe_d_Amour_Long_Strings.FCStd

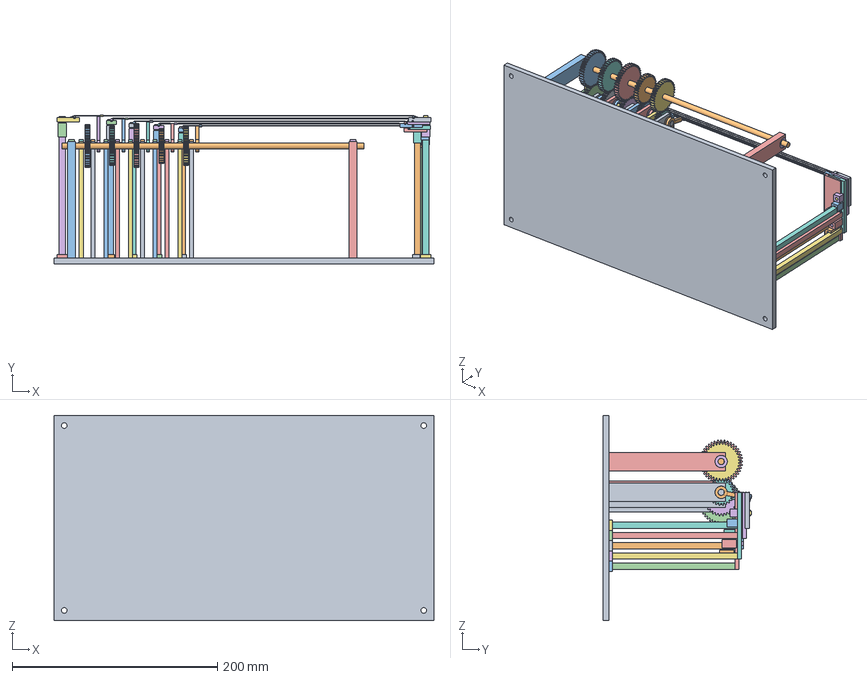
[picture p24: CAD file, 2026-11-06]
outputs/Harpe_d_Amour_Long_Strings.FCStd
370.0 x 144.9 x 200.0 mm
Existing base — X 370 x Z 200 mm; Y vertical
CommonInputShaft_D6
MainBearingStand0
MainBearing0
MainBearingStand1
MainBearing1
C_BankBearingStand0
C_BankBearing0
C_BankBearingStand1
C_BankBearing1
D_BankBearingStand0
D_BankBearing0
D_BankBearingStand1
D_BankBearing1
E_BankBearingStand0
E_BankBearing0
E_BankBearingStand1
E_BankBearing1
F_BankBearingStand0
F_BankBearing0
F_BankBearingStand1
F_BankBearing1
G_BankBearingStand0
G_BankBearing0
G_BankBearingStand1
G_BankBearing1
C_DrivingGear
C_DrivenGear
C_BankOutputShaft
C_BankArm
C_BankPlectrum
D_DrivingGear
D_DrivenGear
D_BankOutputShaft
D_BankArm
D_BankPlectrum
E_DrivingGear
E_DrivenGear
E_BankOutputShaft
E_BankArm
E_BankPlectrum
F_DrivingGear
F_DrivenGear
F_BankOutputShaft
F_BankArm
F_BankPlectrum
G_DrivingGear
G_DrivenGear
G_BankOutputShaft
G_BankArm
G_BankPlectrum
C_LongSpeakingString
C_AnchorFoot
C_AnchorTower
C_AnchorBeam
C_AnchorSaddleCarrier
C_AnchorSaddle
C_AnchorScrew0
C_AnchorScrew1
C_AnchorPinBlock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
