pl-coder/LeLovophon/outputs/Lovophone_Prototype_A/R03_Retainer_0_0.step

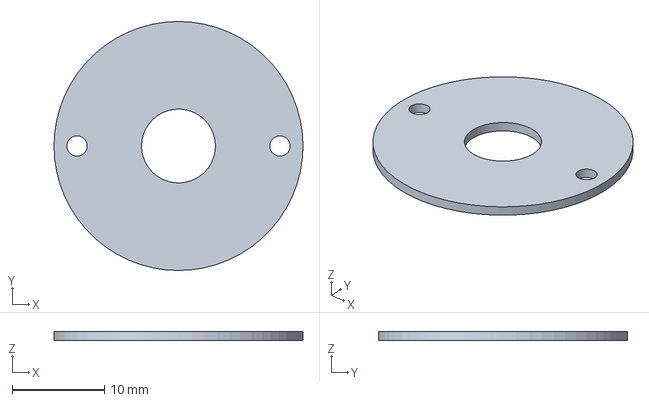
[picture p25: CAD file, 2026-11-06]
outputs/Lovophone_Prototype_A/R03_Retainer_0_0.step
27.0 x 27.0 x 1.00 mm
