pl-coder/LeLovophon/work/Lovophone_Lab_Frame_Base.FCStd

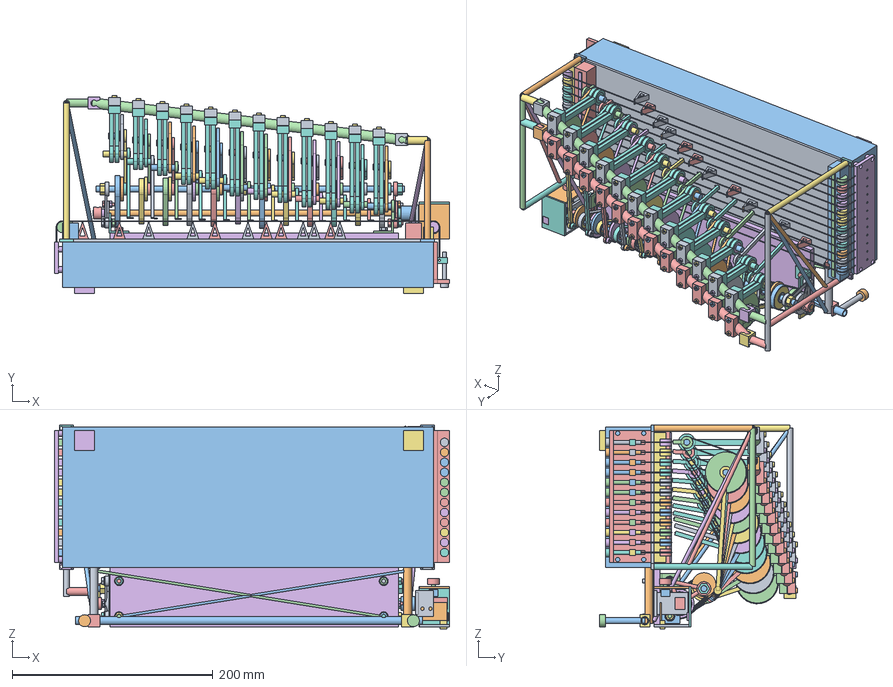
[picture p26: CAD file, 2026-11-06]
work/Lovophone_Lab_Frame_Base.FCStd
394.0 x 197.2 x 203.0 mm
3 mm soundboard lid — removable from plywood rim
Long common drive shaft — input pulleys turn together
Second long axle — fixed spindle, six independent pulley units
C3 — PendulumBearing0
C3 — PendulumBearing1
E3 — PendulumBearing0
E3 — PendulumBearing1
A3 — PendulumBearing0
A3 — PendulumBearing1
C4 — PendulumBearing0
C4 — PendulumBearing1
E4 — PendulumBearing0
E4 — PendulumBearing1
A4 — PendulumBearing0
A4 — PendulumBearing1
C3 — FollowerPivotBearing0
C3 — FollowerPivotBearing1
E3 — FollowerPivotBearing0
E3 — FollowerPivotBearing1
A3 — FollowerPivotBearing0
A3 — FollowerPivotBearing1
C4 — FollowerPivotBearing0
C4 — FollowerPivotBearing1
E4 — FollowerPivotBearing0
E4 — FollowerPivotBearing1
A4 — FollowerPivotBearing0
A4 — FollowerPivotBearing1
D3 — PendulumBearing0
D3 — PendulumBearing1
D3 — FollowerPivotBearing0
D3 — FollowerPivotBearing1
G3 — PendulumBearing0
G3 — PendulumBearing1
G3 — FollowerPivotBearing0
G3 — FollowerPivotBearing1
D4 — PendulumBearing0
D4 — PendulumBearing1
D4 — FollowerPivotBearing0
D4 — FollowerPivotBearing1
G4 — PendulumBearing0
G4 — PendulumBearing1
G4 — FollowerPivotBearing0
G4 — FollowerPivotBearing1
C5 — PendulumBearing0
C5 — PendulumBearing1
C5 — FollowerPivotBearing0
C5 — FollowerPivotBearing1
D5 — PendulumBearing0
D5 — PendulumBearing1
D5 — FollowerPivotBearing0
D5 — FollowerPivotBearing1
C3 — 40 teeth reference
InputLeft — standard 6 mm shaft stop collar
Input collar spacer — 3 mm length of brass tube
C3 — 40 teeth reference001
C3 — CompoundPulleyHub
C3 — IndependentPulleyBearing
C3 — EccentricCam
E3 — 36 teeth reference
E3 — 32 teeth reference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
