pl-coder/LeLovophon/outputs/Lovophone_Prototype_A/P08_TensionDrawbar.step

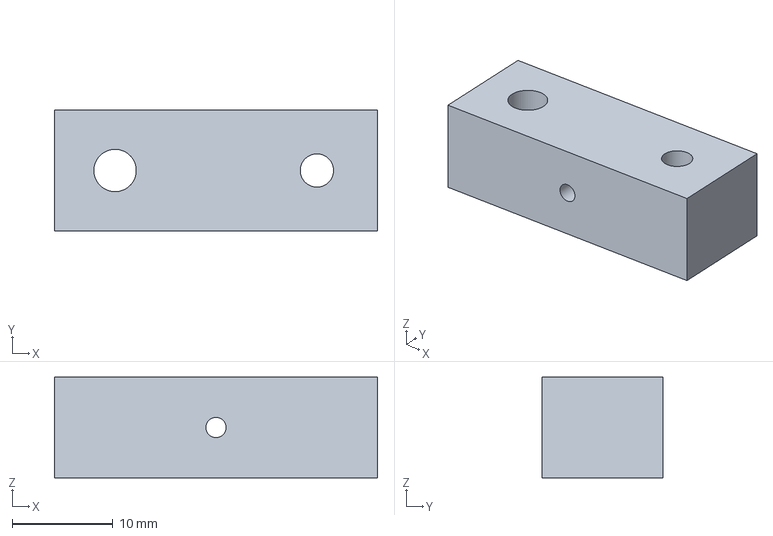
[picture p27: CAD file, 2026-11-06]
outputs/Lovophone_Prototype_A/P08_TensionDrawbar.step
32.0 x 12.0 x 10.0 mm
