pl-coder/LeLovophon/outputs/Harpe_d_Amour_Low_Nylon.step

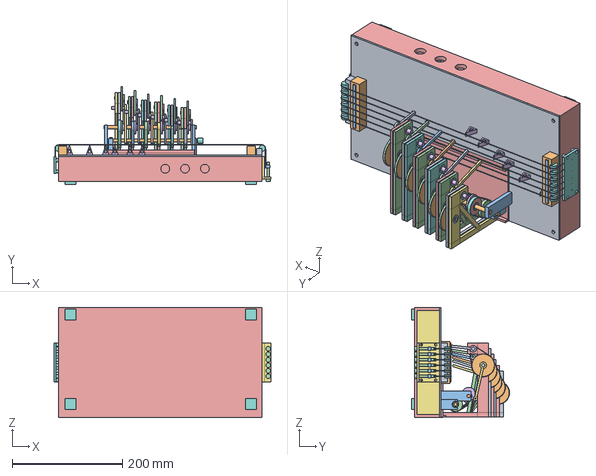
[picture p28: CAD file, 2026-11-06]
outputs/Harpe_d_Amour_Low_Nylon.step
394.0 x 178.4 x 200.0 mm
