pl-coder/LeLovophon/outputs/Lovophone_Prototype_A/R01_Cheek_0.step

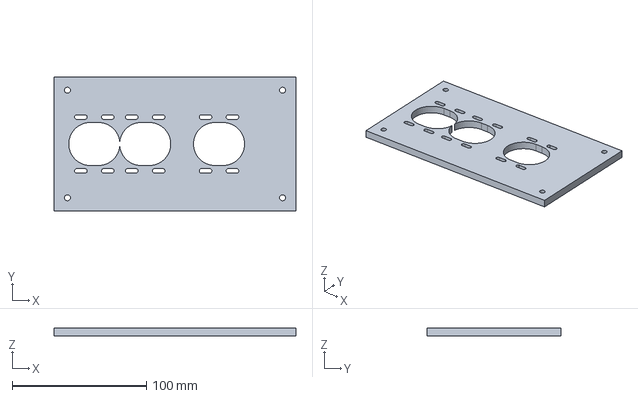
[picture p29: CAD file, 2026-11-06]
outputs/Lovophone_Prototype_A/R01_Cheek_0.step
180.0 x 100.0 x 6.00 mm
