pl-coder/LeLovophon/outputs/Harpe_d_Amour_Low_Gearbox.FCStd

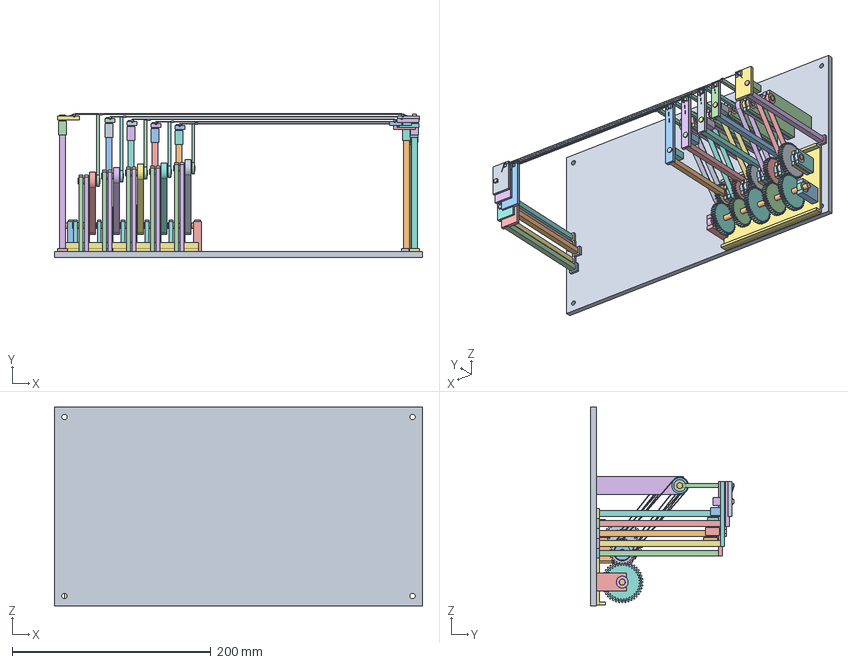
[picture p30: CAD file, 2026-11-06]
outputs/Harpe_d_Amour_Low_Gearbox.FCStd
370.0 x 144.9 x 200.0 mm
Existing base — X 370 x Z 200 mm; Y vertical
Low gearbox input axle
LowInputStand0
LowInputBearing0
LowInputStand1
LowInputBearing1
LowGearboxTray
C_LowerBearingStand0
C_LowerBearing0
C_LowerBearingStand1
C_LowerBearing1
C_RaisedBearingStand0
C_RaisedBearing0
C_RaisedBearingStand1
C_RaisedBearing1
D_LowerBearingStand0
D_LowerBearing0
D_LowerBearingStand1
D_LowerBearing1
D_RaisedBearingStand0
D_RaisedBearing0
D_RaisedBearingStand1
D_RaisedBearing1
E_LowerBearingStand0
E_LowerBearing0
E_LowerBearingStand1
E_LowerBearing1
E_RaisedBearingStand0
E_RaisedBearing0
E_RaisedBearingStand1
E_RaisedBearing1
F_LowerBearingStand0
F_LowerBearing0
F_LowerBearingStand1
F_LowerBearing1
F_RaisedBearingStand0
F_RaisedBearing0
F_RaisedBearingStand1
F_RaisedBearing1
G_LowerBearingStand0
G_LowerBearing0
G_LowerBearingStand1
G_LowerBearing1
G_RaisedBearingStand0
G_RaisedBearing0
G_RaisedBearingStand1
G_RaisedBearing1
C_DrivingGear
C_DrivenGear
C_LowOutputShaft
C_LowerTimingPulley
D_DrivingGear
D_DrivenGear
D_LowOutputShaft
D_LowerTimingPulley
E_DrivingGear
E_DrivenGear
E_LowOutputShaft
E_LowerTimingPulley
F_DrivingGear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
