pl-coder/LeLovophon/outputs/Lovophone_Prototype_A/P05_Arm_1.step

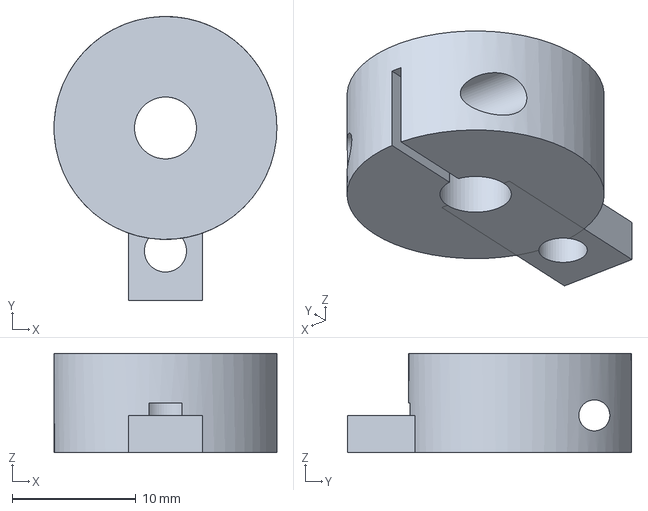
[picture p31: CAD file, 2026-11-06]
outputs/Lovophone_Prototype_A/P05_Arm_1.step
18.0 x 22.9 x 8.00 mm
