pl-coder/LeLovophon/outputs/Lovophone_Unified_160min.step

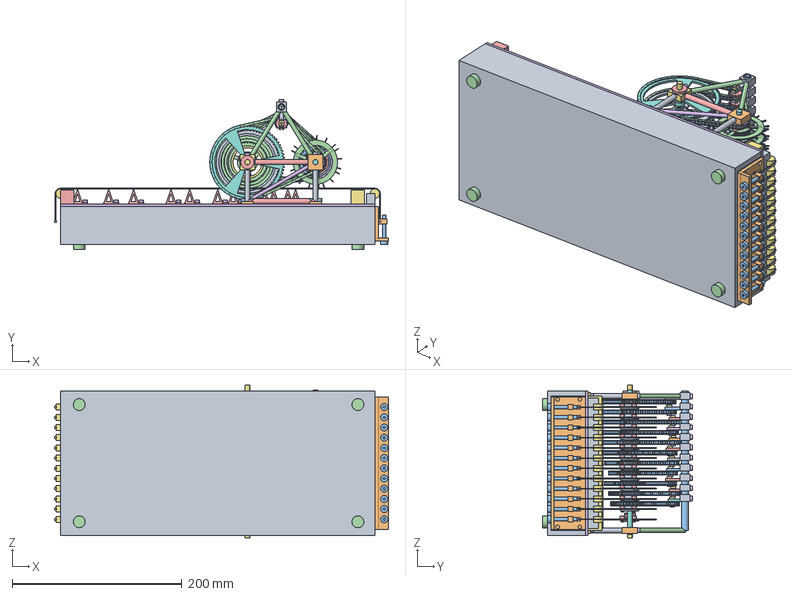
[picture p32: CAD file, 2026-11-06]
outputs/Lovophone_Unified_160min.step
393.1 x 177.0 x 180.0 mm
