pl-coder/LeLovophon/outputs/Lovophone_Prototype_A/P01_LinkageCheek_0.step

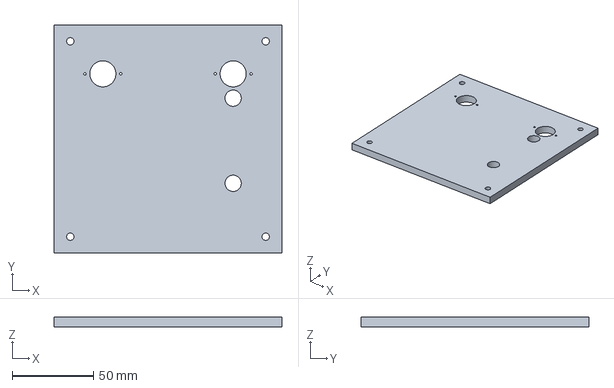
[picture p33: CAD file, 2026-11-06]
outputs/Lovophone_Prototype_A/P01_LinkageCheek_0.step
140.0 x 140.0 x 6.00 mm
