pl-coder/LeLovophon/outputs/Harpe_d_Amour_Two_Axle_Belts.FCStd

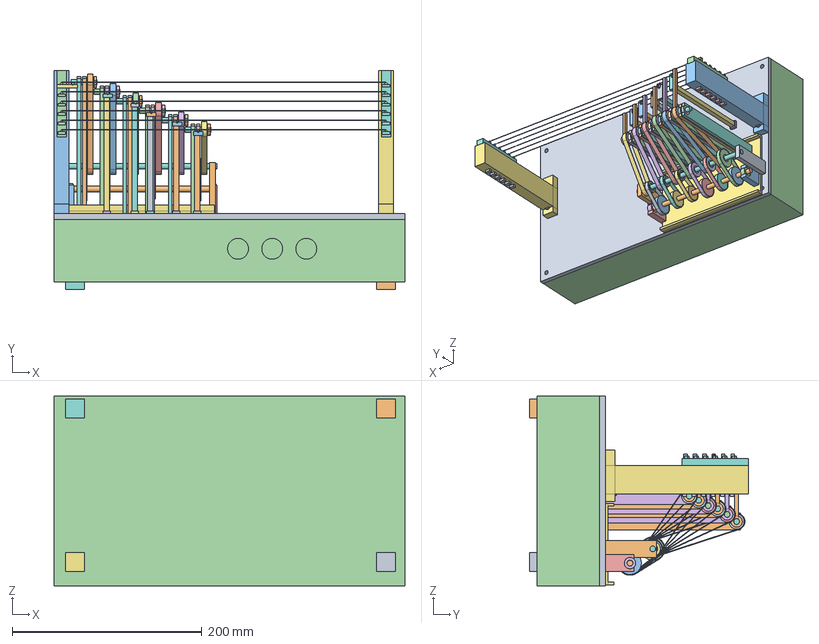
[picture p34: CAD file, 2026-11-06]
outputs/Harpe_d_Amour_Two_Axle_Belts.FCStd
370.0 x 231.0 x 200.0 mm
Soundbox top — 370 x 200 x 6 mm
Long common drive shaft — input pulleys turn together
LowInputStand0
LowInputBearing0
LowInputStand1
LowInputBearing1
Low belt drive bed
C_RaisedBearingStand0
C_RaisedBearing0
C_RaisedBearingStand1
C_RaisedBearing1
D_RaisedBearingStand0
D_RaisedBearing0
D_RaisedBearingStand1
D_RaisedBearing1
E_RaisedBearingStand0
E_RaisedBearing0
E_RaisedBearingStand1
E_RaisedBearing1
F_RaisedBearingStand0
F_RaisedBearing0
F_RaisedBearingStand1
F_RaisedBearing1
G_RaisedBearingStand0
G_RaisedBearing0
G_RaisedBearingStand1
G_RaisedBearing1
A_RaisedBearingStand0
A_RaisedBearing0
A_RaisedBearingStand1
A_RaisedBearing1
Second long axle — fixed spindle, six independent pulley units
IntermediateAxleStand0
IntermediateAxleStand1
C_RatioDrivePulley
C_RatioDrivenPulley
C_CompoundPulleyHub
C_IndependentPulleyBearing
C_LowerTimingPulley
D_RatioDrivePulley
D_RatioDrivenPulley
D_CompoundPulleyHub
D_IndependentPulleyBearing
D_LowerTimingPulley
E_RatioDrivePulley
E_RatioDrivenPulley
E_CompoundPulleyHub
E_IndependentPulleyBearing
E_LowerTimingPulley
F_RatioDrivePulley
F_RatioDrivenPulley
F_CompoundPulleyHub
F_IndependentPulleyBearing
F_LowerTimingPulley
G_RatioDrivePulley
G_RatioDrivenPulley
G_CompoundPulleyHub
G_IndependentPulleyBearing
G_LowerTimingPulley
C speaking segment — 330.00 mm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
