pl-coder/LeLovophon/outputs/Lovophone_Prototype_A/P06_EndPost.step

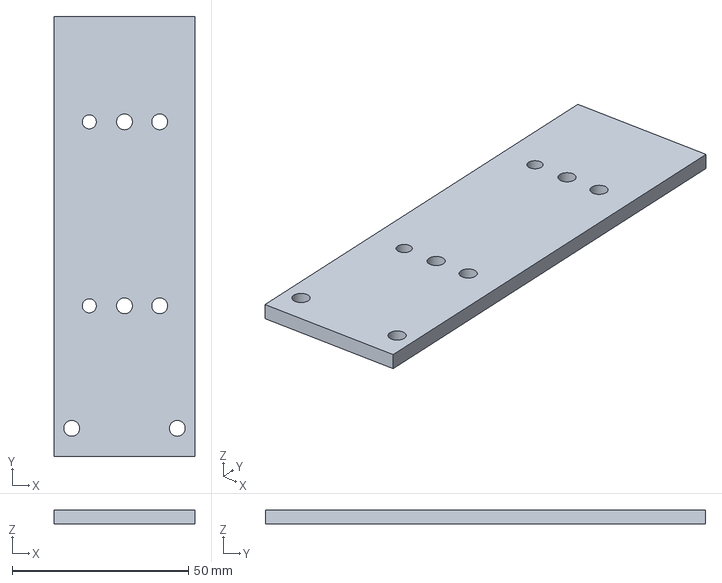
[picture p35: CAD file, 2026-11-06]
outputs/Lovophone_Prototype_A/P06_EndPost.step
40.0 x 125.0 x 4.00 mm
