pl-coder/LeLovophon/outputs/Harpe_d_Amour_Open_Centred_Live.FCStd

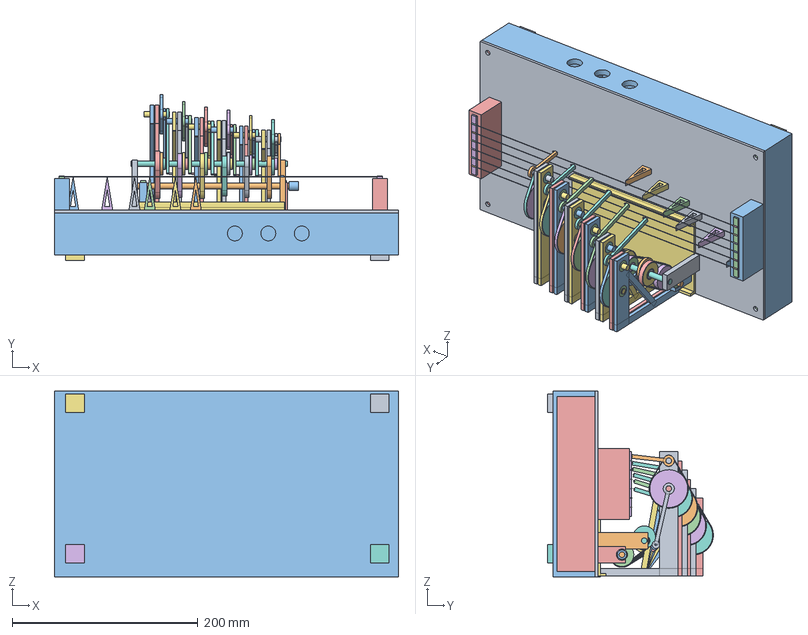
[picture p36: CAD file, 2026-11-06]
outputs/Harpe_d_Amour_Open_Centred_Live.FCStd
370.0 x 178.4 x 200.0 mm
3 mm soundboard lid — removable from plywood rim
Long common drive shaft — input pulleys turn together
LowInputStand0
LowInputBearing0
LowInputStand1
LowInputBearing1
Low belt drive bed
Second long axle — fixed spindle, six independent pulley units
IntermediateAxleStand0
IntermediateAxleStand1
C 4 mm aluminium bearing plate — braced
C_PendulumBearing0
C 4 mm aluminium bearing plate
C_PendulumBearing1
D 4 mm aluminium bearing plate — braced
D_PendulumBearing0
D 4 mm aluminium bearing plate
D_PendulumBearing1
E 4 mm aluminium bearing plate — braced
E_PendulumBearing0
E 4 mm aluminium bearing plate
E_PendulumBearing1
F 4 mm aluminium bearing plate — braced
F_PendulumBearing0
F 4 mm aluminium bearing plate
F_PendulumBearing1
G 4 mm aluminium bearing plate — braced
G_PendulumBearing0
G 4 mm aluminium bearing plate
G_PendulumBearing1
A 4 mm aluminium bearing plate — braced
A_PendulumBearing0
A 4 mm aluminium bearing plate
A_PendulumBearing1
ClockworkInputCoupling
C_FollowerPivotBearing0
C_FollowerPivotBearing1
D_FollowerPivotBearing0
D_FollowerPivotBearing1
E_FollowerPivotBearing0
E_FollowerPivotBearing1
F_FollowerPivotBearing0
F_FollowerPivotBearing1
G_FollowerPivotBearing0
G_FollowerPivotBearing1
A_FollowerPivotBearing0
A_FollowerPivotBearing1
C removable module shoe — two M4 fixing holes
D removable module shoe — two M4 fixing holes
E removable module shoe — two M4 fixing holes
F removable module shoe — two M4 fixing holes
G removable module shoe — two M4 fixing holes
A removable module shoe — two M4 fixing holes
C 2 mm pitch reference pulley — 40 teeth
C 2 mm pitch reference pulley — 40 teeth001
C_CompoundPulleyHub
C_IndependentPulleyBearing
C_EccentricCam
D 2 mm pitch reference pulley — 36 teeth
D 2 mm pitch reference pulley — 32 teeth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
