pl-coder/LeLovophon/(list of files, cad)

Other CAD files:
outputs/LeLovophon_Direct_Gear_Prototype/Axle_Clearance_Revision/LeLovophon_Direct_Gear_Prototype.FCStd
outputs/Lovophone_Prototype_A/Lovophone_Prototype_A.FCStd
work/Pentatonic_PreRelief.FCStd
outputs/Harpe_d_Amour_Koto_Recovered.FCStd
work/Lovophone_Hardware_Frame_Base.FCStd
work/Harpe_d_Amour_Twelve_Motor_Base.FCStd
outputs/Lovophone_Pentatonic.step
outputs/Lovophone_Lab_Frame_Ratio_Review.FCStd
outputs/Harpe_d_Amour_Open_Centred.FCStd
outputs/Harpe_d_Amour_Study.FCStd
outputs/Lovophone_Lab_Frame.step
outputs/Harpe_d_Amour_Wide_Swing_Live.FCStd
outputs/Harpe_d_Amour_Twelve_Electric.step
outputs/Lovophone_Hardware_Frame.step
outputs/Harpe_d_Amour_Live.FCStd
outputs/Harpe_d_Amour_Portable.step
outputs/Harpe_d_Amour_Koto_Live.FCStd
outputs/Harpe_Koto_Geometry_Rescue.FCStd
outputs/Harpe_d_Amour_Clockwork.FCStd
outputs/Harpe_d_Amour_Low_Nylon.FCStd
outputs/Harpe_d_Amour_Portable.FCStd
outputs/Harpe_d_Amour_Twelve_Electric.FCStd
outputs/LeLovophon_Slender_Bank/LeLovophon_Slender_Bank.FCStd
outputs/Lovophone_Hardware_Frame.FCStd
outputs/Lovophone_Lab_Frame.FCStd
outputs/Lovophone_Pentatonic.FCStd
outputs/Lovophone_Unified_160min.FCStd
