pl-coder/LeLovophon/outputs/Lovophone_Pentatonic_Setup.md

# Lovophone pentatonic audition

Use Lovophone_Pentatonic_8min_Bitwig.mid for a first listen, or Lovophone_Pentatonic_160min_Bitwig.mid for the whole existing timing cycle. Set tempo to 120 BPM; do not quantize.

On every string track: Micro-pitch, then a Bitwig instrument. Drag Lovophone_Pentatonic_Bitwig.scl onto Micro-pitch. Root C, Amount 100%, reference 440 Hz. Replace the previous tuning rather than stacking another Micro-pitch. The supplied MIDI uses only C D E G A. The file has 12 entries to meet Bitwig's import requirements; the seven unused pitch classes remain equal tempered.

Alternatively, use the Just_Intonation MIDI copies with a pitch-bend-aware instrument and no Scala/Micro-pitch tuning. These contain independent channel pitch bends with a +/-2 semitone range. Do not combine the two tuning methods.

String order, low to high: C3 D3 E3 G3 A3 C4 D4 E4 G4 A4 C5 D5 (MIDI 48 50 52 55 57 60 62 64 67 69 72 74). These are scientific octave names; your DAW may display different octave numbers. The approved range is now represented in Lovophone_Pentatonic.FCStd with proportional bridge and arm lengths. Actual nylon gauge and tension still need a physical setup.

Pure pitch ratios within each octave: C 1, D 9/8, E 5/4, G 3/2, A 5/3. Notes retain the original 2-second MIDI duration, velocity and each mechanism's actual trigger schedule so the pitch change can be compared directly. Adjust your instrument's decay for a plucked sound.

The 160-minute file uses the retained rhythmic drive cycle. Its timing ratios are deliberately independent of the new pitch ratios, matching the revised machine. Lovophone_Pentatonic.FCStd now implements these approved pitches: bridge and arm lengths are changed, transmission belt paths and motor mounting are revised, and the complete mechanism is shifted 16 mm toward the tuning end. The original rhythmic drive ratios and cam/follower geometry remain unchanged. The eight-minute file is an excerpt, not a complete repeat.
