pl-coder/LeLovophon/(commit log)

2026-11-06 Publish Le Lovophon CAD and prototype engineering project without media
    [Harpe_Koto_Geometry_Rescue.FCStd, Harpe_Koto_Geometry_Rescue.step, Harpe_d_Amour_Aligned_Strings.FCStd, Harpe_d_Amour_Axial.FCStd, Harpe_d_Amour_Clockwork.FCStd, Harpe_d_Amour_Clockwork.step, Harpe_d_Amour_Koto_Live.FCStd, Harpe_d_Amour_Koto_Pendulums.FCStd]
2026-11-06 Study longer proportional pendula with a slender close-packed support bank
    [LeLovophon_Slender_Bank.FCStd, LeLovophon_Slender_Bank.step, Slender_Bank_Dimensions.csv]
2026-11-09 Add corrected direct-gear prototype and music/render recipes
    [Assembly_REFERENCE_NOT_FOR_MACHINING.step, BOM_Engineering_Candidates.csv, LeLovophon_8min_Pluck_Times.csv, LeLovophon_Direct_Gear_Prototype.FCStd, Voice_Dimensions.csv]
